myfines/d-dfdf/docs/external-reviews/report-20261020.md

# Tang Primer 20K 电子乐器 · 2026-10-20 实物测试报告

**一句话结论**：核心音频链路（合成、复音、音准比例、延迟、时钟）全部通过实测；发现一个影响作品听感的实质缺陷——**摇杆零位偏移导致整体音高偏 9 音分、所有音色被掺入约 20% 锯齿波**，建议固化前修复。

## 一、测试对象与环境

| 项 | 内容 |
|---|---|
| 板卡 | Tang Primer 20K（GW2A-18C-PBGA256）+ Dock，JTAG ID `0x0000081B` |
| 固件 | Flash 中八路光键版（`SAFE_STARTUP=1`、`ENABLE_OPTICAL=1`） |
| 外设 | PCM5102A、ADS1015 摇杆、四键 S0–S3、八路光键模块（I²C 0x12） |
| 主机 | Windows，串口 115200-8-N-1（COM5 → COM7，断电后重枚举） |
| 测量工具 | 自研 UART 遥测解码、FPGA 内部计时码流、手机录音频谱分析 |

## 二、方法：三条独立证据链

1. **遥测**：固件每 250 ms 输出一帧 `IO V E X YYY K S`，解码后得到 ADC 状态、按键、模式位；
2. **自测量码流**：为测延迟专门编译 `latency_selftime`，用 27 MHz 计数器测"引脚边沿 → 首样本"，经 UART 输出，不依赖示波器；
3. **录音频谱**：手机录制 → ffmpeg 转 WAV → FFT/Welch 分析音准、谐波、谱峰。

## 三、结果

### 3.1 启动与安全启动（通过）

| 事件 | 时刻 | 关键帧 |
|---|---|---|
| 上电出帧 | 0.11 s | `IO V0 E0 XFFF Y000 KF S11`（未解锁，PCM 高阻） |
| 解锁 | 25.59 s | `IO V1 E0 X34F Y001 K9`（ADC 有效、四键可演奏） |
| 光键上线 | 解锁后 20.0 s（`OPTICAL_BOOT_TICKS`/27 MHz） | `Y=800` |
| 光键拔线回退 | 1.2 s 内 | `X` 回到摇杆 ADC 值 |

帧周期实测 **250.0 ms，无丢帧**，即 27 MHz 时钟准确（若偏 0.5% 会显示 251.3 ms）。

### 3.2 输入通道（全部通过）

按键 `K` 值出现 `D/9/B/6/7/E`；摇杆 X 在 255–991 间连续变化；八路光键 `0x0FF↔0x0F7/0x0FB/0x0BF/…` 正常触发；断连后自动回退四键演奏。

### 3.3 演奏与参数控制（全部通过）

音色循环 `timbre 0→1→2→0`；音组 `page 0→1→2→0`；低八度 `oct` 翻转；短延迟 `echo` 翻转；ADSR 编辑 `edit` 进出（编辑时演奏静音）；32 声部 `test32` 翻转。

### 3.4 音准（通过：音程误差 ≤0.24 音分）

| 音 | 实测 | RTL 设计值 | 与 C5 的比值（实测 / 理想） | 误差 |
|---|---|---|---|---|
| C5 | 526.0 Hz | 523.17 | — | — |
| D5 | 590.4 Hz | 587.35 | 1.12243 / 1.12246 | **−0.05 音分** |
| E5 | 662.8 Hz | 659.20 | 1.26008 / 1.25992 | **+0.22 音分** |
| G5 | 788.0 Hz | 783.90 | 1.49810 / 1.49831 | **−0.24 音分** |

绝对频率整体偏高 0.53%（≈+9 音分），原因见第四节。

### 3.5 四复音（通过）

四键同时按住，频谱中同时存在 **4 个独立基频**，幅度差 3.2 dB 以内：

| 频率 | 音名 | 偏差 | 相对幅度 |
|---|---|---|---|
| 554.2 Hz | C#5 | +0.4 音分 | −2.7 dB |
| 622.2 Hz | D#5 | 0.0 音分 | −1.0 dB |
| 698.5 Hz | F5 | +0.1 音分 | −3.2 dB |
| 740.0 Hz | F#5 | 0.0 音分 | 0 dB |

四键和弦频谱

> 该次录音处于"音组 1"（C#5/D#5/F5/F#5），非默认音组 0。

### 3.6 32 声部（通过）

测试模式下 32 个振荡器（129 Hz 起、间隔 31 Hz 至 1090 Hz）逐一检出，各频点电平 −29…0 dB，间距精确 31 Hz：

32 声部频点

数字侧另经核算确认：单声部乘积 ≤±8.4M，32 路累加 ≤±268M，31 位累加器无溢出；输出幅度 ±8192（−12 dBFS）。

### 3.7 音色（功能通过，证据受污染）

三段录音的谐波含量依次递增（2 次谐波 −14.1 / −13.8 / −6.8 dB；3 次 −36.0 / −29.8 / −21.9 dB），确实存在三个不同音色，但基准波形已被摇杆 Y 偏移污染（见第四节），不能作为"纯三角/正弦/锯齿"的干净证据。

### 3.8 端到端延迟（通过，余量 10–30 倍）

37 次按键，测得"引脚边沿 → 首样本锁存"为 **1–571 周期（0.04–21.15 µs）**，平均 9.75 µs；直方图在一帧内近似均匀（每格 6.2 次期望 vs 实测 4–10 次）：

延迟分布

加 I²S 串行化 10.67 µs 后，**FPGA 数字端到端 10.7–31.8 µs（平均 20.4 µs）**；叠加 PCM5102A 滤波群延迟后仍 **< 1 ms**，相对赛题 10 ms 上限余量约 10–30 倍。

### 3.9 时钟（通过）

BCK 1.5 MHz、LRCK 46.875 kHz，比值 32:1；由遥测帧周期反证主时钟准确。

## 四、发现的问题（按严重度）

| # | 问题 | 证据 | 影响 |
|---|---|---|---|
| **1** | **摇杆零位偏移** | X 静止 ≈845（中心 825，偏 +20～+44）；Y 静止偏 ≈330 | 弯音死区仅 ±25 计数，超出后**音高整体偏 +9 音分**；Y 偏移使 `mix≈20%`，**所有预设都被掺入约 20% 锯齿波** |
| 2 | 测试模式低频噪声 | 40–200 Hz 宽带，峰值 60–68 Hz，比单音高 15 dB | 仅出现在 32 声部测试模式，正常演奏无；数字侧已排除，疑为模拟侧或录音链路 |
| 3 | 光键静止偶发多键同按 | 出现过 `0x03F`（6 路同按） | 疑为模块未按实际高度校准 |
| 4 | 音色间音高不一致 | 554.3 / 560.2 / 559.5 Hz | 同问题 1，按摇杆时位置微动所致 |

## 五、未测项与限制

- **模拟段延迟**：PCM5102A 滤波群延迟未实测（探头受地线耦合干扰，数据线空闲时仍有 ~680 mV 梳齿）；
- **温升与电流**：未测量（此前有"30 秒烫手"历史记录，原因未定论）；
- **绝对音准**：无标准参考源，现有设备无法标定；
- **冷启动重复性与长时间稳定性**：本次未做（计划中）；
- 所有音频结论基于**手机录音**，非线路输入测量。

## 六、结论与建议

**可以进入提交阶段的功能**：合成引擎、四复音、音阶音程、32 声部、参数控制、安全启动、延迟指标。

**固化前建议修复**（改动约 10 行）：上电时采集 X/Y 静止值作为零点，之后 `delta = x − zero`。可同时解决音高偏移与音色掺锯齿，且不影响摇杆正常使用。

**演示注意事项**：① 演示前确认摇杆居中（遥测 `X` 接近 `0x339`）；② 音色切换必须在不按 S 键时短点摇杆；③ 32 声部测试放在最后。

## 附：本次产物

| 类别 | 路径 |
|---|---|
| 原始遥测 | `logs/*.txt` |
| 录音与图 | `logs/audio/*.wav`、`logs/audio/chord4-spectrum.png`、`logs/audio/spectrum32.png`、`logs/latency-histogram.png` |
| 分析脚本 | `scripts/analyze-uart-log.py`、`scripts/analyze-audio.py`、`scripts/analyze-session.py`、`scripts/prepare-audio.ps1` |
| 延迟测量码流 | `latency/latency_selftime.v`（SHA256 `DA9BE9066343C27044F97FF885D213405E20A4E20E05C73E2B8AFED90AB1DFD3`，仅 SRAM） |
