myfines/d-dfdf/docs/k230-uart-sender-20261022.md

# K230 UART手势发送候选（2026-10-22）

状态：仅生成电脑端文件，未部署、未访问设备、未改FPGA、Android或Flash。Dock OTG保留供电，数据改用UART；不再要求FPGA USB host。

## 接口和接线

| 项目 | 候选约定 |
|---|---|
| 外设 | K230 UART1 |
| TX | EXPORT接口IO9，复用UART1_TXD/TX1 |
| RX | IO10不接、不配置其复用 |
| 串口 | 115200 baud，8数据位，无校验，1停止位 |
| 接线 | K230 IO9 → FPGA RX；K230 GND → FPGA GND |
| FPGA RX | 对方暂定PMOD1 M14，最终封装脚、连接器脚位及电气核对由FPGA侧完成 |
| 供电 | 继续Dock OTG → K230 Type-C；EXPORT 5V、3V3均不互连 |

亚博标准板YB-DKA02-V1.0说明书正面图片中，右侧EXPORT位于Type-C上方，该视角丝印从上到下为5V、GND、IO9、IO10。背面复用表为IO9 TX1、IO10 RX1。以实物丝印识别，不按线色或镜像后的插头序号接线。

**电平证据边界：**已核实TX映射，但目前找到的亚博UART PDF只泛指TTL可能为3.3V/5V；FPIOA PDF的“12：3.3v输出”描述电源脚，不能证明IO9高电平。尚无该板IO9电压实测或明确电源域原理图证据。接FPGA前确认IO9高电平符合FPGA输入电源域；不能把5V信号接入FPGA。电压不匹配需电平转换。供电能启动不代表信号电压已验证。

## 数据契约

复用docs/k230-gesture-protocol-v1.md的12字节包：A5 5A、版本01、递增回绕序号、valid、捏合BE16、纵向位置BE16、置信度、CRC16-CCITT-FALSE BE16。CRC覆盖2..9，初值FFFF、多项式1021。无换行、文本或额外握手。

原始检测置信度必须>=0.60；无手、多手、无效几何、HOLD和超过150ms的旧结果均发valid=0及零参数。沿用现有参数映射，捏合仍待标定。纵向位置取关键点5/17平均y，按640×480画面映射顶部0、底部1000。

发送线程目标50ms/包，不补发积压突发包。12字节在115200 8N1约占1.04ms。此前USB手势实测仅约7.49Hz；UART更换不能证明推理调度已达到20Hz。需板测实际间隔、CRC、序号及有效手势覆盖率。

底层API为machine.FPIOA().set_function(9, UART1_TXD, ie=0, oe=1, pu=1)及machine.UART(UART.UART1, baudrate=115200, bits=UART.EIGHTBITS, parity=UART.PARITY_NONE, stop=UART.STOPBITS_ONE)。使用UART.write(bytes)检查部分写入，失败停止发送并deinit，依赖FPGA既有250ms失联释放。没有应用层ACK。串口复位后序号从0开始，FPGA侧须确认失联后接受重新建立的序列。

IDE输出UART_GESTURE每秒摘要与原PINCH2记录；这些print走现有控制台，不写UART1。LCD、摄像头和模型流程保留。线程/API及错误清理行为尚未板测。

## 候选与主机验证

- 源码：k230/uart_gesture_sender.py。
- 构建：python scripts/build-k230-uart-sender.py。
- 单文件：build/k230/uart_gesture_sender_standalone.py，7743字节。
- SHA256：6c5a3ea5cddc2a4369124c142e6ad05f6848bc8f1aa132eb2097a569bd8272d7。
- 启动入口示例：k230/uart_gesture_launcher.example.py，未安装。
- python -m unittest discover -s k230 -p "test_*.py" -v：31项通过，覆盖协议、无效清零、原始置信度、过期、部分写入、仅配置TX以及独立构建不含USB发送API。
- py_compile通过。完整日志：logs/20261022-k230-uart/。

候选从既有USB发送器抽取已测试的状态和写入算法，不调用USB设备API。依赖SD现有/sdcard/pinch_preview_v2.py及其匹配SHA：ae9593ed7a9e610cd1f121d6f825f03e0797fed995b6e73bad259ab8f94371d2；不匹配拒绝运行。

## 后续部署与恢复步骤（本次未执行）

1. K230接电脑后先读取main.py、boot.py、V2及模型存在情况；把当前入口另存唯一时间戳备份，同时保留电脑副本和哈希。不要覆盖已有备份。
2. 上传独立候选到/sdcard/uart_gesture_sender_standalone.py，读回校验上述哈希；先在RAM启动测试，不先替换main.py。
3. 电平确认后，可用兼容电平USB-TTL接收器RX及GND采集IO9；接收器电源脚不接。按字节流检查CRC、连续序号、原始置信度>=60及手离开后无效清零；测量实际间隔和长时间稳定性。可同时用IDE查看LCD和控制台。
4. 运行验证通过后，才备份并替换main.py为示例入口；读回校验，重新上电检查自动启动。随后切回Dock供电并与FPGA UART RX验证。
5. 回滚时停止候选，将本轮备份main.py恢复并读回校验。候选文件可保留，不动boot、模型及原始电赛程序。

已知旧备份：/sdcard/main_electronic_contest_backup_20261020.py、main_before_pinch_v2_20261021.py、main_official_before_v2_20261021.py；以部署前实际读回为准。现有main入口仍运行pinch_preview_v2，不代表UART候选已开机运行。

## 来源

- 亚博本地标准板说明图片：E:/keil/小车源码/K230视觉模块/00.开发板资料/说明书/标准版/K230视觉模块-标准版_3.jpg。
- 本地UART例程：E:/keil/小车源码/K230视觉模块/程序源码/02.Basic/05.uart.py。
- 厂商YbUart实现：[固定提交源码](https://github.com/canmv-k230/ybsdcard/blob/f77bd8abab3309603a12c55ac970101e51579e65/ybUtils/YbUart.py)。其send/write不返回底层写入长度，因此候选直接使用machine.UART.write。
- [亚博MSPM0接线例程](https://www.yahboom.net/study/K230/15113/)：TXD(IO9)到A22、RXD(IO10)到A21，佐证映射，不能替代电压测量。
- [Kendryte UART注意事项](https://www.kendryte.com/k230_canmv/en/main/example/peripheral/uart.html)：按板卡原理图确认I/O电源域。

### 2026-10-22 实机兼容修正与安装
已备份并安装 SD 卡 main.py 入口。实际固件要求 UART1 的 RX 也配置 FPIOA，因此 IO10 配成输入并保持不接线；IO9 仍为唯一发送线。旧候选只配置 TX，在本固件会触发 RX not configured 错误。最终从已保存 main.py 运行，发送计数持续增长，摄像头正常，无异常退出；有效手势、冷启动及 FPGA 端接收尚未验收。原 main 备份为 `/sdcard/main_before_uart_E025_20261022_190536.py`。详细原始证据见 `logs/20261022-k230-uart-deploy/`。
