myfines/d-dfdf/logs/20261012-complete-review.md

# 完整功能版审查结论（2026-10-12）

功能与正确性：13组自动验证通过，覆盖模式淡出/路由、32声部帧预算与包络退出、按钮组合与长短按、延迟冲激与启动RAM屏蔽、三波形及谐波、四阶段ADSR、I2S真实串行解码、ADS地址/字节/失效/拉伸/恢复、音高/弯音/八度/中性回退、声部叠加/独立松键、十二半音及整机模式操作。32声部仿真8192样本FFT确认32个不同基频，最大FFT格点误差2.811Hz是分辨率结果，不是实测调音误差。

结构：ADC、面板控制、波形、每音符包络、四键引擎、32声部测试库、模式路由、延迟、I2S与UART分开。仅clk为时序时钟，frame_tick作使能。声部保持直接单键输入，避免之前掩码实现的实物异常。参数每音符锁存，编辑不改变正在释放的旧声部。

位宽与边界：摇杆上限1650时量化饱和，防止高端回绕；包络0..256，零时长钳位1；有符号波形/增益/总和显式扩展，四声部/32声部及效果按最坏情况限幅至约四分之一满幅。延迟RAM读出受filled屏蔽，不需假设未初始化RAM为0。指针/filled递增显式保留低位并验证回绕。UART打包12位，字段/分组/音色有独立解析自测。

性能：最终构建exit0，无WARN/ERROR；setup/hold违反端点0，27MHz约束下Fmax34.104MHz。32声部约97周期小于576周期帧预算。脚本仅对hash匹配的目标执行已识别JTAG操作；Flash使用GAO-Bridge37，非bulk erase/OTP。旧稳定bitstream单独保留。

硬件证据：用户冷启动基本演奏通过；JTAG只读UserCode7799、Status6020与目标一致。新音色/编辑/效果/32测试模式的实物逐项试听尚未独立确认，模拟频谱与端到端延迟未实测。不得将数字测试、时序通过或工具校验扩展为所有比赛指标达标。

已修复并保留证据：面板最高量化边界回绕；Gowin紧邻问号数字词法解析失败；模式/延迟指针位宽警告；一次声明先后顺序导致Icarus绑定失败；整机释放/尾音旧窗口不足；模式测试应查路由而非旧声部立即清零；新增分组后UART14位打包警告。全部最终测试和构建无相关错误。
