myfines/d-dfdf/logs/20261012-instrument-review.md

# instrument_io 代码审查

- 正确性：I²S输出在下降沿改变，左右声道每16个BCLK转换，MSB滞后一位，末位跨WS边界；从串行引脚独立解码的测试通过。ADS配置与转换读取由总线模型解码，主机ACK首字节、NACK末字节，开放漏极只驱动0/高阻。
- 错误恢复：SCL低超时、SDA低恢复、NACK和重新上线有测试。测试发现9时钟恢复计数器3位溢出问题，扩成4位后复测通过。控制值在一对样本完成后发布，交易失败清valid，声音采用中性控制。
- 可读性/结构：保留旧audio_keys独立不变，新增I2C交易、ADS管理、合成、I2S和顶层五个模块。没有操作硬件的自动脚本；仿真脚本与构建脚本分离。
- 电气：PMOD0信号约束为LVCMOS33/4mA，输入按键保持原电压；I2C双向引脚有内部弱上拉，实际外部上拉/上升时间待测。JTAG/MSPI/RECONFIG_N保留专用。板载耳放输出为0。模块3.3V供电仍必须按接线文档核对，逻辑代码不能验证供电。
- 性能：27MHz单时钟逻辑，无新PLL/内部派生时钟域。外部BCLK通过寄存器分频输出，ADC异步线使用两级同步。内部时序最终报告见checks.json；尚未对真实线缆/DAC/ADC做电气时序测量。
- 限制：首版单音；三角/锯齿混合没有抗混叠、自动轴校准或完整ADSR；46.875kHz非标准48kHz、PCM模块PLL锁定未测。四分之一数字幅度不构成耳机驱动能力。
- 验证范围：四组仿真通过，综合与布局布线成功，无最终构建警告；尚未下载/上电测试新模块，不把这些软件证据写成实物成功。
