myfines/d-dfdf/k230/README.md

# 捏合预览 V1

## 最新V2（2026-10-21）

一键启动现指向`pinch_preview_v2.py`，旧`pinch_preview.py`完整保留用于对照。V2采用新目标0.30/续跟0.18置信度滞回，去掉官方靠边宽度过滤，保留最小尺寸/边界检查；弱框只能在已有锁定位置附近参与续跟，不用于首次取得控制。两强目标仍无效。HOLD最多200ms，屏幕显示旧百分比且valid=0，超时清空；明显换位、多手、非法几何不沿用旧结果。

`PINCH2`日志前11个数据列与V1相同，末尾追加raw_boxes、box_reject、age_ms、raw_peak，帮助分清检测漏框、过滤与短暂旧值。HOLD不计入识别成功。当前12项离线测试通过；第一版低阈值实验板测产生4–6候选，已增加弱框筛选，但最终版因板上USB调试暂不响应尚未完成板测/精度对比，不能称已解决丢手。模型选择及赛题用途见`docs/k230-gesture-v2-models-20261021.md`。

以下保留V1说明，V2新阈值与HOLD以上述说明为准。

电脑已配置可双击 `open_pinch_ide.cmd` 启动（本机IDE路径E:/yolo/bin/canmvide.exe）。使用IDE官方启动参数 `-auto_connect -auto_run`；要让启动参数生效，须从IDE已退出状态启动。保持K230连接COM9。2026-10-21已备份并调整IDE配置：启用帧缓冲区、缩放，串行终端面板高度260。正常关闭后从命令行重启，确认窗口pinch_preview.py、进程有响应且COM9被占用；未使用computer-use抓图或点击，不据此声称已经目视验收实时画面。

CanMV IDE打开 `pinch_preview.py`，连接COM9后点击运行。所有自编代码在一个文件内，不必上传额外模块；依赖此前已在板上回读验证的 `/sdcard/k230_hand_keypoint_official.py` 及官方手检测/关键点模型。保留LCD及原有to_ide输出，不改main.py、UART或FPGA。

画面显示骨架、拇指尖至食指尖连线、OPEN百分比和进度条。只接受一只手，连续3帧有效后TRACK；没有手、多手、低置信度、几何异常立即无效，恢复后重新稳定。检测置信度门槛0.35，掌宽至少20像素。此模型没有逐关键点置信度；掌宽归一化只能减轻距离影响，手掌转侧、遮挡或误检仍会影响结果。

IDE下方串行终端约每200ms输出一行，例如：

```text
PINCH,64,TRACK,1,1,0.359,0.778,0.859,62,0,89
```

| 列 | 含义 |
|---|---|
| PINCH | 日志标记，尚不是发给FPGA的通信协议 |
| 64 | 帧序号，每帧递增，日志限速所以会跳号 |
| TRACK | 状态：TRACK / WARMUP / NO HAND / MULTI HAND / LOW CONF / BAD GEOMETRY |
| 1 | valid；0时百分比为--，不能当成0%或有效控制值 |
| 1 | 经过官方检测框过滤后的手数量 |
| 0.359 | 手检测置信度，不是关键点置信度 |
| 0.778 | 原始捏合比例：点4到8距离 / 点5到17掌宽 |
| 0.859 | 时间常数120ms的平滑比例 |
| 62 | OPEN百分比，临时将比例0.15～1.30映射为0～100并限幅 |
| 0 | 捏合闭合状态；平滑比例<0.23闭合、>0.33张开，中间保留状态 |
| 89 | 本帧获取/推理/绘图/显示耗时ms，不含随后GC，不是端到端延迟或完整FPS |

## 实物判断

1. 一只手正对镜头、张开和捏合各保持2秒：看raw/smooth与进度条是否跟随。
2. 姿态不变稍微前后移动：归一化比例应相对稳定，但不承诺完全不变。
3. 移走手：应NO HAND、valid=0、百分比--；重新放入先WARMUP再TRACK。
4. 放两只手：应MULTI HAND，无有效值。遮挡/转侧导致数值异常时先调整姿态，记录原始比例用于校准。

0.15/1.30只是初始范围，收集实际合拢/张开比例后修改PinchTracker.OPEN_MIN/MAX。百分比不是已校准音量，也不触发音符。不能靠此预览算完成第三表情维度；UART与FPGA映射均未实现。

## 验证

主机：`python -m unittest discover -s k230 -p test_pinch_preview.py`，覆盖归一化、滤波滞回、丢手重获、多手/低置信度/退化几何和位置突变。

2026-10-21：在实际K230短时运行成功，日志包含TRACK/WARMUP/NO HAND。日志证明接口兼容与检测状态输出，不替代用户观察实际手动作与画面对应性。首次停止旧程序发生IDE interrupt和soft reboot，等待其返回控制台后再试运行成功。未替换开机程序。原始日志见logs/20261021-k230-pinch/。

2026-10-21：V2已安装到实板 /sdcard/pinch_preview_v2.py，main.py入口已回读确认；旧入口备份 main_before_pinch_v2_20261021.py，原电赛备份保留。主机12项测试通过。最终入口能初始化摄像头并持续输出日志，实际单手效果及断电重启仍待用户验收。

USB只读探测及RAM临时发送测试见[当前固件USB接口契约](../docs/k230-usb-interface-contract-20261021.md)。已在IDE退出后的独占CDC会话收到真实12字节手势包；当前SD开机程序仍是上面的屏幕预览，没有持久启用二进制发送。USB host、最小类控制序列、Full-Speed及20Hz尚未验收，FPGA未改动。`usb_gesture_preview_probe.py`由主机探针组合加载，不是可直接替换main.py的文件。

## 手势传输协议仿真候选（2026-10-21）
新增[协议V1说明](../docs/k230-gesture-protocol-v1.md)、gesture_protocol.py与主机测试。该编码器和FPGA接收器仅离线验证，未接入pinch_preview_v2.py识别循环、未改实板UART或开机入口。现有屏幕预览不代表已向FPGA发送参数。
