myfines/d-dfdf/docs/optical-program-candidate.md

# 八光键候选程序（未部署）

2026-10-12，离线实现并验证。核心板快速发热原因仍未知，不访问板卡、不解除hardware-hold，不把仿真/编译通过当作热安全。

## 输入与演奏

- 独立I2C：SCL=T9、SDA=P9，保留ADS的T6/T7。模块地址0x12，状态寄存器0x30。
- 每次FPGA复位后等待20秒，再写0x30指针、STOP、直接读一字节；最后一个字节NACK。符合提供的MSPM0示例交互顺序，新增总线直接读分支不改变ADS带指针的重复START路径。
- 原始bit7为X1、bit0为X8，软件重排成内部bit0对应X1。每通道连续两个读样一致才改变状态，不因某一路抖动阻塞其他路。
- 读取NACK/超时立即把8键置为松开、失效后重试。声部正常释放，不强称无尾音。
- 8个光键控制最多4复音，已有按住的音符优先保留，空出的声部按输入序号分配；其他保持中的键等待空位，不突然抢占当前声部。
- 模块稳定在线后，板载S0–S3仅用于既有摇杆组合/包络编辑，不再直接演奏。模块等待/断连时自动回退原板载四键演奏。
- 使用原4个相位/ADSR声部，缓存光键频率、分配时重触发包络。复用原摇杆弯音、音色、低八度、延迟和32测试模式；编辑/测试模式释放光键分配。

## 音符分组

按住板载S0并短按摇杆切换分组。光键X1到X8：

| 分组 | X1–X8 |
|---|---|
| 0 默认 | C5 D5 E5 F5 G5 A5 B5 C6 |
| 1 | C5 C#5 D5 D#5 E5 F5 F#5 G5 |
| 2 | G5 G#5 A5 A#5 B5 C6 C#6 D6 |

低八度对整组生效。原板载回退模式的C/D/E/G等三组音符仍不变。

## 触发极性与校准

默认ACTIVE_LOW=1：厂家黑线0作为触发、白面1作为松开。若实际使用黑色静止背景、白色/手指反射作为触发，应在instrument_optical_top参数中选ACTIVE_LOW=0重新构建，两种极性都已数字测试；不能猜手遮住必为0。模块必须先在实际高度独立完成黑/白校准，通信ACK成功不代表校准成功。

## 构建与验证

运行 instrument_io/build_optical_candidate.tcl 生成单独项目：E:/gaoyun/projects/instrument_optical_candidate/instrument_optical_candidate。top为instrument_optical_top；默认build.tcl仍禁用新模块，防止误替换旧工程。

18组回归通过：新增分配器、传感器协议/极性、8音高/和弦、双I2C与PCM整机/断连/回退/恢复，及原14组低活动/波形/音符/模式/效果/ADSR/I2S/ADS测试。额外高有效极性与UART解码自测通过。首次整机编译有声明先后绑定失败，已修正并保存日志。

最终Gowin构建exit0、无WARN/ERROR，setup/hold违反端点0，Fmax33.020MHz满足27MHz内部约束，DSP约54%。SHA256 634F999761F85049B0EF3EEB473D53CB972A2B71EE08795B4DDD97C76B7FB234。所有这些均为离线证据，未验证实际模块电平、轮询时延或温升，未烧录。

## 串口变化

Y字段bit11为optical_online。在线时X字段改为8个过滤后光键松开位（bit0=X1，0=触发），不再是摇杆X ADC值；不在线时仍为ADC X。K仍报告板载4键。read-instrument-status.py解析为optical_online、optical_pressed_keys，同时保持原模式/音色字段。E/V仍是ADS状态，不把它们误称新模块错误码。

接线见wiring-all-current.md。供电/热安全条件未核实前只保留候选，不能直接用旧烧录脚本绕过热故障暂停。

## 2026-10-13 实机极性修正与手动启用

用户在旧低有效候选上确认能演奏、持续响、遮挡会改变声音且目前不烫；根据实际用途将instrument_optical_top的ACTIVE_LOW默认改为0（模块原始高电平触发），不改变通道次序或I2C协议。传感器原始高低由反射/背景/校准决定，不代表厂家黑白定义错误。

safe候选默认外设未启用：按住S1+S2，向下按压并松开摇杆，最后松开两键，切换启用状态；重复相同动作会关闭。启用后等待20秒再开始八路轮询。关闭时I2S输出高阻、两个I2C控制器复位释放总线，取消内部I2C上拉；这些措施不替代硬件电源隔离，不证明未供电器件不会被反向供电。

软件采用原四声部低活动改进，Flash保持7799。本次3.3V供电为用户选择，厂家只明确5V供电，不能以一次通信/演奏成功证明长期供电或热安全。若没有遮挡仍发声，必须进一步核对背景、探头高度与校准，不应继续猜极性。
