myfines/d-dfdf/docs/competition-closeout-20261022.md

# 赛题收尾与交互改进（2026-10-22）

以官方选题二和用户提供FAQ为依据。当前用户确认E026手势及新版协议APK联动成功，短时硬件运行正常。历史温升事件根因仍无测量结论，但本轮不再把采购或换板当作软件推进的前置条件。

## 当前已实现

- HDL逐样本合成、I2S DAC、四声部、实时变调、ADSR、混音、硬件短延时。
- 光键、摇杆、K230串口手势；E026使用原tracker有效性和单帧同步发送，去除附加60%过滤及后台重放。
- FPGA OLED波形，Wi-Fi与Android实际联动，触屏键位重排和CSV事件导出。
- 32独立振荡器测试库与历史频谱证据；其固定频率/AR性质不能描述为32路完整可调演奏引擎。

## 剩余工作与验收门槛

| 顺序 | 工作 | 完成判据 |
|---|---|---|
| 1 | 输入延迟预算与测量 | 独立记录本地光键、摇杆与视觉路径；以输入电信号和DAC输出同步采集验证10ms/5ms，不能用主机串口时间替代。视觉路径单独标注，不承诺模型帧率可满足5ms。 |
| 2 | 32规模合成完善 | 独立phase/FCW/ADSR状态，参数写入与帧边界快照，状态不串扰，32活跃输出可复现；保留测试模式与RTL/资源/时序证据。 |
| 3 | 乐器音色与表现 | 至少两种可辨识乐器音色，不能仅把三种基础波形改名为乐器；分别验证弯音、明亮度、捏合音量等独立控制及延时效果。 |
| 4 | 曲目指引 | FPGA节拍/曲目事件时序，OLED显示目标键和进度，LED给出节拍；断网可运行。心跳不能当曲目引导。 |
| 5 | 手机扩展 | 在线曲谱下载及格式校验、传输、脱机存储策略；真实录音回传需要音频采集链路，不把CSV或32点波形冒充录音。Wi-Fi不冒称蓝牙。 |
| 6 | 最终封版 | 定量包络/释放、持续运行、SRAM验收后Flash校验与冷启动，报告匿名性、演示脚本、版本与原始证据对应。 |

不能保证所有扩展满分，评分由赛事决定；上表尚未完成的项目不能提前勾选。

## 本轮可用的交互改进

Android0.4直接打开Wi-Fi演奏台；连接/取消/断开动作有独立文案；音色使用具体名称；内置启用、光键、摇杆、手势的操作指南；手机本地音频预览移至辅助入口。旧0.3保留，协议仍兼容S/G两种状态帧。未修改已实测的E026硬件配置。构建与Java测试通过，手机界面实际验收待做。

后续交互：演奏页仅保留必要控制，参数编辑/测试/曲目各有明确模式及退出；先明确协议与状态反馈再减少组合键，避免移除组合键却无可用入口。

## 开源参考与采用边界

- 官方要求：https://www.gowinsemi.com.cn/university/match2026
- FPGA Music：https://github.com/cyb0124/FPGA-Music （参考多音轨时序与合成分层）
- tiny-synth：https://github.com/gundy/tiny-synth （参考声部、振荡与包络的模块边界）
- FAQ记录：docs/competition-audit-20261018.md，明确TDM共享运算不妨碍独立声部计数。

本轮阅读项目说明，未复制外部源代码；后续如复用须先核对许可证、器件成本、数值位宽与时序，不承诺开源项目可直接在本板运行。
