myfines/d-dfdf/docs/fpga-review-brief-20261020.md

# FPGA电子乐器工程简介／技术审阅交接

日期：2026-10-20。仓库：https://github.com/myfines/d-dfdf
赛题：2026高云赛题二《基于FPGA的实时多音色合成电子乐器引擎》。要求来源：https://www.gowinsemi.com.cn/university/match2026

## 当前系统
Tang Primer20K＋Dock（GW2A-18C），八路光电巡线模块作为光键、PS2双轴摇杆经ADS1015采集；FPGA HDL完成振荡器、包络、混音和短延迟，通过16bit I2S送PCM5102A，再接有源音箱。输出采样率46.875kHz。音频不是播放整段录音，不通过MCU/CPU软件合成。

当前已验证Flash为CF73光键安全启用版，码流SHA256：B6A4D22C1EEB8343C0C97870C45059BAA3F1198F758271A82BFA0C09FA07E547。更改后须核对版本，不将工作目录内任意最新.fs认作板上现有版本。部分根README和instrument_io/README保留早期快照；当前进展以docs/operations.md、competition-audit-20261018.md及对应原始日志为准。

## 严格按赛题对照
| 赛题条目 | 当前实现与证据 | 未完成／不能宣称的内容 |
|---|---|---|
| 基础：至少2个独立演奏维度 | 八光键选音/触发，摇杆X连续弯音、Y调适用预设波形亮度；已有逐键、摇杆实录 | 量程/中心校准与逐轴解耦未定量验收 |
| 基础：FPGA HDL逐样本实时合成、I2S DAC | 独立相位振荡器、实时包络/混音；I2S和实际DAC发声通过 | 最终版本资源/时序、数据流和可复现构建证据需整理成正式材料 |
| 基础：至少4独立同时声部 | 八输入分配到4演奏声部；实际DAC录音同时检出X1–X4对应四基频，逐键音高及全释放静音已验证 | 八光键不等于8复音；持续音下单独释放一声部且其他继续响的完整音频验收尚缺 |
| 基础：实时变调、ADSR、混音 | HDL完整四阶段ADSR，组合键现场编辑A/D/S/R；弯音、编辑流程及仿真通过 | A/D/S/R参数各自响应时间和电平未逐项量化 |
| 基础：控制到输出总延迟≤10ms | 尚无合格同步测量 | 不能以“听起来即时”或UART主机时间证明达标。需动作/传感器输出、接口、HDL、DAC分段及总延迟；FAQ73引用的技术103正文尚未取得 |
| 拓展：≥32复音或≥32单音加法分量等 | 独立32相位/包络状态的TDM测试库，共享算术；129+31*n Hz，n=0..31；实际录音32目标峰均满足既定检测阈值 | 当前固定频率、简化AR包络，非32路自由演奏或完整可调ADSR。FAQ77认可独立phase/FCW/ADSR的TDM声部统计，共享算术本身不构成问题 |
| 拓展：≥3维表情、≥2乐器音色、硬件效果 | 三角/正弦/锯齿拨弦三合成预设，硬件2048帧短延迟，约43.69ms；音色切换已实测 | 两种可辨识“乐器音色”尚不足；第三独立表情维度未完成；延迟分量未独立量测，不能称效果器已全验收 |
| 拓展：≤5ms确定性与视听反馈 | 心跳/状态LED已有 | ≤5ms和确定性未实测；心跳不等于演奏指引、频谱或曲目引导 |
| 拓展：脱机LED曲目指引／App联动 | 脱机Flash启动已验证；另有Android预览原型 | 脱机启动不等于曲目指引；手机只有本地合成预览/命令记录桥，无真实FPGA接收端，不计核心成果或已完成联动 |
| 现场：多频谱峰与RTL佐证 | 4声部和32测试频谱原始录音、UART、分析JSON已入库 | 需绑定最终源码/码流/资源时序，准备现场复现与讲解 |

## 请优先帮忙审阅
1. 光键读取/I2C轮询、消抖、声部分配、包络、I2S的总延迟预算，确定≤10ms可达性和测量方案。
2. 四声部释放/重触发及TDM状态隔离；32库如何完善为可独立调频和包络的合规合成能力。
3. 两种乐器音色的合成方案、第三表情维度、包络/混音定点位宽和削波风险。
4. 曾发生GW2A大芯片30秒内烫手并失声，断电后恢复，后续短时演奏正常；根因未明。检查约束、I/O电平/争用、供电与外设反灌、活动率；无实测温度电流，不预设为单纯散热问题。

八路模块标5V脚目前按用户选择接Dock3V3，厂商额定兼容未确认。PCM独立USB供电，排针+3.3V不接，信号共地。不要未经电气核对直接改接5V逻辑。

## 文件入口与协作边界
- instrument_io/：HDL及testbench；instrument_optical_top.v为光键顶层入口，voice_engine.v、adsr_runtime.v、spectrum_bank.v、optical_key_allocator.v、short_delay.v为重点。
- docs/operations.md、docs/competition-audit-20261018.md：进度与验收口径。
- logs/20261015-*：八键、四音和弦、摇杆、音色、32谱峰和未完成测试的原始证据。
- docs/optical-key-uart-handoff-2026-10-17.md：另一轮交接摘要，原始文件尚待补齐，不当作本轮重新执行的测试。
- instrument_io/run_tests.ps1：离线仿真入口；迁移机器需调整工具路径。光键在线时S0–S3是功能键，非同时演奏键。

用户已授权Shengzj2026修改仓库。建议修改走分支/PR，说明仿真与时序结果；先SRAM验证，保留已验证Flash，勿擅自执行Flash/OTP/下载器固件操作。现场限时测评据FAQ不得用AI，参赛者需独立掌握状态机、仿真和实现原理。

板卡口径：用户提供FAQ A1/66明确推荐清单外的高云FPGA板卡也可使用，不因Primer20K未在推荐名单而要求换板。最终交付报告/视频需按FAQ检查学校信息匿名性。
