myfines/d-dfdf/docs/competition-audit-20261018.md

# 赛题对照复核（2026-10-18）

官方原文：https://www.gowinsemi.com.cn/university/match2026 （本日重新读取选题二、评分标准、适配板卡与提交日期）。GitHub复核基线 a74517a；本轮无RTL、Flash或硬件操作。

结论：现有光键＋摇杆→FPGA HDL合成→I2S→PCM5102A符合主线；手机本地软件合成不能充当比赛核心成果。手机功能暂降为附加项目，优先补基础指标。

| 项目 | 当前证据 | 剩余工作 |
|---|---|---|
| 至少2独立演奏维度 | 八光键选音、摇杆弯音/波形，10月15日实际音频记录 | 校准、轴解耦与稳定性说明 |
| HDL逐样本生成、I2S DAC | voice_engine/wave_source/adsr_runtime/short_delay，已有实际DAC录音 | 固定最终RTL/码流版本，资源/时序及数据流佐证 |
| 至少4独立并发声部 | X1–X4四基频同现、释放后底噪记录 | 持续音预设下单独释放与重触发，声部不互相截断 |
| ADSR、实时变调、混音 | HDL与仿真、编辑流程、弯音实录 | 独立A/D/S/R参数响应定量测量；流程通过不等于参数全验收 |
| 基础总延迟≤10ms | 尚无合格实测 | 从实际演奏输入到DAC输出同步测量，含传感器内部响应/I2C轮询；电脑UART到达时间不可充当输入时间基准 |
| 32规模拓展与现场测试 | spectrum_bank有32独立phase/level状态，实际32目标频点均检出 | 当前频率硬编码、AR包络、共享运算的测试库，不是32路自由演奏；需完成可控频率/包络与现场可解释证据，不只靠谱峰宣称全部拓展通过 |
| ≥3维表情、≥2乐器音色、硬件效果 | 有三预设、X/Y、短延迟 | 第三独立表情维度、两种乐器音色辨识度、延迟分量实测；菜单/参数切换不能直接等同独立表情维度 |
| ≤5ms确定性、视听反馈、脱机曲目指引 | 未完成充分证据；心跳不是曲目指引 | 基础通过后再做LED节奏/曲目指引及低延迟优化 |
| App联动 | 手机预览与命令记录原型 | 无真实FPGA接收端，不算已完成联动；无需为此改变核心合成通路 |

## 必须先处理的风险与口径
- 官网选题二适配列 Nano20K / Primer25K / Mega60K / Mega138K，未列现有Primer20K。通用板卡目录收录Primer20K不等于本题批准；请向官方指导群确认现有板卡是否允许，不能自行认定违规，也不立即要求购板。
- 曾有FPGA大芯片30秒内烫手并失声，根因仍未查明。短时正常不等于热稳定验收。需供电、温升、外设电平/反灌、约束/驱动冲突检查。
- 八路模块使用Dock3V3是现有接线选择，尚未确认厂商额定兼容，需单独验证。
- 新增57d8ba3交接文档明确原始联调文件未提供；其中其他机器路径和COM号不能覆盖本机已验证环境。没有原始证据的交接结论不升级为验收通过。
- 官方截止2026-11-04 18:00，最终报名系统的材料格式/模板仍需核实；准备报告、原理图/接线、RTL、仿真、资源/时序、实测原始数据、演示视频及复现步骤。

优先顺序：板卡资格确认与电气/温升风险→≤10ms同步测量及四声部/包络验收→两音色/第三维/效果器→32规模能力完善→LED脱机指引→手机附加功能。现阶段不因本次复核立即采购。

## 用户提供FAQ后的修正（2026-10-18）
来源：用户粘贴的《2026年高云杯竞赛常见问题汇总》，链接 https://docs.qq.com/sheet/DUXVvYWhsUmRhaVFI?rtkey=&tab=BB08J2 。正文含往届搬运、整理者解答及未答项目，不把所有条目均标为组委会正式公告。

- A1、66、83明确允许推荐清单以外、以高云FPGA为主芯片的板卡，推荐仅为技术推荐。因此Primer20K不在题目列表不再列作当前资格阻碍，不需要为此换板；如后续正式通知冲突再核对。
- 77明确：TDM共享算术、各voice独立phase/FCW/ADSR状态的32voice按32计。此前对共享运算可能影响数量统计的疑虑应消除；当前spectrum_bank独立phase/level，但频率硬编码、包络AR，仍不能直接声称已实现该示例的32路完整可控声部。4复音×8独立加法分量等路线也可参考75，须有真实独立状态和活跃输出证据，不计普通波形谐波。
- A2区分通用CPU软核与专用状态机/串行加速器。现有HDL TDM合成不因共享运算而成为CPU软核；核心音频和用于赛题加分的实时视觉仍保留纯HDL。
- 68允许串口屏配置模式、参数；手机作为控制面可以是合理附加功能，但本地软件发声不充当FPGA合成成果，现原型尚未接入真实FPGA控制。
- 73引用技术问题103，74未答；本次粘贴内容未包含103，不能据此定论≤10ms起算点。继续记录完整链路并保留传感器/I2C/FPGA/DAC分段测量，待103正文补充口径。
- 15要求作品报告、视频、演示、队名不出现学校信息；最终交付前检查匿名性。46称现场限时任务不得使用AI，须团队自行掌握状态机、仿真和代码解释；不能把日常AI辅助开发直接推断为现场可用。

更新后的主优先级：基础延迟及包络/独立释放实测、供电温升根因、两种可辨识音色与第三表情维度、32规模可控能力与现场证据、LED脱机指引和交付材料。板卡推荐名单和TDM共享算术不应继续拖慢开发。
