myfines/d-dfdf/docs/competition-gap-20261012.md

# 电子乐器赛题差距清单（2026-10-12）

依据：https://www.gowinsemi.com.cn/university/match2026 ，选题二基础、拓展、现场验证要求。状态基于当前9DA141...E561复音码流及用户冷启动反馈。

| 项目 | 当前状态 | 缺口 |
|---|---|---|
| HDL逐样本实时合成，不播放录音 | 已实现四相位振荡器与实时波形混音 | 准备RTL演示证据 |
| 至少两维交互 | 摇杆X弯音/Y波形，四键选音 | 中心/量程校准、稳定性与交互设计说明 |
| 至少4独立声部 | 已实现四声部，混音试听及冷启动通过 | 四键同时活跃的独立谱峰测量 |
| 单音变调 | 连续弯音、低八度 | 调音/音高准确度实测 |
| ADSR包络调控 | 只有固定起音/保持/松键延时/衰减 | 缺独立Decay阶段和可调Sustain、完整A/D/S/R参数与验证 |
| I2S输出DAC | PCM5102A已发声 | 当前46.875kHz不是标准48kHz；标准采样时钟是改进项，官网该题并未硬性指定48kHz |
| 控制到音频延迟<=10ms | 未实测 | 用示波器同时观察动作信号和DAC模拟输出，测量按键及摇杆路径 |
| 现场多频测试模式及频谱佐证 | 无专门测试模式/实测谱图 | 独立不同频率声部、谱峰、实际采样率和资源/时序说明；勿将波形谐波数当复音数 |
| >=32复音或32加法分量或并行物理模型 | 未实现 | 拓展加分，不是基础4复音门槛 |
| >=3维表情、>=2乐器音色、硬件效果器 | 有弯音/波形和低八度，但无成熟预设或力度控制 | 音色预设、可调包络、第三独立连续表现维度、延迟/合唱等 |
| <=5ms确定性延迟与实时视听反馈 | 未实测，只有心跳/ADC状态灯 | 测量及演奏指引/波形显示等拓展 |
| 脱机LED曲目指引、蓝牙/App | 未实现 | 拓展可选，不要为了数量挤占基础完善时间 |

建议顺序：完整可调ADSR；测试模式及四复音频谱；延迟测量和交互校准；两种可区分的音色；资源评估后做32声部与一种效果器。48kHz改进与抗混叠属于工程质量，勿虚构成官方硬性指标。当前音质受音箱限制尚未量化验收。现有硬件可继续完成多数基础开发，不需因这份清单立即采购。

后续更新：完整四阶段ADSR已实现并仿真通过、载入SRAM；当前仅HDL参数配置，现场实时参数控制及实物包络/端到端延迟测量仍待完成。

2026-10-12最新：现有硬件版已加入实时ADSR编辑、三预设、12音分组、硬件短延迟、32独立状态测试库、多频测试入口与数字频谱证据。最终7799已Flash校验和基本冷启动通过。真实<=10ms延迟、DAC模拟谱峰/音质、新模式逐项实物验收及第三连续表情维度仍待完成，见instrument-user-guide.md。

2026-10-12热故障：现发布7799已报告GW2A在30秒以内烫手并间歇失声，暂停继续上电。空闲活动修正仅离线测试和编译，尚未证明热根因或热安全，不能将之前Flash/冷启动通过当作可继续运行的依据。

## 2026-10-13 八光键Flash版后的差距复核

重新核对高云官方选题二：https://www.gowinsemi.com.cn/university/match2026 。当前Flash为CF73高有效八光键版，GAO37写入校验通过；新版全断电冷启动的八路验收尚未获得明确结果（用户随后询问启用方法）。

已实现：HDL实时合成、I2S DAC、8光键分配到4演奏声部、摇杆X/Y、实时四阶段ADSR编辑、三合成预设、短延迟效果、独立状态32多频测试库。8输入不等于8复音；32库目前是测试模式而非32路自由演奏。

优先缺口：
1. 供电/温升实测与旧快速发热根因；八路3.3V电源额定兼容未确认。
2. 完整冷启动与八路逐通道、四音和弦、释放/重触发验收及安装校准。
3. 官方基础<=10ms端到端实测；巡线模块内部检测/I2C响应也必须计入，不能只量FPGA管线。
4. DAC模拟多频谱峰、音高、包络与采样率测量和RTL/时序资源证据。
5. 拓展：32路测试进一步完善可控频率/包络与实测证据；至少第三独立表情维度，乐器感更强的>=2音色；<=5ms确定性与演奏可视化、脱机指引尚缺。蓝牙/App属于可选拓展。
6. 供电与机械连接整理，完整报告、演示视频、复现说明及最终验收表。

官方适配列表当前有Nano20K、Primer25K、Mega60K/138K，未列用户Primer20K；应通过参赛官方确认该已报名题目允许现有板卡，不自行认定违规或要求立即换板。

建议下一步先完成电气稳定性与基础指标验收，再完善32分量及第三表情维度，不先堆蓝牙/App。官方当前作品提交时间2026-11-04 18:00（北京时间）。
