myfines/d-dfdf/docs/reference-review-2026.md

# 用户资料核对记录

日期：2026-09-26。目录名称不能作为文件年份和板卡适用性的依据。本轮完成目录清点、ZIP 内容清单检查、三份关键 PDF 的文字提取与相关内容审阅；2026 指南关键页已用 Poppler 渲染并目视核对。没有声称已精读所有旧板卡手册，没有运行压缩包工程。

## 2026 指南：修正平台资格结论

文件：`全国大学生嵌入式芯片与系统设计竞赛'2026FPGA赛道选题指南-高云半导体.pdf`。

本地来源：`C:/Users/zrk/Downloads/2019-2021往年板卡资料/`，22 页。

SHA256：`92c74c7c6216f7d67d442339ae10d5e5c4141d6ddce4d2508e36a65d7645328d`。

- PDF 第 13 页 / 印刷页码 11，“自备开发板”：明确允许第三方以高云 FPGA 芯片为核心的开发板参赛。
- Primer 20K 的 GW2A 是高云 FPGA，因此符合此项平台条件。此前仅凭官网推荐列表留下的“资格待确认”已解除；无需因为型号没列在推荐清单里而换板。
- PDF 第 15–16 页 / 印刷页码 13–14：电子乐器的交互维度、纯 HDL、复音、ADSR、I²S、延迟和现场频谱验证，与此前官网调研一致；原设计方向继续适用。
- 第 18 页的 40%/25%/20%/10%/5% 权重属于机器人题，不能套到电子乐器。电子乐器按自己章节的振荡器统计和吞吐量规则准备证据。
- “允许自备板”只解决平台适用性，不证明 32 声部、延迟、音质等工程目标已经达到。

## 学习资料索引

文件：`高云FPGA学习资料整理（更正链接）.pdf`，10 页。

来源目录：`C:/Users/zrk/Downloads/高云板卡（部分）资料及开源项目资料（部分资料需科学上网）/`。

SHA256：`b280835d753bfdda509276de1f42e2ae8a1a9107429f8e9c7bd4b8578c6fe93e`。

与当前任务关联最高的资源：

| 资源 | 当前用途 | 使用边界 |
|---|---|---|
| [Sipeed Primer 20K 官方例程](https://github.com/sipeed/TangPrimer-20K-example) | 对应板卡接口、按键及 PT8211 音频参考 | 当前本机已有 PT8211 代码；仍须核对协议和引脚 |
| [双通道 DDS](https://gitee.com/xiaowuzxc/gowin_dds) | 相位累加与频率控制的候选参考 | 本轮只从资料提取链接，未验证当前仓库内容或许可证 |
| [FIR 示例](https://github.com/huangjintaoa/Gowin_FPGA_IP_FIR_filter_design) | 后续音色处理候选参考 | 未评估资源、延迟和可复用许可 |
| [SSD1306 OLED 示例](https://github.com/lupyuen/fpga_oled_ssd1306) | 后期可视化候选参考 | 非首版必需，不据此现在购买屏幕 |

摄像头、视频、PCIe、软核 CPU 等资料暂不进入电子乐器核心路线。外部项目采用前须审查接口、器件、许可和正确性，不能直接烧录现成码流。

## 2025 宣讲：经验材料，非今年评分表

文件：`高云杯2025开题宣讲PPT-黄一川.pdf`，25 页；两个目录内的同名文件内容相同。

SHA256：`77e7232f817ff1a080fd3382af5ce915e35c10bd8019f2ebe46bd2e14c968119`。

- 第 15 页：先完成基础，扩展围绕作品用途，避免无关功能堆叠。支持当前先 4 复音、再 32 声部及演奏表现的顺序。
- 第 16–20 页：报告和演示需要直观证明功能，尽量让操作、作品和输出在同一演示流程内。建议设计统一的演奏/测试模式，用同一码流演示交互、复音和测量。
- 页数、获奖概率、视频重要性等表述中含个人经验，不能当作 2026 强制规则或获奖承诺。
- 软件版本、等待布局布线等建议有其历史上下文；不因此改动本机刚验证成功的下载环境，也不能用“等待即可”解释 USB 通信错误。

## 旧板卡手册与 ZIP

Combat、Runber、Ministar、DDR 和摄像头工程可作 HDL/接口学习材料；它们不是 Primer 20K Dock 的引脚依据。压缩包包含历史生成文件及码流，未执行、未烧录。2023 晋级名单与本次技术设计无直接关系。

原始资料保留在用户 Downloads；提取文本与关键页预览保存在 `E:/gaoyun/docs/reference-extracts/`。仓库仅提交这份核对结论及文件清单/哈希，不复制整套原始资料或厂商工程。文件清单见 `logs/20260926-reference-inventory.json`。

## 对方案的实际影响

1. 保留 Primer 20K，不新增主控板采购。
2. 继续 4 复音达标、32 声部扩展、双轴表情和标准 I²S 的设计。
3. 优先研究对应板卡官方音频接口及 DDS；OLED、DDR3、复杂效果器后置。
4. 从一开始保存延迟、采样率、多谱峰和 RTL 对照证据；2025 展示经验可辅助组织材料。
