myfines/d-dfdf/docs/k230-bringup-20261020.md

# K230独立启动与手势输入记录

2026-10-20；当前仅完成主机资料检查，未连接板卡、未写卡、未运行模型。

## 已核验资料

来源：`E:/keil/小车源码/K230视觉模块/程序源码/08.Body/06.hand_keypoint_detection.py`。

- 手检测 `/sdcard/kmodel/hand_det.kmodel`，输入512×512，标签 `hand`，阈值0.2，NMS 0.5；固定anchors需与配套模型保持一致。
- 关键点 `/sdcard/kmodel/handkp_det.kmodel`，输入256×256。检测采用NCHW uint8、114填充与缩放；关键点采用检测框裁剪与双线性缩放。不能直接替换成任意YOLO模型。
- 默认LCD、图像及显示均640×480；`run()`返回检测框列表和对应关键点数组。关键点结果已变换为显示坐标，后续计算须保持同一坐标系，避免非等比显示扭曲距离。
- 在资料目录按文件扩展名搜索未找到上述两个独立模型；不代表镜像内不存在。已找到固件压缩包 `CanMV_K230_YAHBOOM_micropython_V1.4.3-3.img.gz`（263549449字节）。尚未检查镜像内部或验证模型/运行时匹配。
- `nncase_runtime`导入不等于版本兼容。必须回收实际固件信息、模型来源/哈希及加载推理结果；未暴露版本时不猜测版本号。

## 下一步实测

1. 用户说明是否已写卡、能否启动/看到摄像头、具体例程和完整报错。
2. 已能进入CanMV时手动运行 `k230/preflight.py`，回收完整输出；该脚本只读文件元信息和导入库，不自动加载模型或初始化摄像头/串口。可能导入库自身有初始化行为，须在独立K230上运行。
3. 按亚博配套固件与模型原样运行05手检测、06关键点，记录完整异常、FPS、显示方向与关键点索引。无逐点置信度输出时不能虚构关键点置信度。
4. 验证后再实现拇指尖/食指尖距离除以掌宽（候选索引4、8及5、17，先观察确认）；加入检测置信度、稳定帧/滞回、平滑、丢手恢复。默认不触发音符，多手选择与换手恢复须明确。
5. 之后定义版本化串口协议、序号、有效标志、参数、校验和超时；先做电脑离线与串口验证，再讨论FPGA接收端。当前尚无已实现协议或手势固件。

## 约束与未完成项

K230独立5V USB供电，不接FPGA3V3。保持FPGA Flash和RTL不变。64GB卡兼容性未知；任何覆盖前先只读识别物理磁盘、备份并取得明确目标覆盖授权。没有执行格式化或烧录。FPS与端到端响应需单独测量，不能声称手势路径≤10ms。官方例程及模型贡献如实归属，不上传授权不明的大模型。第三演奏维度仅在完整硬件联调验收后计入。
