myfines/d-dfdf/logs/20261023-工作日志.md

# 2026-10-23 · FPGA乐器 Android 控制端工作日志

- 项目：`myfines/d-dfdf` / Tang Primer 20K 电子乐器
- 范围：Android 控制端 APK（`com.fpga.instrument`）与可选的 E027 8 键固件构建
- 本日最终 APK：`mobile-companion-fpga-instrument/apk/FPGA乐器.apk`，v1.3.1-song
- 说明：本文是工作日志，不是实物验收报告；本日没有烧录、没有写 Flash、没有下载 SRAM，也没有完成真实手机/整机联调。

## 1. 本日结论

1. APK 从“方形八键”改为**单排钢琴键**，保持深色霓虹风格；8 个白键可演奏，黑键为造型。
2. 新增**键位设置**：八个位置可自定义音高顺序，自动交换重复项并持久化；4 键兼容模式按低音区/高音区分组编辑。
3. 新增**APK 侧脱机演奏**：不修改 FPGA RTL，由 APK 按节拍发送 `P/K` 命令自动演奏《小星星》；最终版为完整三段 42 个音，约 25 秒。
4. 保留卓易通/鸿蒙兼容处理：targetSdk 32、旧版全屏 API、Wi-Fi/Network 兜底、崩溃日志。
5. E027 8 键增强码流完成离线构建与仿真；未上板、未烧录。

## 2. Android 版本迭代

| 版本 | versionCode | 主要变化 |
|---|---:|---|
| 1.2-piano | 3 | 单排钢琴键；黑键造型；targetSdk 32；移除 WindowInsetsController/cutout 调用；崩溃日志 |
| 1.3-song | 4 | 键位设置；脱机演奏《小星星》14 音；APK 侧 P/K 音序器 |
| 1.3.1-song | 5 | 删除设置页说明文字；《小星星》扩展为完整 42 音（约 25 秒） |

### 2.1 钢琴键

- 8 个白键 C5–C6，支持多点触控；
- 5 个黑键按 C 大调位置绘制，不单独发声；
- 按到黑键或键缝时映射到最近白键，避免死区；
- 保留原界面的深色背景、青/紫霓虹、右侧音量/音色/K230/波形布局。

### 2.2 键位设置

- 设置 →“键位设置”：8 个位置分别选择音高；
- 选择已占用音时自动交换两个位置，避免用户反复试错；
- “恢复默认”恢复 0..7 顺序；
- 4 键兼容模式：低音区/高音区各 4 个位置，组内不能重复；
- 使用 `SharedPreferences` 保存 `eight_order` / `low_order` / `high_order`；
- `InstrumentController.sendMask` 与 `InstrumentView.noteName` 使用同一排列。

### 2.3 脱机演奏

- 设置 →“脱机演奏《小星星》”，APK 内部按节拍发送 `P/K`；
- E027 8 键模式：`P00` + 8 位 `K`；
- E026/E023 4 键兼容：同一音通过 `P00/P01/P02` + 4 位 `K` 发出，适合单音旋律；
- 播放时点任意琴键停止；切后台、断线、离开设置也会停止；
- 只改 APK，不修改 FPGA 程序；
- 这是“无人按键自动发送命令”，手机仍需连接 FPGA；不是把曲谱写入 FPGA 后脱离手机播放。

## 3. 构建与测试

### 3.1 Android

构建入口：`mobile-companion-fpga-instrument/build.ps1`

最终结果：

```text
ProtocolTest: 42 checks passed
WifiClientTest: 14 checks passed
SongTest: 218 checks passed
```

APK：

```text
package: com.fpga.instrument
versionCode: 5
versionName: 1.3.1-song
minSdk: 26
targetSdk: 32
APK size: 95,017 bytes
SHA256: DFB82342C5FE233FF2BCD0383A078B0F657B6990DBC18964946906A9E19DADF6
```

签名：

```text
v1: false
v2: true
v3: true
```

`aapt dump badging`：`application-label: FPGA乐器`，`screenOrientation=landscape`。

### 3.2 E027 固件（离线）

- 基于 E026 的 `instrument_io`，仅改 K/8 键路径：
  - `esp_volume_parser`：K 接受 `00..FF`；
  - `esp_at_control`：`remote_keys` 4 位 → 8 位；
  - `instrument_io`：新增 `remote_allocator`，8 键分配到 4 声部；
  - 旧 4 位 K 命令保持兼容。
- Gowin V1.9.11.03 Education，GW2A-LV18PG256C8/I7，UserCode `0xE027`；
- 结果：Fmax **27.947 MHz**（约束 27 MHz），setup/hold 违例 **0/0**；
- 资源：Logic 54%，CLS 68%，DSP 63%，BSRAM 9%；
- 仿真通过：`tb_remote_allocator`、`tb_esp_kff`、`tb_wifi_commands`、`tb_esp_at`。

产物（目标仓库路径）：

```text
firmware/e027/instrument_e027.fs
  SHA256 BCA1A95F00E802A357BEE5AA9691C68D2D17B7AB4B5A55EDAFA13443C1C2890C
firmware/e027/instrument_e027.bin
  SHA256 5C554021FD37CAA2C0DC3C83109F2DFE834D67194C0C18873606A3B6A890E691
```

**E027 未上板、未烧录、未冷启动、未做音频/温升/长期运行验收。**

## 4. 现场观察与已知限制

以下是用户反馈的现场现象，不等于已完成硬件验收：

- 手机上 APK 当前显示 **S 帧**，说明板上运行的是旧 **E023**，没有 K230 手势接收；
- K230 手势从 E025 起才进入 `G` 帧；要让 K230 工作，板上需运行 E025/E026/E027 的 G 帧码流；
- E026 之前可能下载在 SRAM，断电/复位后会回到 Flash 的 E023；本次没有重新下载或烧录；
- T9 同时是 Dock 板载 **WS2812 RGB LED 数据脚** 和工程的 `OPTICAL_SCL`：
  - SCL 接着时 LED 会被 I2C 波形误读而变色；
  - 拔掉 SCL 后 LED 停止变色但保持最后颜色；
  - 这是引脚复用冲突，不是 APK 点亮，也不表示 K230 状态；
- K230 不响应还需检查：K230 是否运行 `uart_gesture_sender.py`（不是屏幕预览）、`IO9/TX1 → M14`、GND 共地、板子 armed。

## 5. 未完成 / 下一步

1. 在真实 Android 手机上安装 v1.3.1-song，验证钢琴键、键位设置、脱机演奏、卓易通启动；
2. 需要 K230 时：核对 E025/E026 的 G 帧码流，先下 SRAM，不写 Flash；再运行 K230 UART 发送程序；
3. 若要求 T9 的 RGB 灯不影响光键：把 `OPTICAL_SCL` 从 T9 改到空闲 PMOD 脚并重新接线，或不用光键时关闭 `ENABLE_OPTICAL`；
4. E027 若要持久化，另行按仓库流程核对设备/哈希/地址后写 Flash；本日志不构成烧录授权。

## 6. 安全边界

- 本日没有执行 Gowin Programmer、openFPGALoader、JTAG 下载、Flash 擦写或 SRAM 下载；
- 历史核心板异常发热根因未测清；出现异常发热立即断开全部电源；
- PCM5102A 使用 USB 独立供电，PCM 的 3.3V 排针保持悬空；
- 不把 Wi-Fi 远控暴露到公网。
