myfines/d-dfdf/logs/20261022-k230-debug-timing.html

# Timing Messages

Report Title | Timing Analysis Report
Design File | E:\gaoyun\projects\k230_usb_host_probe\k230_usb_host_probe\impl\gwsynthesis\k230_usb_host_probe.vg
Physical Constraints File | E:\gaoyun\d-dfdf\usb_host\host_probe.cst
Timing Constraint File | E:\gaoyun\d-dfdf\usb_host\host_probe.sdc
Tool Version | V1.9.11.03 Education
Part Number | GW2A-LV18PG256C8/I7
Device | GW2A-18
Device Version | C
Created Time | Thu Oct 22 00:22:57 2026
Legal Announcement | Copyright (C)2014-2025 Gowin Semiconductor Corporation. All rights reserved.

# Timing Summaries

## STA Tool Run Summary:

Setup Delay Model | Slow 0.95V 85C C8/I7
Hold Delay Model | Fast 1.05V 0C C8/I7
Numbers of Paths Analyzed | 5114
Numbers of Endpoints Analyzed | 2547
Numbers of Falling Endpoints | 0
Numbers of Setup Violated Endpoints | 0
Numbers of Hold Violated Endpoints | 0

## Clock Summary:

NO. | Clock Name | Type | Period | Frequency(MHz) | Rise | Fall | Source | Master | Objects
1 | ulpi_clk | Base | 16.667 | 59.999 | 0.000 | 8.333 | | | ulpi_clk
2 | clk | Base | 37.037 | 27.000 | 0.000 | 18.518 | | | clk
3 | usb_core_phase | Generated | 16.667 | 59.999 | 14.584 | 6.250 | ulpi_clk | ulpi_clk | usb_pll/CLKOUTP
4 | usb_pll/CLKOUT.default_gen_clk | Generated | 16.667 | 59.999 | 0.000 | 8.333 | ulpi_clk_ibuf/I | ulpi_clk | usb_pll/CLKOUT
5 | usb_pll/CLKOUTD.default_gen_clk | Generated | 33.334 | 29.999 | 0.000 | 16.667 | ulpi_clk_ibuf/I | ulpi_clk | usb_pll/CLKOUTD
6 | usb_pll/CLKOUTD3.default_gen_clk | Generated | 50.001 | 20.000 | 0.000 | 25.000 | ulpi_clk_ibuf/I | ulpi_clk | usb_pll/CLKOUTD3

## Max Frequency Summary:

NO. | Clock Name | Constraint | Actual Fmax | Logic Level | Entity
1 | ulpi_clk | 59.999(MHz) | 60.007(MHz) | 4 | TOP
2 | clk | 27.000(MHz) | 361.665(MHz) | 2 | TOP
3 | usb_core_phase | 59.999(MHz) | 80.112(MHz) | 9 | TOP

#### No timing paths to get frequency of usb_pll/CLKOUT.default_gen_clk!

#### No timing paths to get frequency of usb_pll/CLKOUTD.default_gen_clk!

#### No timing paths to get frequency of usb_pll/CLKOUTD3.default_gen_clk!

## Total Negative Slack Summary:

Clock Name | Analysis Type | Endpoints TNS | Number of Endpoints
ulpi_clk | Setup | 0.000 | 0
ulpi_clk | Hold | 0.000 | 0
clk | Setup | 0.000 | 0
clk | Hold | 0.000 | 0
usb_core_phase | Setup | 0.000 | 0
usb_core_phase | Hold | 0.000 | 0
usb_pll/CLKOUT.default_gen_clk | Setup | 0.000 | 0
usb_pll/CLKOUT.default_gen_clk | Hold | 0.000 | 0
usb_pll/CLKOUTD.default_gen_clk | Setup | 0.000 | 0
usb_pll/CLKOUTD.default_gen_clk | Hold | 0.000 | 0
usb_pll/CLKOUTD3.default_gen_clk | Setup | 0.000 | 0
usb_pll/CLKOUTD3.default_gen_clk | Hold | 0.000 | 0

# Timing Details

## Path Slacks Table:

### Setup Paths Table

#### Report Command:report_timing -setup -max_paths 25 -max_common_paths 1

Path Number | Path Slack | From Node | To Node | From Clock | To Clock | Relation | Clock Skew | Data Delay
1 | 0.003 | ulpi_dir_ibuf/I | ulpi_data_6_iobuf/IO | ulpi_clk:[R] | ulpi_clk:[R] | 16.667 | 0.000 | 11.164
2 | 0.145 | ulpi_dir_ibuf/I | ulpi_data_7_iobuf/IO | ulpi_clk:[R] | ulpi_clk:[R] | 16.667 | 0.000 | 11.022
3 | 0.406 | ulpi_dir_ibuf/I | ulpi_data_4_iobuf/IO | ulpi_clk:[R] | ulpi_clk:[R] | 16.667 | 0.000 | 10.761
4 | 0.548 | ulpi_dir_ibuf/I | ulpi_data_5_iobuf/IO | ulpi_clk:[R] | ulpi_clk:[R] | 16.667 | 0.000 | 10.619
5 | 0.708 | ulpi_dir_ibuf/I | ulpi_data_1_iobuf/IO | ulpi_clk:[R] | ulpi_clk:[R] | 16.667 | 0.000 | 10.459
6 | 0.851 | ulpi_dir_ibuf/I | ulpi_data_0_iobuf/IO | ulpi_clk:[R] | ulpi_clk:[R] | 16.667 | 0.000 | 10.316
7 | 1.222 | ulpi_dir_ibuf/I | ulpi_data_3_iobuf/IO | ulpi_clk:[R] | ulpi_clk:[R] | 16.667 | 0.000 | 9.945
8 | 1.222 | ulpi_dir_ibuf/I | ulpi_data_2_iobuf/IO | ulpi_clk:[R] | ulpi_clk:[R] | 16.667 | 0.000 | 9.945
9 | 2.829 | host/host_0/enum/sie/translator/queue/r_rdy_s1/Q | ulpi_stp_obuf/O | usb_core_phase:[R] | ulpi_clk:[R] | 18.750 | 2.271 | 8.115
10 | 4.185 | host/host_0/packet_packet_0_0_s/DO[2] | parser/pinch_0_s1/CE | usb_core_phase:[R] | usb_core_phase:[R] | 16.667 | 0.000 | 12.447
11 | 4.185 | host/host_0/packet_packet_0_0_s/DO[2] | parser/pinch_8_s1/CE | usb_core_phase:[R] | usb_core_phase:[R] | 16.667 | 0.000 | 12.447
12 | 4.185 | host/host_0/packet_packet_0_0_s/DO[2] | parser/pinch_9_s1/CE | usb_core_phase:[R] | usb_core_phase:[R] | 16.667 | 0.000 | 12.447
13 | 4.185 | host/host_0/packet_packet_0_0_s/DO[2] | parser/have_seq_s1/CE | usb_core_phase:[R] | usb_core_phase:[R] | 16.667 | 0.000 | 12.447
14 | 4.338 | host/host_0/packet_packet_0_0_s/DO[2] | parser/lease_24_s1/CE | usb_core_phase:[R] | usb_core_phase:[R] | 16.667 | 0.000 | 12.294
15 | 4.338 | host/host_0/packet_packet_0_0_s/DO[2] | parser/lease_25_s1/CE | usb_core_phase:[R] | usb_core_phase:[R] | 16.667 | 0.000 | 12.294
16 | 4.338 | host/host_0/packet_packet_0_0_s/DO[2] | parser/lease_28_s1/CE | usb_core_phase:[R] | usb_core_phase:[R] | 16.667 | 0.000 | 12.294
17 | 4.345 | host/host_0/packet_packet_0_0_s/DO[2] | parser/lease_10_s1/CE | usb_core_phase:[R] | usb_core_phase:[R] | 16.667 | 0.000 | 12.287
18 | 4.345 | host/host_0/packet_packet_0_0_s/DO[2] | parser/lease_11_s1/CE | usb_core_phase:[R] | usb_core_phase:[R] | 16.667 | 0.000 | 12.287
19 | 4.345 | host/host_0/packet_packet_0_0_s/DO[2] | parser/lease_12_s1/CE | usb_core_phase:[R] | usb_core_phase:[R] | 16.667 | 0.000 | 12.287
20 | 4.362 | host/host_0/packet_packet_0_0_s/DO[2] | parser/pinch_3_s1/CE | usb_core_phase:[R] | usb_core_phase:[R] | 16.667 | 0.000 | 12.270
21 | 4.362 | host/host_0/packet_packet_0_0_s/DO[2] | parser/pinch_4_s1/CE | usb_core_phase:[R] | usb_core_phase:[R] | 16.667 | 0.000 | 12.270
22 | 4.362 | host/host_0/packet_packet_0_0_s/DO[2] | parser/pinch_5_s1/CE | usb_core_phase:[R] | usb_core_phase:[R] | 16.667 | 0.000 | 12.270
23 | 4.368 | host/host_0/packet_packet_0_0_s/DO[2] | parser/pinch_6_s1/CE | usb_core_phase:[R] | usb_core_phase:[R] | 16.667 | 0.000 | 12.264
24 | 4.506 | host/host_0/packet_packet_0_0_s/DO[2] | parser/lease_2_s1/D | usb_core_phase:[R] | usb_core_phase:[R] | 16.667 | 0.000 | 12.126
25 | 4.515 | host/host_0/packet_packet_0_0_s/DO[2] | parser/lease_15_s1/D | usb_core_phase:[R] | usb_core_phase:[R] | 16.667 | 0.000 | 12.117

### Hold Paths Table

#### Report Command:report_timing -hold -max_paths 25 -max_common_paths 1

Path Number | Path Slack | From Node | To Node | From Clock | To Clock | Relation | Clock Skew | Data Delay
1 | 0.319 | host/host_0/enum/sie/translator/queue/w_port__addr_1_s5/Q | host/host_0/enum/sie/translator/queue/storage_storage_0_1_s/WAD[1] | usb_core_phase:[R] | usb_core_phase:[R] | 0.000 | 0.000 | 0.329
2 | 0.319 | host/host_0/enum/sie/translator/queue/w_port__addr_0_s4/Q | host/host_0/enum/sie/translator/queue/storage_storage_0_2_s/WAD[0] | usb_core_phase:[R] | usb_core_phase:[R] | 0.000 | 0.000 | 0.329
3 | 0.328 | host/host_0/enum/sie/translator/queue/w_port__addr_1_s5/Q | host/host_0/enum/sie/translator/queue/storage_storage_0_2_s/WAD[1] | usb_core_phase:[R] | usb_core_phase:[R] | 0.000 | 0.000 | 0.338
4 | 0.424 | power_count_2_s0/Q | power_count_2_s0/D | clk:[R] | clk:[R] | 0.000 | 0.000 | 0.435
5 | 0.424 | power_count_6_s0/Q | power_count_6_s0/D | clk:[R] | clk:[R] | 0.000 | 0.000 | 0.435
6 | 0.424 | power_count_8_s0/Q | power_count_8_s0/D | clk:[R] | clk:[R] | 0.000 | 0.000 | 0.435
7 | 0.424 | power_count_12_s0/Q | power_count_12_s0/D | clk:[R] | clk:[R] | 0.000 | 0.000 | 0.435
8 | 0.424 | power_count_14_s0/Q | power_count_14_s0/D | clk:[R] | clk:[R] | 0.000 | 0.000 | 0.435
9 | 0.424 | power_count_18_s0/Q | power_count_18_s0/D | clk:[R] | clk:[R] | 0.000 | 0.000 | 0.435
10 | 0.424 | heartbeat_24_s0/Q | heartbeat_24_s0/D | usb_core_phase:[R] | usb_core_phase:[R] | 0.000 | 0.000 | 0.435
11 | 0.425 | power_count_0_s2/Q | power_count_0_s2/D | clk:[R] | clk:[R] | 0.000 | 0.000 | 0.436
12 | 0.425 | diagnostic/tx_count_0_s3/Q | diagnostic/tx_count_0_s3/D | usb_core_phase:[R] | usb_core_phase:[R] | 0.000 | 0.000 | 0.436
13 | 0.425 | diagnostic/tx_left_0_s2/Q | diagnostic/tx_left_0_s2/D | usb_core_phase:[R] | usb_core_phase:[R] | 0.000 | 0.000 | 0.436
14 | 0.425 | diagnostic/tx_count_3_s1/Q | diagnostic/tx_count_3_s1/D | usb_core_phase:[R] | usb_core_phase:[R] | 0.000 | 0.000 | 0.436
15 | 0.425 | diagnostic/tx_count_7_s1/Q | diagnostic/tx_count_7_s1/D | usb_core_phase:[R] | usb_core_phase:[R] | 0.000 | 0.000 | 0.436
16 | 0.425 | diagnostic/tx_count_9_s1/Q | diagnostic/tx_count_9_s1/D | usb_core_phase:[R] | usb_core_phase:[R] | 0.000 | 0.000 | 0.436
17 | 0.425 | diagnostic/tx_count_11_s1/Q | diagnostic/tx_count_11_s1/D | usb_core_phase:[R] | usb_core_phase:[R] | 0.000 | 0.000 | 0.436
18 | 0.425 | diagnostic/tx_count_14_s1/Q | diagnostic/tx_count_14_s1/D | usb_core_phase:[R] | usb_core_phase:[R] | 0.000 | 0.000 | 0.436
19 | 0.425 | diagnostic/tx_left_2_s1/Q | diagnostic/tx_left_2_s1/D | usb_core_phase:[R] | usb_core_phase:[R] | 0.000 | 0.000 | 0.436
20 | 0.425 | diagnostic/tx_left_3_s1/Q | diagnostic/tx_left_3_s1/D | usb_core_phase:[R] | usb_core_phase:[R] | 0.000 | 0.000 | 0.436
21 | 0.425 | parser/lease_31_s6/Q | parser/lease_31_s6/D | usb_core_phase:[R] | usb_core_phase:[R] | 0.000 | 0.000 | 0.436
22 | 0.425 | parser/gap_0_s1/Q | parser/gap_0_s1/D | usb_core_phase:[R] | usb_core_phase:[R] | 0.000 | 0.000 | 0.436
23 | 0.425 | parser/lease_0_s1/Q | parser/lease_0_s1/D | usb_core_phase:[R] | usb_core_phase:[R] | 0.000 | 0.000 | 0.436
24 | 0.425 | parser/lease_7_s1/Q | parser/lease_7_s1/D | usb_core_phase:[R] | usb_core_phase:[R] | 0.000 | 0.000 | 0.436
25 | 0.425 | parser/lease_9_s1/Q | parser/lease_9_s1/D | usb_core_phase:[R] | usb_core_phase:[R] | 0.000 | 0.000 | 0.436

### Recovery Paths Table

#### Report Command:report_timing -recovery -max_paths 25 -max_common_paths 1

#### Nothing to report!

### Removal Paths Table

#### Report Command:report_timing -removal -max_paths 25 -max_common_paths 1

#### Nothing to report!

## Minimum Pulse Width Table:

Number | Slack | Actual Width | Required Width | Type | Clock | Objects

#### Report Command:report_min_pulse_width -nworst 10 -detail

1 | 6.570 | 7.570 | 1.000 | Low Pulse Width | usb_core_phase | usb_reset_0_s0
2 | 6.570 | 7.570 | 1.000 | Low Pulse Width | usb_core_phase | heartbeat_24_s0
3 | 6.570 | 7.570 | 1.000 | Low Pulse Width | usb_core_phase | heartbeat_20_s0
4 | 6.570 | 7.570 | 1.000 | Low Pulse Width | usb_core_phase | heartbeat_18_s0
5 | 6.570 | 7.570 | 1.000 | Low Pulse Width | usb_core_phase | heartbeat_17_s0
6 | 6.570 | 7.570 | 1.000 | Low Pulse Width | usb_core_phase | check_2_s0
7 | 6.570 | 7.570 | 1.000 | Low Pulse Width | usb_core_phase | host/host_0/watchdog_26_s0
8 | 6.570 | 7.570 | 1.000 | Low Pulse Width | usb_core_phase | host/host_0/enum/parser/desc_type_4_s1
9 | 6.570 | 7.570 | 1.000 | Low Pulse Width | usb_core_phase | host/host_0/enum/sie/sof_controller/microframe_number_2_s1
10 | 6.570 | 7.570 | 1.000 | Low Pulse Width | usb_core_phase | host/host_0/enum/sie/sof_controller/sof_timer_15_s0

## Timing Report By Analysis Type:

### Setup Analysis Report

#### Report Command:report_timing -setup -max_paths 25 -max_common_paths 1

### Path1

Path Summary:

Slack | 0.003
Data Arrival Time | 11.164
Data Required Time | 11.167
From | ulpi_dir_ibuf
To | ulpi_data_6_iobuf
Launch Clk | ulpi_clk:[R]
Latch Clk | ulpi_clk:[R]

Data Arrival Path:

AT | DELAY | TYPE | RF | FANOUT | LOC | NODE
0.000 | 0.000 | | | | | active clock edge time
0.000 | 0.000 | | | | | ulpi_clk
4.000 | 4.000 | tIn | RF | 1 | IOT36[B] | ulpi_dir_ibuf/I
6.314 | 2.314 | tINS | FF | 22 | IOT36[B] | ulpi_dir_ibuf/O
8.162 | 1.848 | tNET | FF | 1 | R16C17[3][A] | ulpi_data_0_s3/I1
8.624 | 0.462 | tINS | FR | 8 | R16C17[3][A] | ulpi_data_0_s3/F
10.626 | 2.002 | tNET | RR | 1 | IOR11[B] | ulpi_data_6_iobuf/OEN
11.164 | 0.539 | tINS | RR | 1 | IOR11[B] | ulpi_data_6_iobuf/IO

Data Required Path:

AT | DELAY | TYPE | RF | FANOUT | LOC | NODE
16.667 | 16.667 | | | | | active clock edge time
16.667 | 0.000 | | | | | ulpi_clk
11.167 | -5.500 | tOut | | | IOR11[B] | ulpi_data_6_iobuf

Path Statistics:

Clock Skew | 0.000
Setup Relationship | 16.667
Logic Level | 4
Arrival Clock Path Delay | cell: 0.000, 0.000%; route: 0.000, 0.000%
Arrival Data Path Delay | cell: 3.315, 29.688%; route: 3.850, 34.484%; tC2Q: 4.000, 35.828%
Required Clock Path Delay | cell: 0.000, 0.000%; route: 0.000, 0.000%

### Path2

Path Summary:

Slack | 0.145
Data Arrival Time | 11.022
Data Required Time | 11.167
From | ulpi_dir_ibuf
To | ulpi_data_7_iobuf
Launch Clk | ulpi_clk:[R]
Latch Clk | ulpi_clk:[R]

Data Arrival Path:

AT | DELAY | TYPE | RF | FANOUT | LOC | NODE
0.000 | 0.000 | | | | | active clock edge time
0.000 | 0.000 | | | | | ulpi_clk
4.000 | 4.000 | tIn | RF | 1 | IOT36[B] | ulpi_dir_ibuf/I
6.314 | 2.314 | tINS | FF | 22 | IOT36[B] | ulpi_dir_ibuf/O
8.162 | 1.848 | tNET | FF | 1 | R16C17[3][A] | ulpi_data_0_s3/I1
8.624 | 0.462 | tINS | FR | 8 | R16C17[3][A] | ulpi_data_0_s3/F
10.483 | 1.859 | tNET | RR | 1 | IOR11[A] | ulpi_data_7_iobuf/OEN
11.022 | 0.539 | tINS | RR | 1 | IOR11[A] | ulpi_data_7_iobuf/IO

Data Required Path:

AT | DELAY | TYPE | RF | FANOUT | LOC | NODE
16.667 | 16.667 | | | | | active clock edge time
16.667 | 0.000 | | | | | ulpi_clk
11.167 | -5.500 | tOut | | | IOR11[A] | ulpi_data_7_iobuf

Path Statistics:

Clock Skew | 0.000
Setup Relationship | 16.667
Logic Level | 4
Arrival Clock Path Delay | cell: 0.000, 0.000%; route: 0.000, 0.000%
Arrival Data Path Delay | cell: 3.315, 30.073%; route: 3.707, 33.635%; tC2Q: 4.000, 36.292%
Required Clock Path Delay | cell: 0.000, 0.000%; route: 0.000, 0.000%

### Path3

Path Summary:

Slack | 0.406
Data Arrival Time | 10.761
Data Required Time | 11.167
From | ulpi_dir_ibuf
To | ulpi_data_4_iobuf
Launch Clk | ulpi_clk:[R]
Latch Clk | ulpi_clk:[R]

Data Arrival Path:

AT | DELAY | TYPE | RF | FANOUT | LOC | NODE
0.000 | 0.000 | | | | | active clock edge time
0.000 | 0.000 | | | | | ulpi_clk
4.000 | 4.000 | tIn | RF | 1 | IOT36[B] | ulpi_dir_ibuf/I
6.314 | 2.314 | tINS | FF | 22 | IOT36[B] | ulpi_dir_ibuf/O
8.162 | 1.848 | tNET | FF | 1 | R16C17[3][A] | ulpi_data_0_s3/I1
8.624 | 0.462 | tINS | FR | 8 | R16C17[3][A] | ulpi_data_0_s3/F
10.223 | 1.599 | tNET | RR | 1 | IOR20[B] | ulpi_data_4_iobuf/OEN
10.761 | 0.539 | tINS | RR | 1 | IOR20[B] | ulpi_data_4_iobuf/IO

Data Required Path:

AT | DELAY | TYPE | RF | FANOUT | LOC | NODE
16.667 | 16.667 | | | | | active clock edge time
16.667 | 0.000 | | | | | ulpi_clk
11.167 | -5.500 | tOut | | | IOR20[B] | ulpi_data_4_iobuf

Path Statistics:

Clock Skew | 0.000
Setup Relationship | 16.667
Logic Level | 4
Arrival Clock Path Delay | cell: 0.000, 0.000%; route: 0.000, 0.000%
Arrival Data Path Delay | cell: 3.315, 30.800%; route: 3.447, 32.030%; tC2Q: 4.000, 37.170%
Required Clock Path Delay | cell: 0.000, 0.000%; route: 0.000, 0.000%

### Path4

Path Summary:

Slack | 0.548
Data Arrival Time | 10.619
Data Required Time | 11.167
From | ulpi_dir_ibuf
To | ulpi_data_5_iobuf
Launch Clk | ulpi_clk:[R]
Latch Clk | ulpi_clk:[R]

Data Arrival Path:

AT | DELAY | TYPE | RF | FANOUT | LOC | NODE
0.000 | 0.000 | | | | | active clock edge time
0.000 | 0.000 | | | | | ulpi_clk
4.000 | 4.000 | tIn | RF | 1 | IOT36[B] | ulpi_dir_ibuf/I
6.314 | 2.314 | tINS | FF | 22 | IOT36[B] | ulpi_dir_ibuf/O
8.162 | 1.848 | tNET | FF | 1 | R16C17[3][A] | ulpi_data_0_s3/I1
8.624 | 0.462 | tINS | FR | 8 | R16C17[3][A] | ulpi_data_0_s3/F
10.080 | 1.456 | tNET | RR | 1 | IOR20[A] | ulpi_data_5_iobuf/OEN
10.619 | 0.539 | tINS | RR | 1 | IOR20[A] | ulpi_data_5_iobuf/IO

Data Required Path:

AT | DELAY | TYPE | RF | FANOUT | LOC | NODE
16.667 | 16.667 | | | | | active clock edge time
16.667 | 0.000 | | | | | ulpi_clk
11.167 | -5.500 | tOut | | | IOR20[A] | ulpi_data_5_iobuf

Path Statistics:

Clock Skew | 0.000
Setup Relationship | 16.667
Logic Level | 4
Arrival Clock Path Delay | cell: 0.000, 0.000%; route: 0.000, 0.000%
Arrival Data Path Delay | cell: 3.315, 31.214%; route: 3.304, 31.116%; tC2Q: 4.000, 37.670%
Required Clock Path Delay | cell: 0.000, 0.000%; route: 0.000, 0.000%

### Path5

Path Summary:

Slack | 0.708
Data Arrival Time | 10.459
Data Required Time | 11.167
From | ulpi_dir_ibuf
To | ulpi_data_1_iobuf
Launch Clk | ulpi_clk:[R]
Latch Clk | ulpi_clk:[R]

Data Arrival Path:

AT | DELAY | TYPE | RF | FANOUT | LOC | NODE
0.000 | 0.000 | | | | | active clock edge time
0.000 | 0.000 | | | | | ulpi_clk
4.000 | 4.000 | tIn | RF | 1 | IOT36[B] | ulpi_dir_ibuf/I
6.314 | 2.314 | tINS | FF | 22 | IOT36[B] | ulpi_dir_ibuf/O
8.162 | 1.848 | tNET | FF | 1 | R16C17[3][A] | ulpi_data_0_s3/I1
8.624 | 0.462 | tINS | FR | 8 | R16C17[3][A] | ulpi_data_0_s3/F
9.921 | 1.297 | tNET | RR | 1 | IOT14[B] | ulpi_data_1_iobuf/OEN
10.459 | 0.539 | tINS | RR | 1 | IOT14[B] | ulpi_data_1_iobuf/IO

Data Required Path:

AT | DELAY | TYPE | RF | FANOUT | LOC | NODE
16.667 | 16.667 | | | | | active clock edge time
16.667 | 0.000 | | | | | ulpi_clk
11.167 | -5.500 | tOut | | | IOT14[B] | ulpi_data_1_iobuf

Path Statistics:

Clock Skew | 0.000
Setup Relationship | 16.667
Logic Level | 4
Arrival Clock Path Delay | cell: 0.000, 0.000%; route: 0.000, 0.000%
Arrival Data Path Delay | cell: 3.315, 31.690%; route: 3.145, 30.067%; tC2Q: 4.000, 38.244%
Required Clock Path Delay | cell: 0.000, 0.000%; route: 0.000, 0.000%

### Path6

Path Summary:

Slack | 0.851
Data Arrival Time | 10.316
Data Required Time | 11.167
From | ulpi_dir_ibuf
To | ulpi_data_0_iobuf
Launch Clk | ulpi_clk:[R]
Latch Clk | ulpi_clk:[R]

Data Arrival Path:

AT | DELAY | TYPE | RF | FANOUT | LOC | NODE
0.000 | 0.000 | | | | | active clock edge time
0.000 | 0.000 | | | | | ulpi_clk
4.000 | 4.000 | tIn | RF | 1 | IOT36[B] | ulpi_dir_ibuf/I
6.314 | 2.314 | tINS | FF | 22 | IOT36[B] | ulpi_dir_ibuf/O
8.162 | 1.848 | tNET | FF | 1 | R16C17[3][A] | ulpi_data_0_s3/I1
8.624 | 0.462 | tINS | FR | 8 | R16C17[3][A] | ulpi_data_0_s3/F
9.778 | 1.154 | tNET | RR | 1 | IOT14[A] | ulpi_data_0_iobuf/OEN
10.316 | 0.539 | tINS | RR | 1 | IOT14[A] | ulpi_data_0_iobuf/IO

Data Required Path:

AT | DELAY | TYPE | RF | FANOUT | LOC | NODE
16.667 | 16.667 | | | | | active clock edge time
16.667 | 0.000 | | | | | ulpi_clk
11.167 | -5.500 | tOut | | | IOT14[A] | ulpi_data_0_iobuf

Path Statistics:

Clock Skew | 0.000
Setup Relationship | 16.667
Logic Level | 4
Arrival Clock Path Delay | cell: 0.000, 0.000%; route: 0.000, 0.000%
Arrival Data Path Delay | cell: 3.315, 32.129%; route: 3.002, 29.098%; tC2Q: 4.000, 38.773%
Required Clock Path Delay | cell: 0.000, 0.000%; route: 0.000, 0.000%

### Path7

Path Summary:

Slack | 1.222
Data Arrival Time | 9.945
Data Required Time | 11.167
From | ulpi_dir_ibuf
To | ulpi_data_3_iobuf
Launch Clk | ulpi_clk:[R]
Latch Clk | ulpi_clk:[R]

Data Arrival Path:

AT | DELAY | TYPE | RF | FANOUT | LOC | NODE
0.000 | 0.000 | | | | | active clock edge time
0.000 | 0.000 | | | | | ulpi_clk
4.000 | 4.000 | tIn | RF | 1 | IOT36[B] | ulpi_dir_ibuf/I
6.314 | 2.314 | tINS | FF | 22 | IOT36[B] | ulpi_dir_ibuf/O
8.162 | 1.848 | tNET | FF | 1 | R16C17[3][A] | ulpi_data_0_s3/I1
8.624 | 0.462 | tINS | FR | 8 | R16C17[3][A] | ulpi_data_0_s3/F
9.407 | 0.783 | tNET | RR | 1 | IOT18[A] | ulpi_data_3_iobuf/OEN
9.945 | 0.539 | tINS | RR | 1 | IOT18[A] | ulpi_data_3_iobuf/IO

Data Required Path:

AT | DELAY | TYPE | RF | FANOUT | LOC | NODE
16.667 | 16.667 | | | | | active clock edge time
16.667 | 0.000 | | | | | ulpi_clk
11.167 | -5.500 | tOut | | | IOT18[A] | ulpi_data_3_iobuf

Path Statistics:

Clock Skew | 0.000
Setup Relationship | 16.667
Logic Level | 4
Arrival Clock Path Delay | cell: 0.000, 0.000%; route: 0.000, 0.000%
Arrival Data Path Delay | cell: 3.315, 33.327%; route: 2.631, 26.453%; tC2Q: 4.000, 40.220%
Required Clock Path Delay | cell: 0.000, 0.000%; route: 0.000, 0.000%

### Path8

Path Summary:

Slack | 1.222
Data Arrival Time | 9.945
Data Required Time | 11.167
From | ulpi_dir_ibuf
To | ulpi_data_2_iobuf
Launch Clk | ulpi_clk:[R]
Latch Clk | ulpi_clk:[R]

Data Arrival Path:

AT | DELAY | TYPE | RF | FANOUT | LOC | NODE
0.000 | 0.000 | | | | | active clock edge time
0.000 | 0.000 | | | | | ulpi_clk
4.000 | 4.000 | tIn | RF | 1 | IOT36[B] | ulpi_dir_ibuf/I
6.314 | 2.314 | tINS | FF | 22 | IOT36[B] | ulpi_dir_ibuf/O
8.162 | 1.848 | tNET | FF | 1 | R16C17[3][A] | ulpi_data_0_s3/I1
8.624 | 0.462 | tINS | FR | 8 | R16C17[3][A] | ulpi_data_0_s3/F
9.407 | 0.783 | tNET | RR | 1 | IOT18[B] | ulpi_data_2_iobuf/OEN
9.945 | 0.539 | tINS | RR | 1 | IOT18[B] | ulpi_data_2_iobuf/IO

Data Required Path:

AT | DELAY | TYPE | RF | FANOUT | LOC | NODE
16.667 | 16.667 | | | | | active clock edge time
16.667 | 0.000 | | | | | ulpi_clk
11.167 | -5.500 | tOut | | | IOT18[B] | ulpi_data_2_iobuf

Path Statistics:

Clock Skew | 0.000
Setup Relationship | 16.667
Logic Level | 4
Arrival Clock Path Delay | cell: 0.000, 0.000%; route: 0.000, 0.000%
Arrival Data Path Delay | cell: 3.315, 33.327%; route: 2.631, 26.453%; tC2Q: 4.000, 40.220%
Required Clock Path Delay | cell: 0.000, 0.000%; route: 0.000, 0.000%

### Path9

Path Summary:

Slack | 2.829
Data Arrival Time | 24.970
Data Required Time | 27.799
From | host/host_0/enum/sie/translator/queue/r_rdy_s1
To | ulpi_stp_obuf
Launch Clk | usb_core_phase:[R]
Latch Clk | ulpi_clk:[R]

Data Arrival Path:

AT | DELAY | TYPE | RF | FANOUT | LOC | NODE
14.584 | 14.584 | | | | | active clock edge time
14.584 | 0.000 | | | | | usb_core_phase
14.584 | 0.000 | tCL | RR | 886 | PLL_R[0] | usb_pll/CLKOUTP
16.855 | 2.271 | tNET | RR | 1 | R33C23[0][A] | host/host_0/enum/sie/translator/queue/r_rdy_s1/CLK
17.087 | 0.232 | tC2Q | RF | 6 | R33C23[0][A] | host/host_0/enum/sie/translator/queue/r_rdy_s1/Q
17.753 | 0.666 | tNET | FF | 1 | R32C20[2][B] | host/host_0/enum/sie/translator/phy/ulpi_stp_d_s0/I0
18.308 | 0.555 | tINS | FF | 6 | R32C20[2][B] | host/host_0/enum/sie/translator/phy/ulpi_stp_d_s0/F
18.730 | 0.422 | tNET | FF | 1 | R30C20[3][A] | host/host_0/enum/sie/translator/phy/ulpi_stp_d_s/I0
19.247 | 0.517 | tINS | FF | 1 | R30C20[3][A] | host/host_0/enum/sie/translator/phy/ulpi_stp_d_s/F
21.286 | 2.038 | tNET | FF | 1 | IOT38[A] | ulpi_stp_obuf/I
24.970 | 3.684 | tINS | FF | 1 | IOT38[A] | ulpi_stp_obuf/O

Data Required Path:

AT | DELAY | TYPE | RF | FANOUT | LOC | NODE
33.334 | 33.334 | | | | | active clock edge time
33.334 | 0.000 | | | | | ulpi_clk
33.299 | -0.035 | tUnc | | | | ulpi_stp_obuf
27.799 | -5.500 | tOut | | | IOT38[A] | ulpi_stp_obuf

Path Statistics:

Clock Skew | -2.271
Setup Relationship | 18.750
Logic Level | 4
Arrival Clock Path Delay | cell: 0.000, 0.000%; route: 2.271, 100.000%
Arrival Data Path Delay | cell: 4.756, 58.610%; route: 3.127, 38.531%; tC2Q: 0.232, 2.859%
Required Clock Path Delay | cell: 0.000, 0.000%; route: 0.000, 0.000%

### Path10

Path Summary:

Slack | 4.185
Data Arrival Time | 29.302
Data Required Time | 33.487
From | host/host_0/packet_packet_0_0_s
To | parser/pinch_0_s1
Launch Clk | usb_core_phase:[R]
Latch Clk | usb_core_phase:[R]

Data Arrival Path:

AT | DELAY | TYPE | RF | FANOUT | LOC | NODE
14.584 | 14.584 | | | | | active clock edge time
14.584 | 0.000 | | | | | usb_core_phase
14.584 | 0.000 | tCL | RR | 886 | PLL_R[0] | usb_pll/CLKOUTP
16.855 | 2.271 | tNET | RR | 8 | BSRAM_R28[8] | host/host_0/packet_packet_0_0_s/CLKB
19.115 | 2.260 | tC2Q | RF | 13 | BSRAM_R28[8] | host/host_0/packet_packet_0_0_s/DO[2]
21.305 | 2.190 | tNET | FF | 2 | R34C35[1][B] | parser/n487_s0/I0
21.854 | 0.549 | tINS | FR | 1 | R34C35[1][B] | parser/n487_s0/COUT
21.854 | 0.000 | tNET | RR | 2 | R34C35[2][A] | parser/n488_s0/CIN
21.889 | 0.035 | tINS | RF | 1 | R34C35[2][A] | parser/n488_s0/COUT
21.889 | 0.000 | tNET | FF | 2 | R34C35[2][B] | parser/n489_s0/CIN
21.924 | 0.035 | tINS | FF | 1 | R34C35[2][B] | parser/n489_s0/COUT
21.924 | 0.000 | tNET | FF | 2 | R34C36[0][A] | parser/n490_s0/CIN
21.959 | 0.035 | tINS | FF | 1 | R34C36[0][A] | parser/n490_s0/COUT
21.959 | 0.000 | tNET | FF | 2 | R34C36[0][B] | parser/n491_s0/CIN
21.994 | 0.035 | tINS | FF | 1 | R34C36[0][B] | parser/n491_s0/COUT
21.994 | 0.000 | tNET | FF | 2 | R34C36[1][A] | parser/n492_s0/CIN
22.030 | 0.035 | tINS | FF | 1 | R34C36[1][A] | parser/n492_s0/COUT
22.030 | 0.000 | tNET | FF | 2 | R34C36[1][B] | parser/n493_s0/CIN
22.065 | 0.035 | tINS | FF | 1 | R34C36[1][B] | parser/n493_s0/COUT
22.065 | 0.000 | tNET | FF | 2 | R34C36[2][A] | parser/n494_s0/CIN
22.100 | 0.035 | tINS | FF | 1 | R34C36[2][A] | parser/n494_s0/COUT
22.100 | 0.000 | tNET | FF | 2 | R34C36[2][B] | parser/n495_s0/CIN
22.135 | 0.035 | tINS | FF | 1 | R34C36[2][B] | parser/n495_s0/COUT
22.135 | 0.000 | tNET | FF | 2 | R34C37[0][A] | parser/n496_s0/CIN
22.170 | 0.035 | tINS | FF | 1 | R34C37[0][A] | parser/n496_s0/COUT
22.170 | 0.000 | tNET | FF | 2 | R34C37[0][B] | parser/n497_s0/CIN
22.206 | 0.035 | tINS | FF | 1 | R34C37[0][B] | parser/n497_s0/COUT
22.206 | 0.000 | tNET | FF | 2 | R34C37[1][A] | parser/n498_s0/CIN
22.241 | 0.035 | tINS | FF | 1 | R34C37[1][A] | parser/n498_s0/COUT
22.241 | 0.000 | tNET | FF | 2 | R34C37[1][B] | parser/n499_s0/CIN
22.276 | 0.035 | tINS | FF | 1 | R34C37[1][B] | parser/n499_s0/COUT
22.276 | 0.000 | tNET | FF | 2 | R34C37[2][A] | parser/n500_s0/CIN
22.311 | 0.035 | tINS | FF | 1 | R34C37[2][A] | parser/n500_s0/COUT
23.465 | 1.154 | tNET | FF | 1 | R29C35[2][B] | parser/n626_s17/I3
24.035 | 0.570 | tINS | FR | 1 | R29C35[2][B] | parser/n626_s17/F
24.208 | 0.172 | tNET | RR | 1 | R29C36[3][B] | parser/n626_s9/I2
24.661 | 0.453 | tINS | RF | 1 | R29C36[3][B] | parser/n626_s9/F
25.058 | 0.397 | tNET | FF | 1 | R27C36[0][A] | parser/n626_s5/I2
25.429 | 0.371 | tINS | FF | 2 | R27C36[0][A] | parser/n626_s5/F
26.122 | 0.693 | tNET | FF | 1 | R30C37[0][B] | parser/n152_s3/I3
26.639 | 0.517 | tINS | FF | 72 | R30C37[0][B] | parser/n152_s3/F
28.273 | 1.634 | tNET | FF | 1 | R25C40[3][A] | parser/have_seq_s3/I0
28.600 | 0.327 | tINS | FR | 30 | R25C40[3][A] | parser/have_seq_s3/F
29.302 | 0.703 | tNET | RR | 1 | R24C36[0][B] | parser/pinch_0_s1/CE

Data Required Path:

AT | DELAY | TYPE | RF | FANOUT | LOC | NODE
31.251 | 31.251 | | | | | active clock edge time
31.251 | 0.000 | | | | | usb_core_phase
31.251 | 0.000 | tCL | RR | 886 | PLL_R[0] | usb_pll/CLKOUTP
33.522 | 2.271 | tNET | RR | 1 | R24C36[0][B] | parser/pinch_0_s1/CLK
33.487 | -0.035 | tSu | | 1 | R24C36[0][B] | parser/pinch_0_s1

Path Statistics:

Clock Skew | 0.000
Setup Relationship | 16.667
Logic Level | 9
Arrival Clock Path Delay | cell: 0.000, 0.000%; route: 2.271, 100.000%
Arrival Data Path Delay | cell: 3.245, 26.066%; route: 6.943, 55.777%; tC2Q: 2.260, 18.156%
Required Clock Path Delay | cell: 0.000, 0.000%; route: 2.271, 100.000%

### Path11

Path Summary:

Slack | 4.185
Data Arrival Time | 29.302
Data Required Time | 33.487
From | host/host_0/packet_packet_0_0_s
To | parser/pinch_8_s1
Launch Clk | usb_core_phase:[R]
Latch Clk | usb_core_phase:[R]

Data Arrival Path:

AT | DELAY | TYPE | RF | FANOUT | LOC | NODE
14.584 | 14.584 | | | | | active clock edge time
14.584 | 0.000 | | | | | usb_core_phase
14.584 | 0.000 | tCL | RR | 886 | PLL_R[0] | usb_pll/CLKOUTP
16.855 | 2.271 | tNET | RR | 8 | BSRAM_R28[8] | host/host_0/packet_packet_0_0_s/CLKB
19.115 | 2.260 | tC2Q | RF | 13 | BSRAM_R28[8] | host/host_0/packet_packet_0_0_s/DO[2]
21.305 | 2.190 | tNET | FF | 2 | R34C35[1][B] | parser/n487_s0/I0
21.854 | 0.549 | tINS | FR | 1 | R34C35[1][B] | parser/n487_s0/COUT
21.854 | 0.000 | tNET | RR | 2 | R34C35[2][A] | parser/n488_s0/CIN
21.889 | 0.035 | tINS | RF | 1 | R34C35[2][A] | parser/n488_s0/COUT
21.889 | 0.000 | tNET | FF | 2 | R34C35[2][B] | parser/n489_s0/CIN
21.924 | 0.035 | tINS | FF | 1 | R34C35[2][B] | parser/n489_s0/COUT
21.924 | 0.000 | tNET | FF | 2 | R34C36[0][A] | parser/n490_s0/CIN
21.959 | 0.035 | tINS | FF | 1 | R34C36[0][A] | parser/n490_s0/COUT
21.959 | 0.000 | tNET | FF | 2 | R34C36[0][B] | parser/n491_s0/CIN
21.994 | 0.035 | tINS | FF | 1 | R34C36[0][B] | parser/n491_s0/COUT
21.994 | 0.000 | tNET | FF | 2 | R34C36[1][A] | parser/n492_s0/CIN
22.030 | 0.035 | tINS | FF | 1 | R34C36[1][A] | parser/n492_s0/COUT
22.030 | 0.000 | tNET | FF | 2 | R34C36[1][B] | parser/n493_s0/CIN
22.065 | 0.035 | tINS | FF | 1 | R34C36[1][B] | parser/n493_s0/COUT
22.065 | 0.000 | tNET | FF | 2 | R34C36[2][A] | parser/n494_s0/CIN
22.100 | 0.035 | tINS | FF | 1 | R34C36[2][A] | parser/n494_s0/COUT
22.100 | 0.000 | tNET | FF | 2 | R34C36[2][B] | parser/n495_s0/CIN
22.135 | 0.035 | tINS | FF | 1 | R34C36[2][B] | parser/n495_s0/COUT
22.135 | 0.000 | tNET | FF | 2 | R34C37[0][A] | parser/n496_s0/CIN
22.170 | 0.035 | tINS | FF | 1 | R34C37[0][A] | parser/n496_s0/COUT
22.170 | 0.000 | tNET | FF | 2 | R34C37[0][B] | parser/n497_s0/CIN
22.206 | 0.035 | tINS | FF | 1 | R34C37[0][B] | parser/n497_s0/COUT
22.206 | 0.000 | tNET | FF | 2 | R34C37[1][A] | parser/n498_s0/CIN
22.241 | 0.035 | tINS | FF | 1 | R34C37[1][A] | parser/n498_s0/COUT
22.241 | 0.000 | tNET | FF | 2 | R34C37[1][B] | parser/n499_s0/CIN
22.276 | 0.035 | tINS | FF | 1 | R34C37[1][B] | parser/n499_s0/COUT
22.276 | 0.000 | tNET | FF | 2 | R34C37[2][A] | parser/n500_s0/CIN
22.311 | 0.035 | tINS | FF | 1 | R34C37[2][A] | parser/n500_s0/COUT
23.465 | 1.154 | tNET | FF | 1 | R29C35[2][B] | parser/n626_s17/I3
24.035 | 0.570 | tINS | FR | 1 | R29C35[2][B] | parser/n626_s17/F
24.208 | 0.172 | tNET | RR | 1 | R29C36[3][B] | parser/n626_s9/I2
24.661 | 0.453 | tINS | RF | 1 | R29C36[3][B] | parser/n626_s9/F
25.058 | 0.397 | tNET | FF | 1 | R27C36[0][A] | parser/n626_s5/I2
25.429 | 0.371 | tINS | FF | 2 | R27C36[0][A] | parser/n626_s5/F
26.122 | 0.693 | tNET | FF | 1 | R30C37[0][B] | parser/n152_s3/I3
26.639 | 0.517 | tINS | FF | 72 | R30C37[0][B] | parser/n152_s3/F
28.273 | 1.634 | tNET | FF | 1 | R25C40[3][A] | parser/have_seq_s3/I0
28.600 | 0.327 | tINS | FR | 30 | R25C40[3][A] | parser/have_seq_s3/F
29.302 | 0.703 | tNET | RR | 1 | R24C36[0][A] | parser/pinch_8_s1/CE

Data Required Path:

AT | DELAY | TYPE | RF | FANOUT | LOC | NODE
31.251 | 31.251 | | | | | active clock edge time
31.251 | 0.000 | | | | | usb_core_phase
31.251 | 0.000 | tCL | RR | 886 | PLL_R[0] | usb_pll/CLKOUTP
33.522 | 2.271 | tNET | RR | 1 | R24C36[0][A] | parser/pinch_8_s1/CLK
33.487 | -0.035 | tSu | | 1 | R24C36[0][A] | parser/pinch_8_s1

Path Statistics:

Clock Skew | 0.000
Setup Relationship | 16.667
Logic Level | 9
Arrival Clock Path Delay | cell: 0.000, 0.000%; route: 2.271, 100.000%
Arrival Data Path Delay | cell: 3.245, 26.066%; route: 6.943, 55.777%; tC2Q: 2.260, 18.156%
Required Clock Path Delay | cell: 0.000, 0.000%; route: 2.271, 100.000%

### Path12

Path Summary:

Slack | 4.185
Data Arrival Time | 29.302
Data Required Time | 33.487
From | host/host_0/packet_packet_0_0_s
To | parser/pinch_9_s1
Launch Clk | usb_core_phase:[R]
Latch Clk | usb_core_phase:[R]

Data Arrival Path:

AT | DELAY | TYPE | RF | FANOUT | LOC | NODE
14.584 | 14.584 | | | | | active clock edge time
14.584 | 0.000 | | | | | usb_core_phase
14.584 | 0.000 | tCL | RR | 886 | PLL_R[0] | usb_pll/CLKOUTP
16.855 | 2.271 | tNET | RR | 8 | BSRAM_R28[8] | host/host_0/packet_packet_0_0_s/CLKB
19.115 | 2.260 | tC2Q | RF | 13 | BSRAM_R28[8] | host/host_0/packet_packet_0_0_s/DO[2]
21.305 | 2.190 | tNET | FF | 2 | R34C35[1][B] | parser/n487_s0/I0
21.854 | 0.549 | tINS | FR | 1 | R34C35[1][B] | parser/n487_s0/COUT
21.854 | 0.000 | tNET | RR | 2 | R34C35[2][A] | parser/n488_s0/CIN
21.889 | 0.035 | tINS | RF | 1 | R34C35[2][A] | parser/n488_s0/COUT
21.889 | 0.000 | tNET | FF | 2 | R34C35[2][B] | parser/n489_s0/CIN
21.924 | 0.035 | tINS | FF | 1 | R34C35[2][B] | parser/n489_s0/COUT
21.924 | 0.000 | tNET | FF | 2 | R34C36[0][A] | parser/n490_s0/CIN
21.959 | 0.035 | tINS | FF | 1 | R34C36[0][A] | parser/n490_s0/COUT
21.959 | 0.000 | tNET | FF | 2 | R34C36[0][B] | parser/n491_s0/CIN
21.994 | 0.035 | tINS | FF | 1 | R34C36[0][B] | parser/n491_s0/COUT
21.994 | 0.000 | tNET | FF | 2 | R34C36[1][A] | parser/n492_s0/CIN
22.030 | 0.035 | tINS | FF | 1 | R34C36[1][A] | parser/n492_s0/COUT
22.030 | 0.000 | tNET | FF | 2 | R34C36[1][B] | parser/n493_s0/CIN
22.065 | 0.035 | tINS | FF | 1 | R34C36[1][B] | parser/n493_s0/COUT
22.065 | 0.000 | tNET | FF | 2 | R34C36[2][A] | parser/n494_s0/CIN
22.100 | 0.035 | tINS | FF | 1 | R34C36[2][A] | parser/n494_s0/COUT
22.100 | 0.000 | tNET | FF | 2 | R34C36[2][B] | parser/n495_s0/CIN
22.135 | 0.035 | tINS | FF | 1 | R34C36[2][B] | parser/n495_s0/COUT
22.135 | 0.000 | tNET | FF | 2 | R34C37[0][A] | parser/n496_s0/CIN
22.170 | 0.035 | tINS | FF | 1 | R34C37[0][A] | parser/n496_s0/COUT
22.170 | 0.000 | tNET | FF | 2 | R34C37[0][B] | parser/n497_s0/CIN
22.206 | 0.035 | tINS | FF | 1 | R34C37[0][B] | parser/n497_s0/COUT
22.206 | 0.000 | tNET | FF | 2 | R34C37[1][A] | parser/n498_s0/CIN
22.241 | 0.035 | tINS | FF | 1 | R34C37[1][A] | parser/n498_s0/COUT
22.241 | 0.000 | tNET | FF | 2 | R34C37[1][B] | parser/n499_s0/CIN
22.276 | 0.035 | tINS | FF | 1 | R34C37[1][B] | parser/n499_s0/COUT
22.276 | 0.000 | tNET | FF | 2 | R34C37[2][A] | parser/n500_s0/CIN
22.311 | 0.035 | tINS | FF | 1 | R34C37[2][A] | parser/n500_s0/COUT
23.465 | 1.154 | tNET | FF | 1 | R29C35[2][B] | parser/n626_s17/I3
24.035 | 0.570 | tINS | FR | 1 | R29C35[2][B] | parser/n626_s17/F
24.208 | 0.172 | tNET | RR | 1 | R29C36[3][B] | parser/n626_s9/I2
24.661 | 0.453 | tINS | RF | 1 | R29C36[3][B] | parser/n626_s9/F
25.058 | 0.397 | tNET | FF | 1 | R27C36[0][A] | parser/n626_s5/I2
25.429 | 0.371 | tINS | FF | 2 | R27C36[0][A] | parser/n626_s5/F
26.122 | 0.693 | tNET | FF | 1 | R30C37[0][B] | parser/n152_s3/I3
26.639 | 0.517 | tINS | FF | 72 | R30C37[0][B] | parser/n152_s3/F
28.273 | 1.634 | tNET | FF | 1 | R25C40[3][A] | parser/have_seq_s3/I0
28.600 | 0.327 | tINS | FR | 30 | R25C40[3][A] | parser/have_seq_s3/F
29.302 | 0.703 | tNET | RR | 1 | R24C37[1][B] | parser/pinch_9_s1/CE

Data Required Path:

AT | DELAY | TYPE | RF | FANOUT | LOC | NODE
31.251 | 31.251 | | | | | active clock edge time
31.251 | 0.000 | | | | | usb_core_phase
31.251 | 0.000 | tCL | RR | 886 | PLL_R[0] | usb_pll/CLKOUTP
33.522 | 2.271 | tNET | RR | 1 | R24C37[1][B] | parser/pinch_9_s1/CLK
33.487 | -0.035 | tSu | | 1 | R24C37[1][B] | parser/pinch_9_s1

Path Statistics:

Clock Skew | 0.000
Setup Relationship | 16.667
Logic Level | 9
Arrival Clock Path Delay | cell: 0.000, 0.000%; route: 2.271, 100.000%
Arrival Data Path Delay | cell: 3.245, 26.066%; route: 6.943, 55.777%; tC2Q: 2.260, 18.156%
Required Clock Path Delay | cell: 0.000, 0.000%; route: 2.271, 100.000%

### Path13

Path Summary:

Slack | 4.185
Data Arrival Time | 29.302
Data Required Time | 33.487
From | host/host_0/packet_packet_0_0_s
To | parser/have_seq_s1
Launch Clk | usb_core_phase:[R]
Latch Clk | usb_core_phase:[R]

Data Arrival Path:

AT | DELAY | TYPE | RF | FANOUT | LOC | NODE
14.584 | 14.584 | | | | | active clock edge time
14.584 | 0.000 | | | | | usb_core_phase
14.584 | 0.000 | tCL | RR | 886 | PLL_R[0] | usb_pll/CLKOUTP
16.855 | 2.271 | tNET | RR | 8 | BSRAM_R28[8] | host/host_0/packet_packet_0_0_s/CLKB
19.115 | 2.260 | tC2Q | RF | 13 | BSRAM_R28[8] | host/host_0/packet_packet_0_0_s/DO[2]
21.305 | 2.190 | tNET | FF | 2 | R34C35[1][B] | parser/n487_s0/I0
21.854 | 0.549 | tINS | FR | 1 | R34C35[1][B] | parser/n487_s0/COUT
21.854 | 0.000 | tNET | RR | 2 | R34C35[2][A] | parser/n488_s0/CIN
21.889 | 0.035 | tINS | RF | 1 | R34C35[2][A] | parser/n488_s0/COUT
21.889 | 0.000 | tNET | FF | 2 | R34C35[2][B] | parser/n489_s0/CIN
21.924 | 0.035 | tINS | FF | 1 | R34C35[2][B] | parser/n489_s0/COUT
21.924 | 0.000 | tNET | FF | 2 | R34C36[0][A] | parser/n490_s0/CIN
21.959 | 0.035 | tINS | FF | 1 | R34C36[0][A] | parser/n490_s0/COUT
21.959 | 0.000 | tNET | FF | 2 | R34C36[0][B] | parser/n491_s0/CIN
21.994 | 0.035 | tINS | FF | 1 | R34C36[0][B] | parser/n491_s0/COUT
21.994 | 0.000 | tNET | FF | 2 | R34C36[1][A] | parser/n492_s0/CIN
22.030 | 0.035 | tINS | FF | 1 | R34C36[1][A] | parser/n492_s0/COUT
22.030 | 0.000 | tNET | FF | 2 | R34C36[1][B] | parser/n493_s0/CIN
22.065 | 0.035 | tINS | FF | 1 | R34C36[1][B] | parser/n493_s0/COUT
22.065 | 0.000 | tNET | FF | 2 | R34C36[2][A] | parser/n494_s0/CIN
22.100 | 0.035 | tINS | FF | 1 | R34C36[2][A] | parser/n494_s0/COUT
22.100 | 0.000 | tNET | FF | 2 | R34C36[2][B] | parser/n495_s0/CIN
22.135 | 0.035 | tINS | FF | 1 | R34C36[2][B] | parser/n495_s0/COUT
22.135 | 0.000 | tNET | FF | 2 | R34C37[0][A] | parser/n496_s0/CIN
22.170 | 0.035 | tINS | FF | 1 | R34C37[0][A] | parser/n496_s0/COUT
22.170 | 0.000 | tNET | FF | 2 | R34C37[0][B] | parser/n497_s0/CIN
22.206 | 0.035 | tINS | FF | 1 | R34C37[0][B] | parser/n497_s0/COUT
22.206 | 0.000 | tNET | FF | 2 | R34C37[1][A] | parser/n498_s0/CIN
22.241 | 0.035 | tINS | FF | 1 | R34C37[1][A] | parser/n498_s0/COUT
22.241 | 0.000 | tNET | FF | 2 | R34C37[1][B] | parser/n499_s0/CIN
22.276 | 0.035 | tINS | FF | 1 | R34C37[1][B] | parser/n499_s0/COUT
22.276 | 0.000 | tNET | FF | 2 | R34C37[2][A] | parser/n500_s0/CIN
22.311 | 0.035 | tINS | FF | 1 | R34C37[2][A] | parser/n500_s0/COUT
23.465 | 1.154 | tNET | FF | 1 | R29C35[2][B] | parser/n626_s17/I3
24.035 | 0.570 | tINS | FR | 1 | R29C35[2][B] | parser/n626_s17/F
24.208 | 0.172 | tNET | RR | 1 | R29C36[3][B] | parser/n626_s9/I2
24.661 | 0.453 | tINS | RF | 1 | R29C36[3][B] | parser/n626_s9/F
25.058 | 0.397 | tNET | FF | 1 | R27C36[0][A] | parser/n626_s5/I2
25.429 | 0.371 | tINS | FF | 2 | R27C36[0][A] | parser/n626_s5/F
26.122 | 0.693 | tNET | FF | 1 | R30C37[0][B] | parser/n152_s3/I3
26.639 | 0.517 | tINS | FF | 72 | R30C37[0][B] | parser/n152_s3/F
28.273 | 1.634 | tNET | FF | 1 | R25C40[3][A] | parser/have_seq_s3/I0
28.600 | 0.327 | tINS | FR | 30 | R25C40[3][A] | parser/have_seq_s3/F
29.302 | 0.703 | tNET | RR | 1 | R27C36[1][A] | parser/have_seq_s1/CE

Data Required Path:

AT | DELAY | TYPE | RF | FANOUT | LOC | NODE
31.251 | 31.251 | | | | | active clock edge time
31.251 | 0.000 | | | | | usb_core_phase
31.251 | 0.000 | tCL | RR | 886 | PLL_R[0] | usb_pll/CLKOUTP
33.522 | 2.271 | tNET | RR | 1 | R27C36[1][A] | parser/have_seq_s1/CLK
33.487 | -0.035 | tSu | | 1 | R27C36[1][A] | parser/have_seq_s1

Path Statistics:

Clock Skew | 0.000
Setup Relationship | 16.667
Logic Level | 9
Arrival Clock Path Delay | cell: 0.000, 0.000%; route: 2.271, 100.000%
Arrival Data Path Delay | cell: 3.245, 26.066%; route: 6.943, 55.777%; tC2Q: 2.260, 18.156%
Required Clock Path Delay | cell: 0.000, 0.000%; route: 2.271, 100.000%

### Path14

Path Summary:

Slack | 4.338
Data Arrival Time | 29.149
Data Required Time | 33.487
From | host/host_0/packet_packet_0_0_s
To | parser/lease_24_s1
Launch Clk | usb_core_phase:[R]
Latch Clk | usb_core_phase:[R]

Data Arrival Path:

AT | DELAY | TYPE | RF | FANOUT | LOC | NODE
14.584 | 14.584 | | | | | active clock edge time
14.584 | 0.000 | | | | | usb_core_phase
14.584 | 0.000 | tCL | RR | 886 | PLL_R[0] | usb_pll/CLKOUTP
16.855 | 2.271 | tNET | RR | 8 | BSRAM_R28[8] | host/host_0/packet_packet_0_0_s/CLKB
19.115 | 2.260 | tC2Q | RF | 13 | BSRAM_R28[8] | host/host_0/packet_packet_0_0_s/DO[2]
21.305 | 2.190 | tNET | FF | 2 | R34C35[1][B] | parser/n487_s0/I0
21.854 | 0.549 | tINS | FR | 1 | R34C35[1][B] | parser/n487_s0/COUT
21.854 | 0.000 | tNET | RR | 2 | R34C35[2][A] | parser/n488_s0/CIN
21.889 | 0.035 | tINS | RF | 1 | R34C35[2][A] | parser/n488_s0/COUT
21.889 | 0.000 | tNET | FF | 2 | R34C35[2][B] | parser/n489_s0/CIN
21.924 | 0.035 | tINS | FF | 1 | R34C35[2][B] | parser/n489_s0/COUT
21.924 | 0.000 | tNET | FF | 2 | R34C36[0][A] | parser/n490_s0/CIN
21.959 | 0.035 | tINS | FF | 1 | R34C36[0][A] | parser/n490_s0/COUT
21.959 | 0.000 | tNET | FF | 2 | R34C36[0][B] | parser/n491_s0/CIN
21.994 | 0.035 | tINS | FF | 1 | R34C36[0][B] | parser/n491_s0/COUT
21.994 | 0.000 | tNET | FF | 2 | R34C36[1][A] | parser/n492_s0/CIN
22.030 | 0.035 | tINS | FF | 1 | R34C36[1][A] | parser/n492_s0/COUT
22.030 | 0.000 | tNET | FF | 2 | R34C36[1][B] | parser/n493_s0/CIN
22.065 | 0.035 | tINS | FF | 1 | R34C36[1][B] | parser/n493_s0/COUT
22.065 | 0.000 | tNET | FF | 2 | R34C36[2][A] | parser/n494_s0/CIN
22.100 | 0.035 | tINS | FF | 1 | R34C36[2][A] | parser/n494_s0/COUT
22.100 | 0.000 | tNET | FF | 2 | R34C36[2][B] | parser/n495_s0/CIN
22.135 | 0.035 | tINS | FF | 1 | R34C36[2][B] | parser/n495_s0/COUT
22.135 | 0.000 | tNET | FF | 2 | R34C37[0][A] | parser/n496_s0/CIN
22.170 | 0.035 | tINS | FF | 1 | R34C37[0][A] | parser/n496_s0/COUT
22.170 | 0.000 | tNET | FF | 2 | R34C37[0][B] | parser/n497_s0/CIN
22.206 | 0.035 | tINS | FF | 1 | R34C37[0][B] | parser/n497_s0/COUT
22.206 | 0.000 | tNET | FF | 2 | R34C37[1][A] | parser/n498_s0/CIN
22.241 | 0.035 | tINS | FF | 1 | R34C37[1][A] | parser/n498_s0/COUT
22.241 | 0.000 | tNET | FF | 2 | R34C37[1][B] | parser/n499_s0/CIN
22.276 | 0.035 | tINS | FF | 1 | R34C37[1][B] | parser/n499_s0/COUT
22.276 | 0.000 | tNET | FF | 2 | R34C37[2][A] | parser/n500_s0/CIN
22.311 | 0.035 | tINS | FF | 1 | R34C37[2][A] | parser/n500_s0/COUT
23.465 | 1.154 | tNET | FF | 1 | R29C35[2][B] | parser/n626_s17/I3
24.035 | 0.570 | tINS | FR | 1 | R29C35[2][B] | parser/n626_s17/F
24.208 | 0.172 | tNET | RR | 1 | R29C36[3][B] | parser/n626_s9/I2
24.661 | 0.453 | tINS | RF | 1 | R29C36[3][B] | parser/n626_s9/F
25.058 | 0.397 | tNET | FF | 1 | R27C36[0][A] | parser/n626_s5/I2
25.429 | 0.371 | tINS | FF | 2 | R27C36[0][A] | parser/n626_s5/F
26.122 | 0.693 | tNET | FF | 1 | R30C37[0][B] | parser/n152_s3/I3
26.639 | 0.517 | tINS | FF | 72 | R30C37[0][B] | parser/n152_s3/F
28.244 | 1.605 | tNET | FF | 1 | R32C37[0][B] | parser/lease_31_s7/I1
28.571 | 0.327 | tINS | FR | 31 | R32C37[0][B] | parser/lease_31_s7/F
29.149 | 0.578 | tNET | RR | 1 | R31C40[1][B] | parser/lease_24_s1/CE

Data Required Path:

AT | DELAY | TYPE | RF | FANOUT | LOC | NODE
31.251 | 31.251 | | | | | active clock edge time
31.251 | 0.000 | | | | | usb_core_phase
31.251 | 0.000 | tCL | RR | 886 | PLL_R[0] | usb_pll/CLKOUTP
33.522 | 2.271 | tNET | RR | 1 | R31C40[1][B] | parser/lease_24_s1/CLK
33.487 | -0.035 | tSu | | 1 | R31C40[1][B] | parser/lease_24_s1

Path Statistics:

Clock Skew | 0.000
Setup Relationship | 16.667
Logic Level | 9
Arrival Clock Path Delay | cell: 0.000, 0.000%; route: 2.271, 100.000%
Arrival Data Path Delay | cell: 3.245, 26.391%; route: 6.790, 55.226%; tC2Q: 2.260, 18.383%
Required Clock Path Delay | cell: 0.000, 0.000%; route: 2.271, 100.000%

### Path15

Path Summary:

Slack | 4.338
Data Arrival Time | 29.149
Data Required Time | 33.487
From | host/host_0/packet_packet_0_0_s
To | parser/lease_25_s1
Launch Clk | usb_core_phase:[R]
Latch Clk | usb_core_phase:[R]

Data Arrival Path:

AT | DELAY | TYPE | RF | FANOUT | LOC | NODE
14.584 | 14.584 | | | | | active clock edge time
14.584 | 0.000 | | | | | usb_core_phase
14.584 | 0.000 | tCL | RR | 886 | PLL_R[0] | usb_pll/CLKOUTP
16.855 | 2.271 | tNET | RR | 8 | BSRAM_R28[8] | host/host_0/packet_packet_0_0_s/CLKB
19.115 | 2.260 | tC2Q | RF | 13 | BSRAM_R28[8] | host/host_0/packet_packet_0_0_s/DO[2]
21.305 | 2.190 | tNET | FF | 2 | R34C35[1][B] | parser/n487_s0/I0
21.854 | 0.549 | tINS | FR | 1 | R34C35[1][B] | parser/n487_s0/COUT
21.854 | 0.000 | tNET | RR | 2 | R34C35[2][A] | parser/n488_s0/CIN
21.889 | 0.035 | tINS | RF | 1 | R34C35[2][A] | parser/n488_s0/COUT
21.889 | 0.000 | tNET | FF | 2 | R34C35[2][B] | parser/n489_s0/CIN
21.924 | 0.035 | tINS | FF | 1 | R34C35[2][B] | parser/n489_s0/COUT
21.924 | 0.000 | tNET | FF | 2 | R34C36[0][A] | parser/n490_s0/CIN
21.959 | 0.035 | tINS | FF | 1 | R34C36[0][A] | parser/n490_s0/COUT
21.959 | 0.000 | tNET | FF | 2 | R34C36[0][B] | parser/n491_s0/CIN
21.994 | 0.035 | tINS | FF | 1 | R34C36[0][B] | parser/n491_s0/COUT
21.994 | 0.000 | tNET | FF | 2 | R34C36[1][A] | parser/n492_s0/CIN
22.030 | 0.035 | tINS | FF | 1 | R34C36[1][A] | parser/n492_s0/COUT
22.030 | 0.000 | tNET | FF | 2 | R34C36[1][B] | parser/n493_s0/CIN
22.065 | 0.035 | tINS | FF | 1 | R34C36[1][B] | parser/n493_s0/COUT
22.065 | 0.000 | tNET | FF | 2 | R34C36[2][A] | parser/n494_s0/CIN
22.100 | 0.035 | tINS | FF | 1 | R34C36[2][A] | parser/n494_s0/COUT
22.100 | 0.000 | tNET | FF | 2 | R34C36[2][B] | parser/n495_s0/CIN
22.135 | 0.035 | tINS | FF | 1 | R34C36[2][B] | parser/n495_s0/COUT
22.135 | 0.000 | tNET | FF | 2 | R34C37[0][A] | parser/n496_s0/CIN
22.170 | 0.035 | tINS | FF | 1 | R34C37[0][A] | parser/n496_s0/COUT
22.170 | 0.000 | tNET | FF | 2 | R34C37[0][B] | parser/n497_s0/CIN
22.206 | 0.035 | tINS | FF | 1 | R34C37[0][B] | parser/n497_s0/COUT
22.206 | 0.000 | tNET | FF | 2 | R34C37[1][A] | parser/n498_s0/CIN
22.241 | 0.035 | tINS | FF | 1 | R34C37[1][A] | parser/n498_s0/COUT
22.241 | 0.000 | tNET | FF | 2 | R34C37[1][B] | parser/n499_s0/CIN
22.276 | 0.035 | tINS | FF | 1 | R34C37[1][B] | parser/n499_s0/COUT
22.276 | 0.000 | tNET | FF | 2 | R34C37[2][A] | parser/n500_s0/CIN
22.311 | 0.035 | tINS | FF | 1 | R34C37[2][A] | parser/n500_s0/COUT
23.465 | 1.154 | tNET | FF | 1 | R29C35[2][B] | parser/n626_s17/I3
24.035 | 0.570 | tINS | FR | 1 | R29C35[2][B] | parser/n626_s17/F
24.208 | 0.172 | tNET | RR | 1 | R29C36[3][B] | parser/n626_s9/I2
24.661 | 0.453 | tINS | RF | 1 | R29C36[3][B] | parser/n626_s9/F
25.058 | 0.397 | tNET | FF | 1 | R27C36[0][A] | parser/n626_s5/I2
25.429 | 0.371 | tINS | FF | 2 | R27C36[0][A] | parser/n626_s5/F
26.122 | 0.693 | tNET | FF | 1 | R30C37[0][B] | parser/n152_s3/I3
26.639 | 0.517 | tINS | FF | 72 | R30C37[0][B] | parser/n152_s3/F
28.244 | 1.605 | tNET | FF | 1 | R32C37[0][B] | parser/lease_31_s7/I1
28.571 | 0.327 | tINS | FR | 31 | R32C37[0][B] | parser/lease_31_s7/F
29.149 | 0.578 | tNET | RR | 1 | R31C40[2][A] | parser/lease_25_s1/CE

Data Required Path:

AT | DELAY | TYPE | RF | FANOUT | LOC | NODE
31.251 | 31.251 | | | | | active clock edge time
31.251 | 0.000 | | | | | usb_core_phase
31.251 | 0.000 | tCL | RR | 886 | PLL_R[0] | usb_pll/CLKOUTP
33.522 | 2.271 | tNET | RR | 1 | R31C40[2][A] | parser/lease_25_s1/CLK
33.487 | -0.035 | tSu | | 1 | R31C40[2][A] | parser/lease_25_s1

Path Statistics:

Clock Skew | 0.000
Setup Relationship | 16.667
Logic Level | 9
Arrival Clock Path Delay | cell: 0.000, 0.000%; route: 2.271, 100.000%
Arrival Data Path Delay | cell: 3.245, 26.391%; route: 6.790, 55.226%; tC2Q: 2.260, 18.383%
Required Clock Path Delay | cell: 0.000, 0.000%; route: 2.271, 100.000%

### Path16

Path Summary:

Slack | 4.338
Data Arrival Time | 29.149
Data Required Time | 33.487
From | host/host_0/packet_packet_0_0_s
To | parser/lease_28_s1
Launch Clk | usb_core_phase:[R]
Latch Clk | usb_core_phase:[R]

Data Arrival Path:

AT | DELAY | TYPE | RF | FANOUT | LOC | NODE
14.584 | 14.584 | | | | | active clock edge time
14.584 | 0.000 | | | | | usb_core_phase
14.584 | 0.000 | tCL | RR | 886 | PLL_R[0] | usb_pll/CLKOUTP
16.855 | 2.271 | tNET | RR | 8 | BSRAM_R28[8] | host/host_0/packet_packet_0_0_s/CLKB
19.115 | 2.260 | tC2Q | RF | 13 | BSRAM_R28[8] | host/host_0/packet_packet_0_0_s/DO[2]
21.305 | 2.190 | tNET | FF | 2 | R34C35[1][B] | parser/n487_s0/I0
21.854 | 0.549 | tINS | FR | 1 | R34C35[1][B] | parser/n487_s0/COUT
21.854 | 0.000 | tNET | RR | 2 | R34C35[2][A] | parser/n488_s0/CIN
21.889 | 0.035 | tINS | RF | 1 | R34C35[2][A] | parser/n488_s0/COUT
21.889 | 0.000 | tNET | FF | 2 | R34C35[2][B] | parser/n489_s0/CIN
21.924 | 0.035 | tINS | FF | 1 | R34C35[2][B] | parser/n489_s0/COUT
21.924 | 0.000 | tNET | FF | 2 | R34C36[0][A] | parser/n490_s0/CIN
21.959 | 0.035 | tINS | FF | 1 | R34C36[0][A] | parser/n490_s0/COUT
21.959 | 0.000 | tNET | FF | 2 | R34C36[0][B] | parser/n491_s0/CIN
21.994 | 0.035 | tINS | FF | 1 | R34C36[0][B] | parser/n491_s0/COUT
21.994 | 0.000 | tNET | FF | 2 | R34C36[1][A] | parser/n492_s0/CIN
22.030 | 0.035 | tINS | FF | 1 | R34C36[1][A] | parser/n492_s0/COUT
22.030 | 0.000 | tNET | FF | 2 | R34C36[1][B] | parser/n493_s0/CIN
22.065 | 0.035 | tINS | FF | 1 | R34C36[1][B] | parser/n493_s0/COUT
22.065 | 0.000 | tNET | FF | 2 | R34C36[2][A] | parser/n494_s0/CIN
22.100 | 0.035 | tINS | FF | 1 | R34C36[2][A] | parser/n494_s0/COUT
22.100 | 0.000 | tNET | FF | 2 | R34C36[2][B] | parser/n495_s0/CIN
22.135 | 0.035 | tINS | FF | 1 | R34C36[2][B] | parser/n495_s0/COUT
22.135 | 0.000 | tNET | FF | 2 | R34C37[0][A] | parser/n496_s0/CIN
22.170 | 0.035 | tINS | FF | 1 | R34C37[0][A] | parser/n496_s0/COUT
22.170 | 0.000 | tNET | FF | 2 | R34C37[0][B] | parser/n497_s0/CIN
22.206 | 0.035 | tINS | FF | 1 | R34C37[0][B] | parser/n497_s0/COUT
22.206 | 0.000 | tNET | FF | 2 | R34C37[1][A] | parser/n498_s0/CIN
22.241 | 0.035 | tINS | FF | 1 | R34C37[1][A] | parser/n498_s0/COUT
22.241 | 0.000 | tNET | FF | 2 | R34C37[1][B] | parser/n499_s0/CIN
22.276 | 0.035 | tINS | FF | 1 | R34C37[1][B] | parser/n499_s0/COUT
22.276 | 0.000 | tNET | FF | 2 | R34C37[2][A] | parser/n500_s0/CIN
22.311 | 0.035 | tINS | FF | 1 | R34C37[2][A] | parser/n500_s0/COUT
23.465 | 1.154 | tNET | FF | 1 | R29C35[2][B] | parser/n626_s17/I3
24.035 | 0.570 | tINS | FR | 1 | R29C35[2][B] | parser/n626_s17/F
24.208 | 0.172 | tNET | RR | 1 | R29C36[3][B] | parser/n626_s9/I2
24.661 | 0.453 | tINS | RF | 1 | R29C36[3][B] | parser/n626_s9/F
25.058 | 0.397 | tNET | FF | 1 | R27C36[0][A] | parser/n626_s5/I2
25.429 | 0.371 | tINS | FF | 2 | R27C36[0][A] | parser/n626_s5/F
26.122 | 0.693 | tNET | FF | 1 | R30C37[0][B] | parser/n152_s3/I3
26.639 | 0.517 | tINS | FF | 72 | R30C37[0][B] | parser/n152_s3/F
28.244 | 1.605 | tNET | FF | 1 | R32C37[0][B] | parser/lease_31_s7/I1
28.571 | 0.327 | tINS | FR | 31 | R32C37[0][B] | parser/lease_31_s7/F
29.149 | 0.578 | tNET | RR | 1 | R31C40[0][B] | parser/lease_28_s1/CE

Data Required Path:

AT | DELAY | TYPE | RF | FANOUT | LOC | NODE
31.251 | 31.251 | | | | | active clock edge time
31.251 | 0.000 | | | | | usb_core_phase
31.251 | 0.000 | tCL | RR | 886 | PLL_R[0] | usb_pll/CLKOUTP
33.522 | 2.271 | tNET | RR | 1 | R31C40[0][B] | parser/lease_28_s1/CLK
33.487 | -0.035 | tSu | | 1 | R31C40[0][B] | parser/lease_28_s1

Path Statistics:

Clock Skew | 0.000
Setup Relationship | 16.667
Logic Level | 9
Arrival Clock Path Delay | cell: 0.000, 0.000%; route: 2.271, 100.000%
Arrival Data Path Delay | cell: 3.245, 26.391%; route: 6.790, 55.226%; tC2Q: 2.260, 18.383%
Required Clock Path Delay | cell: 0.000, 0.000%; route: 2.271, 100.000%

### Path17

Path Summary:

Slack | 4.345
Data Arrival Time | 29.142
Data Required Time | 33.487
From | host/host_0/packet_packet_0_0_s
To | parser/lease_10_s1
Launch Clk | usb_core_phase:[R]
Latch Clk | usb_core_phase:[R]

Data Arrival Path:

AT | DELAY | TYPE | RF | FANOUT | LOC | NODE
14.584 | 14.584 | | | | | active clock edge time
14.584 | 0.000 | | | | | usb_core_phase
14.584 | 0.000 | tCL | RR | 886 | PLL_R[0] | usb_pll/CLKOUTP
16.855 | 2.271 | tNET | RR | 8 | BSRAM_R28[8] | host/host_0/packet_packet_0_0_s/CLKB
19.115 | 2.260 | tC2Q | RF | 13 | BSRAM_R28[8] | host/host_0/packet_packet_0_0_s/DO[2]
21.305 | 2.190 | tNET | FF | 2 | R34C35[1][B] | parser/n487_s0/I0
21.854 | 0.549 | tINS | FR | 1 | R34C35[1][B] | parser/n487_s0/COUT
21.854 | 0.000 | tNET | RR | 2 | R34C35[2][A] | parser/n488_s0/CIN
21.889 | 0.035 | tINS | RF | 1 | R34C35[2][A] | parser/n488_s0/COUT
21.889 | 0.000 | tNET | FF | 2 | R34C35[2][B] | parser/n489_s0/CIN
21.924 | 0.035 | tINS | FF | 1 | R34C35[2][B] | parser/n489_s0/COUT
21.924 | 0.000 | tNET | FF | 2 | R34C36[0][A] | parser/n490_s0/CIN
21.959 | 0.035 | tINS | FF | 1 | R34C36[0][A] | parser/n490_s0/COUT
21.959 | 0.000 | tNET | FF | 2 | R34C36[0][B] | parser/n491_s0/CIN
21.994 | 0.035 | tINS | FF | 1 | R34C36[0][B] | parser/n491_s0/COUT
21.994 | 0.000 | tNET | FF | 2 | R34C36[1][A] | parser/n492_s0/CIN
22.030 | 0.035 | tINS | FF | 1 | R34C36[1][A] | parser/n492_s0/COUT
22.030 | 0.000 | tNET | FF | 2 | R34C36[1][B] | parser/n493_s0/CIN
22.065 | 0.035 | tINS | FF | 1 | R34C36[1][B] | parser/n493_s0/COUT
22.065 | 0.000 | tNET | FF | 2 | R34C36[2][A] | parser/n494_s0/CIN
22.100 | 0.035 | tINS | FF | 1 | R34C36[2][A] | parser/n494_s0/COUT
22.100 | 0.000 | tNET | FF | 2 | R34C36[2][B] | parser/n495_s0/CIN
22.135 | 0.035 | tINS | FF | 1 | R34C36[2][B] | parser/n495_s0/COUT
22.135 | 0.000 | tNET | FF | 2 | R34C37[0][A] | parser/n496_s0/CIN
22.170 | 0.035 | tINS | FF | 1 | R34C37[0][A] | parser/n496_s0/COUT
22.170 | 0.000 | tNET | FF | 2 | R34C37[0][B] | parser/n497_s0/CIN
22.206 | 0.035 | tINS | FF | 1 | R34C37[0][B] | parser/n497_s0/COUT
22.206 | 0.000 | tNET | FF | 2 | R34C37[1][A] | parser/n498_s0/CIN
22.241 | 0.035 | tINS | FF | 1 | R34C37[1][A] | parser/n498_s0/COUT
22.241 | 0.000 | tNET | FF | 2 | R34C37[1][B] | parser/n499_s0/CIN
22.276 | 0.035 | tINS | FF | 1 | R34C37[1][B] | parser/n499_s0/COUT
22.276 | 0.000 | tNET | FF | 2 | R34C37[2][A] | parser/n500_s0/CIN
22.311 | 0.035 | tINS | FF | 1 | R34C37[2][A] | parser/n500_s0/COUT
23.465 | 1.154 | tNET | FF | 1 | R29C35[2][B] | parser/n626_s17/I3
24.035 | 0.570 | tINS | FR | 1 | R29C35[2][B] | parser/n626_s17/F
24.208 | 0.172 | tNET | RR | 1 | R29C36[3][B] | parser/n626_s9/I2
24.661 | 0.453 | tINS | RF | 1 | R29C36[3][B] | parser/n626_s9/F
25.058 | 0.397 | tNET | FF | 1 | R27C36[0][A] | parser/n626_s5/I2
25.429 | 0.371 | tINS | FF | 2 | R27C36[0][A] | parser/n626_s5/F
26.122 | 0.693 | tNET | FF | 1 | R30C37[0][B] | parser/n152_s3/I3
26.639 | 0.517 | tINS | FF | 72 | R30C37[0][B] | parser/n152_s3/F
28.244 | 1.605 | tNET | FF | 1 | R32C37[0][B] | parser/lease_31_s7/I1
28.571 | 0.327 | tINS | FR | 31 | R32C37[0][B] | parser/lease_31_s7/F
29.142 | 0.571 | tNET | RR | 1 | R33C35[0][B] | parser/lease_10_s1/CE

Data Required Path:

AT | DELAY | TYPE | RF | FANOUT | LOC | NODE
31.251 | 31.251 | | | | | active clock edge time
31.251 | 0.000 | | | | | usb_core_phase
31.251 | 0.000 | tCL | RR | 886 | PLL_R[0] | usb_pll/CLKOUTP
33.522 | 2.271 | tNET | RR | 1 | R33C35[0][B] | parser/lease_10_s1/CLK
33.487 | -0.035 | tSu | | 1 | R33C35[0][B] | parser/lease_10_s1

Path Statistics:

Clock Skew | 0.000
Setup Relationship | 16.667
Logic Level | 9
Arrival Clock Path Delay | cell: 0.000, 0.000%; route: 2.271, 100.000%
Arrival Data Path Delay | cell: 3.245, 26.407%; route: 6.782, 55.200%; tC2Q: 2.260, 18.393%
Required Clock Path Delay | cell: 0.000, 0.000%; route: 2.271, 100.000%

### Path18

Path Summary:

Slack | 4.345
Data Arrival Time | 29.142
Data Required Time | 33.487
From | host/host_0/packet_packet_0_0_s
To | parser/lease_11_s1
Launch Clk | usb_core_phase:[R]
Latch Clk | usb_core_phase:[R]

Data Arrival Path:

AT | DELAY | TYPE | RF | FANOUT | LOC | NODE
14.584 | 14.584 | | | | | active clock edge time
14.584 | 0.000 | | | | | usb_core_phase
14.584 | 0.000 | tCL | RR | 886 | PLL_R[0] | usb_pll/CLKOUTP
16.855 | 2.271 | tNET | RR | 8 | BSRAM_R28[8] | host/host_0/packet_packet_0_0_s/CLKB
19.115 | 2.260 | tC2Q | RF | 13 | BSRAM_R28[8] | host/host_0/packet_packet_0_0_s/DO[2]
21.305 | 2.190 | tNET | FF | 2 | R34C35[1][B] | parser/n487_s0/I0
21.854 | 0.549 | tINS | FR | 1 | R34C35[1][B] | parser/n487_s0/COUT
21.854 | 0.000 | tNET | RR | 2 | R34C35[2][A] | parser/n488_s0/CIN
21.889 | 0.035 | tINS | RF | 1 | R34C35[2][A] | parser/n488_s0/COUT
21.889 | 0.000 | tNET | FF | 2 | R34C35[2][B] | parser/n489_s0/CIN
21.924 | 0.035 | tINS | FF | 1 | R34C35[2][B] | parser/n489_s0/COUT
21.924 | 0.000 | tNET | FF | 2 | R34C36[0][A] | parser/n490_s0/CIN
21.959 | 0.035 | tINS | FF | 1 | R34C36[0][A] | parser/n490_s0/COUT
21.959 | 0.000 | tNET | FF | 2 | R34C36[0][B] | parser/n491_s0/CIN
21.994 | 0.035 | tINS | FF | 1 | R34C36[0][B] | parser/n491_s0/COUT
21.994 | 0.000 | tNET | FF | 2 | R34C36[1][A] | parser/n492_s0/CIN
22.030 | 0.035 | tINS | FF | 1 | R34C36[1][A] | parser/n492_s0/COUT
22.030 | 0.000 | tNET | FF | 2 | R34C36[1][B] | parser/n493_s0/CIN
22.065 | 0.035 | tINS | FF | 1 | R34C36[1][B] | parser/n493_s0/COUT
22.065 | 0.000 | tNET | FF | 2 | R34C36[2][A] | parser/n494_s0/CIN
22.100 | 0.035 | tINS | FF | 1 | R34C36[2][A] | parser/n494_s0/COUT
22.100 | 0.000 | tNET | FF | 2 | R34C36[2][B] | parser/n495_s0/CIN
22.135 | 0.035 | tINS | FF | 1 | R34C36[2][B] | parser/n495_s0/COUT
22.135 | 0.000 | tNET | FF | 2 | R34C37[0][A] | parser/n496_s0/CIN
22.170 | 0.035 | tINS | FF | 1 | R34C37[0][A] | parser/n496_s0/COUT
22.170 | 0.000 | tNET | FF | 2 | R34C37[0][B] | parser/n497_s0/CIN
22.206 | 0.035 | tINS | FF | 1 | R34C37[0][B] | parser/n497_s0/COUT
22.206 | 0.000 | tNET | FF | 2 | R34C37[1][A] | parser/n498_s0/CIN
22.241 | 0.035 | tINS | FF | 1 | R34C37[1][A] | parser/n498_s0/COUT
22.241 | 0.000 | tNET | FF | 2 | R34C37[1][B] | parser/n499_s0/CIN
22.276 | 0.035 | tINS | FF | 1 | R34C37[1][B] | parser/n499_s0/COUT
22.276 | 0.000 | tNET | FF | 2 | R34C37[2][A] | parser/n500_s0/CIN
22.311 | 0.035 | tINS | FF | 1 | R34C37[2][A] | parser/n500_s0/COUT
23.465 | 1.154 | tNET | FF | 1 | R29C35[2][B] | parser/n626_s17/I3
24.035 | 0.570 | tINS | FR | 1 | R29C35[2][B] | parser/n626_s17/F
24.208 | 0.172 | tNET | RR | 1 | R29C36[3][B] | parser/n626_s9/I2
24.661 | 0.453 | tINS | RF | 1 | R29C36[3][B] | parser/n626_s9/F
25.058 | 0.397 | tNET | FF | 1 | R27C36[0][A] | parser/n626_s5/I2
25.429 | 0.371 | tINS | FF | 2 | R27C36[0][A] | parser/n626_s5/F
26.122 | 0.693 | tNET | FF | 1 | R30C37[0][B] | parser/n152_s3/I3
26.639 | 0.517 | tINS | FF | 72 | R30C37[0][B] | parser/n152_s3/F
28.244 | 1.605 | tNET | FF | 1 | R32C37[0][B] | parser/lease_31_s7/I1
28.571 | 0.327 | tINS | FR | 31 | R32C37[0][B] | parser/lease_31_s7/F
29.142 | 0.571 | tNET | RR | 1 | R33C35[1][A] | parser/lease_11_s1/CE

Data Required Path:

AT | DELAY | TYPE | RF | FANOUT | LOC | NODE
31.251 | 31.251 | | | | | active clock edge time
31.251 | 0.000 | | | | | usb_core_phase
31.251 | 0.000 | tCL | RR | 886 | PLL_R[0] | usb_pll/CLKOUTP
33.522 | 2.271 | tNET | RR | 1 | R33C35[1][A] | parser/lease_11_s1/CLK
33.487 | -0.035 | tSu | | 1 | R33C35[1][A] | parser/lease_11_s1

Path Statistics:

Clock Skew | 0.000
Setup Relationship | 16.667
Logic Level | 9
Arrival Clock Path Delay | cell: 0.000, 0.000%; route: 2.271, 100.000%
Arrival Data Path Delay | cell: 3.245, 26.407%; route: 6.782, 55.200%; tC2Q: 2.260, 18.393%
Required Clock Path Delay | cell: 0.000, 0.000%; route: 2.271, 100.000%

### Path19

Path Summary:

Slack | 4.345
Data Arrival Time | 29.142
Data Required Time | 33.487
From | host/host_0/packet_packet_0_0_s
To | parser/lease_12_s1
Launch Clk | usb_core_phase:[R]
Latch Clk | usb_core_phase:[R]

Data Arrival Path:

AT | DELAY | TYPE | RF | FANOUT | LOC | NODE
14.584 | 14.584 | | | | | active clock edge time
14.584 | 0.000 | | | | | usb_core_phase
14.584 | 0.000 | tCL | RR | 886 | PLL_R[0] | usb_pll/CLKOUTP
16.855 | 2.271 | tNET | RR | 8 | BSRAM_R28[8] | host/host_0/packet_packet_0_0_s/CLKB
19.115 | 2.260 | tC2Q | RF | 13 | BSRAM_R28[8] | host/host_0/packet_packet_0_0_s/DO[2]
21.305 | 2.190 | tNET | FF | 2 | R34C35[1][B] | parser/n487_s0/I0
21.854 | 0.549 | tINS | FR | 1 | R34C35[1][B] | parser/n487_s0/COUT
21.854 | 0.000 | tNET | RR | 2 | R34C35[2][A] | parser/n488_s0/CIN
21.889 | 0.035 | tINS | RF | 1 | R34C35[2][A] | parser/n488_s0/COUT
21.889 | 0.000 | tNET | FF | 2 | R34C35[2][B] | parser/n489_s0/CIN
21.924 | 0.035 | tINS | FF | 1 | R34C35[2][B] | parser/n489_s0/COUT
21.924 | 0.000 | tNET | FF | 2 | R34C36[0][A] | parser/n490_s0/CIN
21.959 | 0.035 | tINS | FF | 1 | R34C36[0][A] | parser/n490_s0/COUT
21.959 | 0.000 | tNET | FF | 2 | R34C36[0][B] | parser/n491_s0/CIN
21.994 | 0.035 | tINS | FF | 1 | R34C36[0][B] | parser/n491_s0/COUT
21.994 | 0.000 | tNET | FF | 2 | R34C36[1][A] | parser/n492_s0/CIN
22.030 | 0.035 | tINS | FF | 1 | R34C36[1][A] | parser/n492_s0/COUT
22.030 | 0.000 | tNET | FF | 2 | R34C36[1][B] | parser/n493_s0/CIN
22.065 | 0.035 | tINS | FF | 1 | R34C36[1][B] | parser/n493_s0/COUT
22.065 | 0.000 | tNET | FF | 2 | R34C36[2][A] | parser/n494_s0/CIN
22.100 | 0.035 | tINS | FF | 1 | R34C36[2][A] | parser/n494_s0/COUT
22.100 | 0.000 | tNET | FF | 2 | R34C36[2][B] | parser/n495_s0/CIN
22.135 | 0.035 | tINS | FF | 1 | R34C36[2][B] | parser/n495_s0/COUT
22.135 | 0.000 | tNET | FF | 2 | R34C37[0][A] | parser/n496_s0/CIN
22.170 | 0.035 | tINS | FF | 1 | R34C37[0][A] | parser/n496_s0/COUT
22.170 | 0.000 | tNET | FF | 2 | R34C37[0][B] | parser/n497_s0/CIN
22.206 | 0.035 | tINS | FF | 1 | R34C37[0][B] | parser/n497_s0/COUT
22.206 | 0.000 | tNET | FF | 2 | R34C37[1][A] | parser/n498_s0/CIN
22.241 | 0.035 | tINS | FF | 1 | R34C37[1][A] | parser/n498_s0/COUT
22.241 | 0.000 | tNET | FF | 2 | R34C37[1][B] | parser/n499_s0/CIN
22.276 | 0.035 | tINS | FF | 1 | R34C37[1][B] | parser/n499_s0/COUT
22.276 | 0.000 | tNET | FF | 2 | R34C37[2][A] | parser/n500_s0/CIN
22.311 | 0.035 | tINS | FF | 1 | R34C37[2][A] | parser/n500_s0/COUT
23.465 | 1.154 | tNET | FF | 1 | R29C35[2][B] | parser/n626_s17/I3
24.035 | 0.570 | tINS | FR | 1 | R29C35[2][B] | parser/n626_s17/F
24.208 | 0.172 | tNET | RR | 1 | R29C36[3][B] | parser/n626_s9/I2
24.661 | 0.453 | tINS | RF | 1 | R29C36[3][B] | parser/n626_s9/F
25.058 | 0.397 | tNET | FF | 1 | R27C36[0][A] | parser/n626_s5/I2
25.429 | 0.371 | tINS | FF | 2 | R27C36[0][A] | parser/n626_s5/F
26.122 | 0.693 | tNET | FF | 1 | R30C37[0][B] | parser/n152_s3/I3
26.639 | 0.517 | tINS | FF | 72 | R30C37[0][B] | parser/n152_s3/F
28.244 | 1.605 | tNET | FF | 1 | R32C37[0][B] | parser/lease_31_s7/I1
28.571 | 0.327 | tINS | FR | 31 | R32C37[0][B] | parser/lease_31_s7/F
29.142 | 0.571 | tNET | RR | 1 | R33C35[0][A] | parser/lease_12_s1/CE

Data Required Path:

AT | DELAY | TYPE | RF | FANOUT | LOC | NODE
31.251 | 31.251 | | | | | active clock edge time
31.251 | 0.000 | | | | | usb_core_phase
31.251 | 0.000 | tCL | RR | 886 | PLL_R[0] | usb_pll/CLKOUTP
33.522 | 2.271 | tNET | RR | 1 | R33C35[0][A] | parser/lease_12_s1/CLK
33.487 | -0.035 | tSu | | 1 | R33C35[0][A] | parser/lease_12_s1

Path Statistics:

Clock Skew | 0.000
Setup Relationship | 16.667
Logic Level | 9
Arrival Clock Path Delay | cell: 0.000, 0.000%; route: 2.271, 100.000%
Arrival Data Path Delay | cell: 3.245, 26.407%; route: 6.782, 55.200%; tC2Q: 2.260, 18.393%
Required Clock Path Delay | cell: 0.000, 0.000%; route: 2.271, 100.000%

### Path20

Path Summary:

Slack | 4.362
Data Arrival Time | 29.125
Data Required Time | 33.487
From | host/host_0/packet_packet_0_0_s
To | parser/pinch_3_s1
Launch Clk | usb_core_phase:[R]
Latch Clk | usb_core_phase:[R]

Data Arrival Path:

AT | DELAY | TYPE | RF | FANOUT | LOC | NODE
14.584 | 14.584 | | | | | active clock edge time
14.584 | 0.000 | | | | | usb_core_phase
14.584 | 0.000 | tCL | RR | 886 | PLL_R[0] | usb_pll/CLKOUTP
16.855 | 2.271 | tNET | RR | 8 | BSRAM_R28[8] | host/host_0/packet_packet_0_0_s/CLKB
19.115 | 2.260 | tC2Q | RF | 13 | BSRAM_R28[8] | host/host_0/packet_packet_0_0_s/DO[2]
21.305 | 2.190 | tNET | FF | 2 | R34C35[1][B] | parser/n487_s0/I0
21.854 | 0.549 | tINS | FR | 1 | R34C35[1][B] | parser/n487_s0/COUT
21.854 | 0.000 | tNET | RR | 2 | R34C35[2][A] | parser/n488_s0/CIN
21.889 | 0.035 | tINS | RF | 1 | R34C35[2][A] | parser/n488_s0/COUT
21.889 | 0.000 | tNET | FF | 2 | R34C35[2][B] | parser/n489_s0/CIN
21.924 | 0.035 | tINS | FF | 1 | R34C35[2][B] | parser/n489_s0/COUT
21.924 | 0.000 | tNET | FF | 2 | R34C36[0][A] | parser/n490_s0/CIN
21.959 | 0.035 | tINS | FF | 1 | R34C36[0][A] | parser/n490_s0/COUT
21.959 | 0.000 | tNET | FF | 2 | R34C36[0][B] | parser/n491_s0/CIN
21.994 | 0.035 | tINS | FF | 1 | R34C36[0][B] | parser/n491_s0/COUT
21.994 | 0.000 | tNET | FF | 2 | R34C36[1][A] | parser/n492_s0/CIN
22.030 | 0.035 | tINS | FF | 1 | R34C36[1][A] | parser/n492_s0/COUT
22.030 | 0.000 | tNET | FF | 2 | R34C36[1][B] | parser/n493_s0/CIN
22.065 | 0.035 | tINS | FF | 1 | R34C36[1][B] | parser/n493_s0/COUT
22.065 | 0.000 | tNET | FF | 2 | R34C36[2][A] | parser/n494_s0/CIN
22.100 | 0.035 | tINS | FF | 1 | R34C36[2][A] | parser/n494_s0/COUT
22.100 | 0.000 | tNET | FF | 2 | R34C36[2][B] | parser/n495_s0/CIN
22.135 | 0.035 | tINS | FF | 1 | R34C36[2][B] | parser/n495_s0/COUT
22.135 | 0.000 | tNET | FF | 2 | R34C37[0][A] | parser/n496_s0/CIN
22.170 | 0.035 | tINS | FF | 1 | R34C37[0][A] | parser/n496_s0/COUT
22.170 | 0.000 | tNET | FF | 2 | R34C37[0][B] | parser/n497_s0/CIN
22.206 | 0.035 | tINS | FF | 1 | R34C37[0][B] | parser/n497_s0/COUT
22.206 | 0.000 | tNET | FF | 2 | R34C37[1][A] | parser/n498_s0/CIN
22.241 | 0.035 | tINS | FF | 1 | R34C37[1][A] | parser/n498_s0/COUT
22.241 | 0.000 | tNET | FF | 2 | R34C37[1][B] | parser/n499_s0/CIN
22.276 | 0.035 | tINS | FF | 1 | R34C37[1][B] | parser/n499_s0/COUT
22.276 | 0.000 | tNET | FF | 2 | R34C37[2][A] | parser/n500_s0/CIN
22.311 | 0.035 | tINS | FF | 1 | R34C37[2][A] | parser/n500_s0/COUT
23.465 | 1.154 | tNET | FF | 1 | R29C35[2][B] | parser/n626_s17/I3
24.035 | 0.570 | tINS | FR | 1 | R29C35[2][B] | parser/n626_s17/F
24.208 | 0.172 | tNET | RR | 1 | R29C36[3][B] | parser/n626_s9/I2
24.661 | 0.453 | tINS | RF | 1 | R29C36[3][B] | parser/n626_s9/F
25.058 | 0.397 | tNET | FF | 1 | R27C36[0][A] | parser/n626_s5/I2
25.429 | 0.371 | tINS | FF | 2 | R27C36[0][A] | parser/n626_s5/F
26.122 | 0.693 | tNET | FF | 1 | R30C37[0][B] | parser/n152_s3/I3
26.639 | 0.517 | tINS | FF | 72 | R30C37[0][B] | parser/n152_s3/F
28.273 | 1.634 | tNET | FF | 1 | R25C40[3][A] | parser/have_seq_s3/I0
28.600 | 0.327 | tINS | FR | 30 | R25C40[3][A] | parser/have_seq_s3/F
29.125 | 0.525 | tNET | RR | 1 | R24C39[0][A] | parser/pinch_3_s1/CE

Data Required Path:

AT | DELAY | TYPE | RF | FANOUT | LOC | NODE
31.251 | 31.251 | | | | | active clock edge time
31.251 | 0.000 | | | | | usb_core_phase
31.251 | 0.000 | tCL | RR | 886 | PLL_R[0] | usb_pll/CLKOUTP
33.522 | 2.271 | tNET | RR | 1 | R24C39[0][A] | parser/pinch_3_s1/CLK
33.487 | -0.035 | tSu | | 1 | R24C39[0][A] | parser/pinch_3_s1

Path Statistics:

Clock Skew | 0.000
Setup Relationship | 16.667
Logic Level | 9
Arrival Clock Path Delay | cell: 0.000, 0.000%; route: 2.271, 100.000%
Arrival Data Path Delay | cell: 3.245, 26.444%; route: 6.765, 55.137%; tC2Q: 2.260, 18.419%
Required Clock Path Delay | cell: 0.000, 0.000%; route: 2.271, 100.000%

### Path21

Path Summary:

Slack | 4.362
Data Arrival Time | 29.125
Data Required Time | 33.487
From | host/host_0/packet_packet_0_0_s
To | parser/pinch_4_s1
Launch Clk | usb_core_phase:[R]
Latch Clk | usb_core_phase:[R]

Data Arrival Path:

AT | DELAY | TYPE | RF | FANOUT | LOC | NODE
14.584 | 14.584 | | | | | active clock edge time
14.584 | 0.000 | | | | | usb_core_phase
14.584 | 0.000 | tCL | RR | 886 | PLL_R[0] | usb_pll/CLKOUTP
16.855 | 2.271 | tNET | RR | 8 | BSRAM_R28[8] | host/host_0/packet_packet_0_0_s/CLKB
19.115 | 2.260 | tC2Q | RF | 13 | BSRAM_R28[8] | host/host_0/packet_packet_0_0_s/DO[2]
21.305 | 2.190 | tNET | FF | 2 | R34C35[1][B] | parser/n487_s0/I0
21.854 | 0.549 | tINS | FR | 1 | R34C35[1][B] | parser/n487_s0/COUT
21.854 | 0.000 | tNET | RR | 2 | R34C35[2][A] | parser/n488_s0/CIN
21.889 | 0.035 | tINS | RF | 1 | R34C35[2][A] | parser/n488_s0/COUT
21.889 | 0.000 | tNET | FF | 2 | R34C35[2][B] | parser/n489_s0/CIN
21.924 | 0.035 | tINS | FF | 1 | R34C35[2][B] | parser/n489_s0/COUT
21.924 | 0.000 | tNET | FF | 2 | R34C36[0][A] | parser/n490_s0/CIN
21.959 | 0.035 | tINS | FF | 1 | R34C36[0][A] | parser/n490_s0/COUT
21.959 | 0.000 | tNET | FF | 2 | R34C36[0][B] | parser/n491_s0/CIN
21.994 | 0.035 | tINS | FF | 1 | R34C36[0][B] | parser/n491_s0/COUT
21.994 | 0.000 | tNET | FF | 2 | R34C36[1][A] | parser/n492_s0/CIN
22.030 | 0.035 | tINS | FF | 1 | R34C36[1][A] | parser/n492_s0/COUT
22.030 | 0.000 | tNET | FF | 2 | R34C36[1][B] | parser/n493_s0/CIN
22.065 | 0.035 | tINS | FF | 1 | R34C36[1][B] | parser/n493_s0/COUT
22.065 | 0.000 | tNET | FF | 2 | R34C36[2][A] | parser/n494_s0/CIN
22.100 | 0.035 | tINS | FF | 1 | R34C36[2][A] | parser/n494_s0/COUT
22.100 | 0.000 | tNET | FF | 2 | R34C36[2][B] | parser/n495_s0/CIN
22.135 | 0.035 | tINS | FF | 1 | R34C36[2][B] | parser/n495_s0/COUT
22.135 | 0.000 | tNET | FF | 2 | R34C37[0][A] | parser/n496_s0/CIN
22.170 | 0.035 | tINS | FF | 1 | R34C37[0][A] | parser/n496_s0/COUT
22.170 | 0.000 | tNET | FF | 2 | R34C37[0][B] | parser/n497_s0/CIN
22.206 | 0.035 | tINS | FF | 1 | R34C37[0][B] | parser/n497_s0/COUT
22.206 | 0.000 | tNET | FF | 2 | R34C37[1][A] | parser/n498_s0/CIN
22.241 | 0.035 | tINS | FF | 1 | R34C37[1][A] | parser/n498_s0/COUT
22.241 | 0.000 | tNET | FF | 2 | R34C37[1][B] | parser/n499_s0/CIN
22.276 | 0.035 | tINS | FF | 1 | R34C37[1][B] | parser/n499_s0/COUT
22.276 | 0.000 | tNET | FF | 2 | R34C37[2][A] | parser/n500_s0/CIN
22.311 | 0.035 | tINS | FF | 1 | R34C37[2][A] | parser/n500_s0/COUT
23.465 | 1.154 | tNET | FF | 1 | R29C35[2][B] | parser/n626_s17/I3
24.035 | 0.570 | tINS | FR | 1 | R29C35[2][B] | parser/n626_s17/F
24.208 | 0.172 | tNET | RR | 1 | R29C36[3][B] | parser/n626_s9/I2
24.661 | 0.453 | tINS | RF | 1 | R29C36[3][B] | parser/n626_s9/F
25.058 | 0.397 | tNET | FF | 1 | R27C36[0][A] | parser/n626_s5/I2
25.429 | 0.371 | tINS | FF | 2 | R27C36[0][A] | parser/n626_s5/F
26.122 | 0.693 | tNET | FF | 1 | R30C37[0][B] | parser/n152_s3/I3
26.639 | 0.517 | tINS | FF | 72 | R30C37[0][B] | parser/n152_s3/F
28.273 | 1.634 | tNET | FF | 1 | R25C40[3][A] | parser/have_seq_s3/I0
28.600 | 0.327 | tINS | FR | 30 | R25C40[3][A] | parser/have_seq_s3/F
29.125 | 0.525 | tNET | RR | 1 | R24C39[0][B] | parser/pinch_4_s1/CE

Data Required Path:

AT | DELAY | TYPE | RF | FANOUT | LOC | NODE
31.251 | 31.251 | | | | | active clock edge time
31.251 | 0.000 | | | | | usb_core_phase
31.251 | 0.000 | tCL | RR | 886 | PLL_R[0] | usb_pll/CLKOUTP
33.522 | 2.271 | tNET | RR | 1 | R24C39[0][B] | parser/pinch_4_s1/CLK
33.487 | -0.035 | tSu | | 1 | R24C39[0][B] | parser/pinch_4_s1

Path Statistics:

Clock Skew | 0.000
Setup Relationship | 16.667
Logic Level | 9
Arrival Clock Path Delay | cell: 0.000, 0.000%; route: 2.271, 100.000%
Arrival Data Path Delay | cell: 3.245, 26.444%; route: 6.765, 55.137%; tC2Q: 2.260, 18.419%
Required Clock Path Delay | cell: 0.000, 0.000%; route: 2.271, 100.000%

### Path22

Path Summary:

Slack | 4.362
Data Arrival Time | 29.125
Data Required Time | 33.487
From | host/host_0/packet_packet_0_0_s
To | parser/pinch_5_s1
Launch Clk | usb_core_phase:[R]
Latch Clk | usb_core_phase:[R]

Data Arrival Path:

AT | DELAY | TYPE | RF | FANOUT | LOC | NODE
14.584 | 14.584 | | | | | active clock edge time
14.584 | 0.000 | | | | | usb_core_phase
14.584 | 0.000 | tCL | RR | 886 | PLL_R[0] | usb_pll/CLKOUTP
16.855 | 2.271 | tNET | RR | 8 | BSRAM_R28[8] | host/host_0/packet_packet_0_0_s/CLKB
19.115 | 2.260 | tC2Q | RF | 13 | BSRAM_R28[8] | host/host_0/packet_packet_0_0_s/DO[2]
21.305 | 2.190 | tNET | FF | 2 | R34C35[1][B] | parser/n487_s0/I0
21.854 | 0.549 | tINS | FR | 1 | R34C35[1][B] | parser/n487_s0/COUT
21.854 | 0.000 | tNET | RR | 2 | R34C35[2][A] | parser/n488_s0/CIN
21.889 | 0.035 | tINS | RF | 1 | R34C35[2][A] | parser/n488_s0/COUT
21.889 | 0.000 | tNET | FF | 2 | R34C35[2][B] | parser/n489_s0/CIN
21.924 | 0.035 | tINS | FF | 1 | R34C35[2][B] | parser/n489_s0/COUT
21.924 | 0.000 | tNET | FF | 2 | R34C36[0][A] | parser/n490_s0/CIN
21.959 | 0.035 | tINS | FF | 1 | R34C36[0][A] | parser/n490_s0/COUT
21.959 | 0.000 | tNET | FF | 2 | R34C36[0][B] | parser/n491_s0/CIN
21.994 | 0.035 | tINS | FF | 1 | R34C36[0][B] | parser/n491_s0/COUT
21.994 | 0.000 | tNET | FF | 2 | R34C36[1][A] | parser/n492_s0/CIN
22.030 | 0.035 | tINS | FF | 1 | R34C36[1][A] | parser/n492_s0/COUT
22.030 | 0.000 | tNET | FF | 2 | R34C36[1][B] | parser/n493_s0/CIN
22.065 | 0.035 | tINS | FF | 1 | R34C36[1][B] | parser/n493_s0/COUT
22.065 | 0.000 | tNET | FF | 2 | R34C36[2][A] | parser/n494_s0/CIN
22.100 | 0.035 | tINS | FF | 1 | R34C36[2][A] | parser/n494_s0/COUT
22.100 | 0.000 | tNET | FF | 2 | R34C36[2][B] | parser/n495_s0/CIN
22.135 | 0.035 | tINS | FF | 1 | R34C36[2][B] | parser/n495_s0/COUT
22.135 | 0.000 | tNET | FF | 2 | R34C37[0][A] | parser/n496_s0/CIN
22.170 | 0.035 | tINS | FF | 1 | R34C37[0][A] | parser/n496_s0/COUT
22.170 | 0.000 | tNET | FF | 2 | R34C37[0][B] | parser/n497_s0/CIN
22.206 | 0.035 | tINS | FF | 1 | R34C37[0][B] | parser/n497_s0/COUT
22.206 | 0.000 | tNET | FF | 2 | R34C37[1][A] | parser/n498_s0/CIN
22.241 | 0.035 | tINS | FF | 1 | R34C37[1][A] | parser/n498_s0/COUT
22.241 | 0.000 | tNET | FF | 2 | R34C37[1][B] | parser/n499_s0/CIN
22.276 | 0.035 | tINS | FF | 1 | R34C37[1][B] | parser/n499_s0/COUT
22.276 | 0.000 | tNET | FF | 2 | R34C37[2][A] | parser/n500_s0/CIN
22.311 | 0.035 | tINS | FF | 1 | R34C37[2][A] | parser/n500_s0/COUT
23.465 | 1.154 | tNET | FF | 1 | R29C35[2][B] | parser/n626_s17/I3
24.035 | 0.570 | tINS | FR | 1 | R29C35[2][B] | parser/n626_s17/F
24.208 | 0.172 | tNET | RR | 1 | R29C36[3][B] | parser/n626_s9/I2
24.661 | 0.453 | tINS | RF | 1 | R29C36[3][B] | parser/n626_s9/F
25.058 | 0.397 | tNET | FF | 1 | R27C36[0][A] | parser/n626_s5/I2
25.429 | 0.371 | tINS | FF | 2 | R27C36[0][A] | parser/n626_s5/F
26.122 | 0.693 | tNET | FF | 1 | R30C37[0][B] | parser/n152_s3/I3
26.639 | 0.517 | tINS | FF | 72 | R30C37[0][B] | parser/n152_s3/F
28.273 | 1.634 | tNET | FF | 1 | R25C40[3][A] | parser/have_seq_s3/I0
28.600 | 0.327 | tINS | FR | 30 | R25C40[3][A] | parser/have_seq_s3/F
29.125 | 0.525 | tNET | RR | 1 | R24C39[1][A] | parser/pinch_5_s1/CE

Data Required Path:

AT | DELAY | TYPE | RF | FANOUT | LOC | NODE
31.251 | 31.251 | | | | | active clock edge time
31.251 | 0.000 | | | | | usb_core_phase
31.251 | 0.000 | tCL | RR | 886 | PLL_R[0] | usb_pll/CLKOUTP
33.522 | 2.271 | tNET | RR | 1 | R24C39[1][A] | parser/pinch_5_s1/CLK
33.487 | -0.035 | tSu | | 1 | R24C39[1][A] | parser/pinch_5_s1

Path Statistics:

Clock Skew | 0.000
Setup Relationship | 16.667
Logic Level | 9
Arrival Clock Path Delay | cell: 0.000, 0.000%; route: 2.271, 100.000%
Arrival Data Path Delay | cell: 3.245, 26.444%; route: 6.765, 55.137%; tC2Q: 2.260, 18.419%
Required Clock Path Delay | cell: 0.000, 0.000%; route: 2.271, 100.000%

### Path23

Path Summary:

Slack | 4.368
Data Arrival Time | 29.119
Data Required Time | 33.487
From | host/host_0/packet_packet_0_0_s
To | parser/pinch_6_s1
Launch Clk | usb_core_phase:[R]
Latch Clk | usb_core_phase:[R]

Data Arrival Path:

AT | DELAY | TYPE | RF | FANOUT | LOC | NODE
14.584 | 14.584 | | | | | active clock edge time
14.584 | 0.000 | | | | | usb_core_phase
14.584 | 0.000 | tCL | RR | 886 | PLL_R[0] | usb_pll/CLKOUTP
16.855 | 2.271 | tNET | RR | 8 | BSRAM_R28[8] | host/host_0/packet_packet_0_0_s/CLKB
19.115 | 2.260 | tC2Q | RF | 13 | BSRAM_R28[8] | host/host_0/packet_packet_0_0_s/DO[2]
21.305 | 2.190 | tNET | FF | 2 | R34C35[1][B] | parser/n487_s0/I0
21.854 | 0.549 | tINS | FR | 1 | R34C35[1][B] | parser/n487_s0/COUT
21.854 | 0.000 | tNET | RR | 2 | R34C35[2][A] | parser/n488_s0/CIN
21.889 | 0.035 | tINS | RF | 1 | R34C35[2][A] | parser/n488_s0/COUT
21.889 | 0.000 | tNET | FF | 2 | R34C35[2][B] | parser/n489_s0/CIN
21.924 | 0.035 | tINS | FF | 1 | R34C35[2][B] | parser/n489_s0/COUT
21.924 | 0.000 | tNET | FF | 2 | R34C36[0][A] | parser/n490_s0/CIN
21.959 | 0.035 | tINS | FF | 1 | R34C36[0][A] | parser/n490_s0/COUT
21.959 | 0.000 | tNET | FF | 2 | R34C36[0][B] | parser/n491_s0/CIN
21.994 | 0.035 | tINS | FF | 1 | R34C36[0][B] | parser/n491_s0/COUT
21.994 | 0.000 | tNET | FF | 2 | R34C36[1][A] | parser/n492_s0/CIN
22.030 | 0.035 | tINS | FF | 1 | R34C36[1][A] | parser/n492_s0/COUT
22.030 | 0.000 | tNET | FF | 2 | R34C36[1][B] | parser/n493_s0/CIN
22.065 | 0.035 | tINS | FF | 1 | R34C36[1][B] | parser/n493_s0/COUT
22.065 | 0.000 | tNET | FF | 2 | R34C36[2][A] | parser/n494_s0/CIN
22.100 | 0.035 | tINS | FF | 1 | R34C36[2][A] | parser/n494_s0/COUT
22.100 | 0.000 | tNET | FF | 2 | R34C36[2][B] | parser/n495_s0/CIN
22.135 | 0.035 | tINS | FF | 1 | R34C36[2][B] | parser/n495_s0/COUT
22.135 | 0.000 | tNET | FF | 2 | R34C37[0][A] | parser/n496_s0/CIN
22.170 | 0.035 | tINS | FF | 1 | R34C37[0][A] | parser/n496_s0/COUT
22.170 | 0.000 | tNET | FF | 2 | R34C37[0][B] | parser/n497_s0/CIN
22.206 | 0.035 | tINS | FF | 1 | R34C37[0][B] | parser/n497_s0/COUT
22.206 | 0.000 | tNET | FF | 2 | R34C37[1][A] | parser/n498_s0/CIN
22.241 | 0.035 | tINS | FF | 1 | R34C37[1][A] | parser/n498_s0/COUT
22.241 | 0.000 | tNET | FF | 2 | R34C37[1][B] | parser/n499_s0/CIN
22.276 | 0.035 | tINS | FF | 1 | R34C37[1][B] | parser/n499_s0/COUT
22.276 | 0.000 | tNET | FF | 2 | R34C37[2][A] | parser/n500_s0/CIN
22.311 | 0.035 | tINS | FF | 1 | R34C37[2][A] | parser/n500_s0/COUT
23.465 | 1.154 | tNET | FF | 1 | R29C35[2][B] | parser/n626_s17/I3
24.035 | 0.570 | tINS | FR | 1 | R29C35[2][B] | parser/n626_s17/F
24.208 | 0.172 | tNET | RR | 1 | R29C36[3][B] | parser/n626_s9/I2
24.661 | 0.453 | tINS | RF | 1 | R29C36[3][B] | parser/n626_s9/F
25.058 | 0.397 | tNET | FF | 1 | R27C36[0][A] | parser/n626_s5/I2
25.429 | 0.371 | tINS | FF | 2 | R27C36[0][A] | parser/n626_s5/F
26.122 | 0.693 | tNET | FF | 1 | R30C37[0][B] | parser/n152_s3/I3
26.639 | 0.517 | tINS | FF | 72 | R30C37[0][B] | parser/n152_s3/F
28.273 | 1.634 | tNET | FF | 1 | R25C40[3][A] | parser/have_seq_s3/I0
28.600 | 0.327 | tINS | FR | 30 | R25C40[3][A] | parser/have_seq_s3/F
29.119 | 0.519 | tNET | RR | 1 | R27C38[0][A] | parser/pinch_6_s1/CE

Data Required Path:

AT | DELAY | TYPE | RF | FANOUT | LOC | NODE
31.251 | 31.251 | | | | | active clock edge time
31.251 | 0.000 | | | | | usb_core_phase
31.251 | 0.000 | tCL | RR | 886 | PLL_R[0] | usb_pll/CLKOUTP
33.522 | 2.271 | tNET | RR | 1 | R27C38[0][A] | parser/pinch_6_s1/CLK
33.487 | -0.035 | tSu | | 1 | R27C38[0][A] | parser/pinch_6_s1

Path Statistics:

Clock Skew | 0.000
Setup Relationship | 16.667
Logic Level | 9
Arrival Clock Path Delay | cell: 0.000, 0.000%; route: 2.271, 100.000%
Arrival Data Path Delay | cell: 3.245, 26.457%; route: 6.759, 55.115%; tC2Q: 2.260, 18.428%
Required Clock Path Delay | cell: 0.000, 0.000%; route: 2.271, 100.000%

### Path24

Path Summary:

Slack | 4.506
Data Arrival Time | 28.981
Data Required Time | 33.487
From | host/host_0/packet_packet_0_0_s
To | parser/lease_2_s1
Launch Clk | usb_core_phase:[R]
Latch Clk | usb_core_phase:[R]

Data Arrival Path:

AT | DELAY | TYPE | RF | FANOUT | LOC | NODE
14.584 | 14.584 | | | | | active clock edge time
14.584 | 0.000 | | | | | usb_core_phase
14.584 | 0.000 | tCL | RR | 886 | PLL_R[0] | usb_pll/CLKOUTP
16.855 | 2.271 | tNET | RR | 8 | BSRAM_R28[8] | host/host_0/packet_packet_0_0_s/CLKB
19.115 | 2.260 | tC2Q | RF | 13 | BSRAM_R28[8] | host/host_0/packet_packet_0_0_s/DO[2]
21.305 | 2.190 | tNET | FF | 2 | R34C35[1][B] | parser/n487_s0/I0
21.854 | 0.549 | tINS | FR | 1 | R34C35[1][B] | parser/n487_s0/COUT
21.854 | 0.000 | tNET | RR | 2 | R34C35[2][A] | parser/n488_s0/CIN
21.889 | 0.035 | tINS | RF | 1 | R34C35[2][A] | parser/n488_s0/COUT
21.889 | 0.000 | tNET | FF | 2 | R34C35[2][B] | parser/n489_s0/CIN
21.924 | 0.035 | tINS | FF | 1 | R34C35[2][B] | parser/n489_s0/COUT
21.924 | 0.000 | tNET | FF | 2 | R34C36[0][A] | parser/n490_s0/CIN
21.959 | 0.035 | tINS | FF | 1 | R34C36[0][A] | parser/n490_s0/COUT
21.959 | 0.000 | tNET | FF | 2 | R34C36[0][B] | parser/n491_s0/CIN
21.994 | 0.035 | tINS | FF | 1 | R34C36[0][B] | parser/n491_s0/COUT
21.994 | 0.000 | tNET | FF | 2 | R34C36[1][A] | parser/n492_s0/CIN
22.030 | 0.035 | tINS | FF | 1 | R34C36[1][A] | parser/n492_s0/COUT
22.030 | 0.000 | tNET | FF | 2 | R34C36[1][B] | parser/n493_s0/CIN
22.065 | 0.035 | tINS | FF | 1 | R34C36[1][B] | parser/n493_s0/COUT
22.065 | 0.000 | tNET | FF | 2 | R34C36[2][A] | parser/n494_s0/CIN
22.100 | 0.035 | tINS | FF | 1 | R34C36[2][A] | parser/n494_s0/COUT
22.100 | 0.000 | tNET | FF | 2 | R34C36[2][B] | parser/n495_s0/CIN
22.135 | 0.035 | tINS | FF | 1 | R34C36[2][B] | parser/n495_s0/COUT
22.135 | 0.000 | tNET | FF | 2 | R34C37[0][A] | parser/n496_s0/CIN
22.170 | 0.035 | tINS | FF | 1 | R34C37[0][A] | parser/n496_s0/COUT
22.170 | 0.000 | tNET | FF | 2 | R34C37[0][B] | parser/n497_s0/CIN
22.206 | 0.035 | tINS | FF | 1 | R34C37[0][B] | parser/n497_s0/COUT
22.206 | 0.000 | tNET | FF | 2 | R34C37[1][A] | parser/n498_s0/CIN
22.241 | 0.035 | tINS | FF | 1 | R34C37[1][A] | parser/n498_s0/COUT
22.241 | 0.000 | tNET | FF | 2 | R34C37[1][B] | parser/n499_s0/CIN
22.276 | 0.035 | tINS | FF | 1 | R34C37[1][B] | parser/n499_s0/COUT
22.276 | 0.000 | tNET | FF | 2 | R34C37[2][A] | parser/n500_s0/CIN
22.311 | 0.035 | tINS | FF | 1 | R34C37[2][A] | parser/n500_s0/COUT
23.465 | 1.154 | tNET | FF | 1 | R29C35[2][B] | parser/n626_s17/I3
24.035 | 0.570 | tINS | FR | 1 | R29C35[2][B] | parser/n626_s17/F
24.208 | 0.172 | tNET | RR | 1 | R29C36[3][B] | parser/n626_s9/I2
24.661 | 0.453 | tINS | RF | 1 | R29C36[3][B] | parser/n626_s9/F
25.058 | 0.397 | tNET | FF | 1 | R27C36[0][A] | parser/n626_s5/I2
25.429 | 0.371 | tINS | FF | 2 | R27C36[0][A] | parser/n626_s5/F
26.122 | 0.693 | tNET | FF | 1 | R30C37[0][B] | parser/n152_s3/I3
26.639 | 0.517 | tINS | FF | 72 | R30C37[0][B] | parser/n152_s3/F
28.411 | 1.772 | tNET | FF | 1 | R31C37[1][A] | parser/n150_s1/I2
28.981 | 0.570 | tINS | FR | 1 | R31C37[1][A] | parser/n150_s1/F
28.981 | 0.000 | tNET | RR | 1 | R31C37[1][A] | parser/lease_2_s1/D

Data Required Path:

AT | DELAY | TYPE | RF | FANOUT | LOC | NODE
31.251 | 31.251 | | | | | active clock edge time
31.251 | 0.000 | | | | | usb_core_phase
31.251 | 0.000 | tCL | RR | 886 | PLL_R[0] | usb_pll/CLKOUTP
33.522 | 2.271 | tNET | RR | 1 | R31C37[1][A] | parser/lease_2_s1/CLK
33.487 | -0.035 | tSu | | 1 | R31C37[1][A] | parser/lease_2_s1

Path Statistics:

Clock Skew | 0.000
Setup Relationship | 16.667
Logic Level | 9
Arrival Clock Path Delay | cell: 0.000, 0.000%; route: 2.271, 100.000%
Arrival Data Path Delay | cell: 3.488, 28.761%; route: 6.378, 52.601%; tC2Q: 2.260, 18.638%
Required Clock Path Delay | cell: 0.000, 0.000%; route: 2.271, 100.000%

### Path25

Path Summary:

Slack | 4.515
Data Arrival Time | 28.972
Data Required Time | 33.487
From | host/host_0/packet_packet_0_0_s
To | parser/lease_15_s1
Launch Clk | usb_core_phase:[R]
Latch Clk | usb_core_phase:[R]

Data Arrival Path:

AT | DELAY | TYPE | RF | FANOUT | LOC | NODE
14.584 | 14.584 | | | | | active clock edge time
14.584 | 0.000 | | | | | usb_core_phase
14.584 | 0.000 | tCL | RR | 886 | PLL_R[0] | usb_pll/CLKOUTP
16.855 | 2.271 | tNET | RR | 8 | BSRAM_R28[8] | host/host_0/packet_packet_0_0_s/CLKB
19.115 | 2.260 | tC2Q | RF | 13 | BSRAM_R28[8] | host/host_0/packet_packet_0_0_s/DO[2]
21.305 | 2.190 | tNET | FF | 2 | R34C35[1][B] | parser/n487_s0/I0
21.854 | 0.549 | tINS | FR | 1 | R34C35[1][B] | parser/n487_s0/COUT
21.854 | 0.000 | tNET | RR | 2 | R34C35[2][A] | parser/n488_s0/CIN
21.889 | 0.035 | tINS | RF | 1 | R34C35[2][A] | parser/n488_s0/COUT
21.889 | 0.000 | tNET | FF | 2 | R34C35[2][B] | parser/n489_s0/CIN
21.924 | 0.035 | tINS | FF | 1 | R34C35[2][B] | parser/n489_s0/COUT
21.924 | 0.000 | tNET | FF | 2 | R34C36[0][A] | parser/n490_s0/CIN
21.959 | 0.035 | tINS | FF | 1 | R34C36[0][A] | parser/n490_s0/COUT
21.959 | 0.000 | tNET | FF | 2 | R34C36[0][B] | parser/n491_s0/CIN
21.994 | 0.035 | tINS | FF | 1 | R34C36[0][B] | parser/n491_s0/COUT
21.994 | 0.000 | tNET | FF | 2 | R34C36[1][A] | parser/n492_s0/CIN
22.030 | 0.035 | tINS | FF | 1 | R34C36[1][A] | parser/n492_s0/COUT
22.030 | 0.000 | tNET | FF | 2 | R34C36[1][B] | parser/n493_s0/CIN
22.065 | 0.035 | tINS | FF | 1 | R34C36[1][B] | parser/n493_s0/COUT
22.065 | 0.000 | tNET | FF | 2 | R34C36[2][A] | parser/n494_s0/CIN
22.100 | 0.035 | tINS | FF | 1 | R34C36[2][A] | parser/n494_s0/COUT
22.100 | 0.000 | tNET | FF | 2 | R34C36[2][B] | parser/n495_s0/CIN
22.135 | 0.035 | tINS | FF | 1 | R34C36[2][B] | parser/n495_s0/COUT
22.135 | 0.000 | tNET | FF | 2 | R34C37[0][A] | parser/n496_s0/CIN
22.170 | 0.035 | tINS | FF | 1 | R34C37[0][A] | parser/n496_s0/COUT
22.170 | 0.000 | tNET | FF | 2 | R34C37[0][B] | parser/n497_s0/CIN
22.206 | 0.035 | tINS | FF | 1 | R34C37[0][B] | parser/n497_s0/COUT
22.206 | 0.000 | tNET | FF | 2 | R34C37[1][A] | parser/n498_s0/CIN
22.241 | 0.035 | tINS | FF | 1 | R34C37[1][A] | parser/n498_s0/COUT
22.241 | 0.000 | tNET | FF | 2 | R34C37[1][B] | parser/n499_s0/CIN
22.276 | 0.035 | tINS | FF | 1 | R34C37[1][B] | parser/n499_s0/COUT
22.276 | 0.000 | tNET | FF | 2 | R34C37[2][A] | parser/n500_s0/CIN
22.311 | 0.035 | tINS | FF | 1 | R34C37[2][A] | parser/n500_s0/COUT
23.465 | 1.154 | tNET | FF | 1 | R29C35[2][B] | parser/n626_s17/I3
24.035 | 0.570 | tINS | FR | 1 | R29C35[2][B] | parser/n626_s17/F
24.208 | 0.172 | tNET | RR | 1 | R29C36[3][B] | parser/n626_s9/I2
24.661 | 0.453 | tINS | RF | 1 | R29C36[3][B] | parser/n626_s9/F
25.058 | 0.397 | tNET | FF | 1 | R27C36[0][A] | parser/n626_s5/I2
25.429 | 0.371 | tINS | FF | 2 | R27C36[0][A] | parser/n626_s5/F
26.122 | 0.693 | tNET | FF | 1 | R30C37[0][B] | parser/n152_s3/I3
26.639 | 0.517 | tINS | FF | 72 | R30C37[0][B] | parser/n152_s3/F
28.402 | 1.763 | tNET | FF | 1 | R31C36[1][A] | parser/n137_s2/I0
28.972 | 0.570 | tINS | FR | 1 | R31C36[1][A] | parser/n137_s2/F
28.972 | 0.000 | tNET | RR | 1 | R31C36[1][A] | parser/lease_15_s1/D

Data Required Path:

AT | DELAY | TYPE | RF | FANOUT | LOC | NODE
31.251 | 31.251 | | | | | active clock edge time
31.251 | 0.000 | | | | | usb_core_phase
31.251 | 0.000 | tCL | RR | 886 | PLL_R[0] | usb_pll/CLKOUTP
33.522 | 2.271 | tNET | RR | 1 | R31C36[1][A] | parser/lease_15_s1/CLK
33.487 | -0.035 | tSu | | 1 | R31C36[1][A] | parser/lease_15_s1

Path Statistics:

Clock Skew | 0.000
Setup Relationship | 16.667
Logic Level | 9
Arrival Clock Path Delay | cell: 0.000, 0.000%; route: 2.271, 100.000%
Arrival Data Path Delay | cell: 3.488, 28.784%; route: 6.369, 52.564%; tC2Q: 2.260, 18.652%
Required Clock Path Delay | cell: 0.000, 0.000%; route: 2.271, 100.000%

### Hold Analysis Report

#### Report Command:report_timing -hold -max_paths 25 -max_common_paths 1

### Path1

Path Summary:

Slack | 0.319
Data Arrival Time | 16.424
Data Required Time | 16.105
From | host/host_0/enum/sie/translator/queue/w_port__addr_1_s5
To | host/host_0/enum/sie/translator/queue/storage_storage_0_1_s
Launch Clk | usb_core_phase:[R]
Latch Clk | usb_core_phase:[R]

Data Arrival Path:

AT | DELAY | TYPE | RF | FANOUT | LOC | NODE
14.584 | 14.584 | | | | | active clock edge time
14.584 | 0.000 | | | | | usb_core_phase
14.584 | 0.000 | tCL | RR | 886 | PLL_R[0] | usb_pll/CLKOUTP
16.095 | 1.511 | tNET | RR | 1 | R33C22[0][B] | host/host_0/enum/sie/translator/queue/w_port__addr_1_s5/CLK
16.297 | 0.202 | tC2Q | RR | 5 | R33C22[0][B] | host/host_0/enum/sie/translator/queue/w_port__addr_1_s5/Q
16.424 | 0.127 | tNET | RR | 1 | R33C21 | host/host_0/enum/sie/translator/queue/storage_storage_0_1_s/WAD[1]

Data Required Path:

AT | DELAY | TYPE | RF | FANOUT | LOC | NODE
14.584 | 14.584 | | | | | active clock edge time
14.584 | 0.000 | | | | | usb_core_phase
14.584 | 0.000 | tCL | RR | 886 | PLL_R[0] | usb_pll/CLKOUTP
16.095 | 1.511 | tNET | RR | 1 | R33C21 | host/host_0/enum/sie/translator/queue/storage_storage_0_1_s/CLK
16.105 | 0.010 | tHld | | 1 | R33C21 | host/host_0/enum/sie/translator/queue/storage_storage_0_1_s

Path Statistics:

Clock Skew | 0.000
Hold Relationship | 0.000
Logic Level | 1
Arrival Clock Path Delay | cell: 0.000, 0.000%; route: 1.511, 100.000%
Arrival Data Path Delay | cell: 0.000, 0.000%; route: 0.127, 38.581%; tC2Q: 0.202, 61.419%
Required Clock Path Delay | cell: 0.000, 0.000%; route: 1.511, 100.000%

### Path2

Path Summary:

Slack | 0.319
Data Arrival Time | 16.424
Data Required Time | 16.105
From | host/host_0/enum/sie/translator/queue/w_port__addr_0_s4
To | host/host_0/enum/sie/translator/queue/storage_storage_0_2_s
Launch Clk | usb_core_phase:[R]
Latch Clk | usb_core_phase:[R]

Data Arrival Path:

AT | DELAY | TYPE | RF | FANOUT | LOC | NODE
14.584 | 14.584 | | | | | active clock edge time
14.584 | 0.000 | | | | | usb_core_phase
14.584 | 0.000 | tCL | RR | 886 | PLL_R[0] | usb_pll/CLKOUTP
16.095 | 1.511 | tNET | RR | 1 | R33C22[0][A] | host/host_0/enum/sie/translator/queue/w_port__addr_0_s4/CLK
16.296 | 0.201 | tC2Q | RF | 5 | R33C22[0][A] | host/host_0/enum/sie/translator/queue/w_port__addr_0_s4/Q
16.424 | 0.128 | tNET | FF | 1 | R32C22 | host/host_0/enum/sie/translator/queue/storage_storage_0_2_s/WAD[0]

Data Required Path:

AT | DELAY | TYPE | RF | FANOUT | LOC | NODE
14.584 | 14.584 | | | | | active clock edge time
14.584 | 0.000 | | | | | usb_core_phase
14.584 | 0.000 | tCL | RR | 886 | PLL_R[0] | usb_pll/CLKOUTP
16.095 | 1.511 | tNET | RR | 1 | R32C22 | host/host_0/enum/sie/translator/queue/storage_storage_0_2_s/CLK
16.105 | 0.010 | tHld | | 1 | R32C22 | host/host_0/enum/sie/translator/queue/storage_storage_0_2_s

Path Statistics:

Clock Skew | 0.000
Hold Relationship | 0.000
Logic Level | 1
Arrival Clock Path Delay | cell: 0.000, 0.000%; route: 1.511, 100.000%
Arrival Data Path Delay | cell: 0.000, 0.000%; route: 0.128, 38.990%; tC2Q: 0.201, 61.010%
Required Clock Path Delay | cell: 0.000, 0.000%; route: 1.511, 100.000%

### Path3

Path Summary:

Slack | 0.328
Data Arrival Time | 16.433
Data Required Time | 16.105
From | host/host_0/enum/sie/translator/queue/w_port__addr_1_s5
To | host/host_0/enum/sie/translator/queue/storage_storage_0_2_s
Launch Clk | usb_core_phase:[R]
Latch Clk | usb_core_phase:[R]

Data Arrival Path:

AT | DELAY | TYPE | RF | FANOUT | LOC | NODE
14.584 | 14.584 | | | | | active clock edge time
14.584 | 0.000 | | | | | usb_core_phase
14.584 | 0.000 | tCL | RR | 886 | PLL_R[0] | usb_pll/CLKOUTP
16.095 | 1.511 | tNET | RR | 1 | R33C22[0][B] | host/host_0/enum/sie/translator/queue/w_port__addr_1_s5/CLK
16.296 | 0.201 | tC2Q | RF | 5 | R33C22[0][B] | host/host_0/enum/sie/translator/queue/w_port__addr_1_s5/Q
16.433 | 0.137 | tNET | FF | 1 | R32C22 | host/host_0/enum/sie/translator/queue/storage_storage_0_2_s/WAD[1]

Data Required Path:

AT | DELAY | TYPE | RF | FANOUT | LOC | NODE
14.584 | 14.584 | | | | | active clock edge time
14.584 | 0.000 | | | | | usb_core_phase
14.584 | 0.000 | tCL | RR | 886 | PLL_R[0] | usb_pll/CLKOUTP
16.095 | 1.511 | tNET | RR | 1 | R32C22 | host/host_0/enum/sie/translator/queue/storage_storage_0_2_s/CLK
16.105 | 0.010 | tHld | | 1 | R32C22 | host/host_0/enum/sie/translator/queue/storage_storage_0_2_s

Path Statistics:

Clock Skew | 0.000
Hold Relationship | 0.000
Logic Level | 1
Arrival Clock Path Delay | cell: 0.000, 0.000%; route: 1.511, 100.000%
Arrival Data Path Delay | cell: 0.000, 0.000%; route: 0.137, 40.594%; tC2Q: 0.201, 59.406%
Required Clock Path Delay | cell: 0.000, 0.000%; route: 1.511, 100.000%

### Path4

Path Summary:

Slack | 0.424
Data Arrival Time | 3.338
Data Required Time | 2.914
From | power_count_2_s0
To | power_count_2_s0
Launch Clk | clk:[R]
Latch Clk | clk:[R]

Data Arrival Path:

AT | DELAY | TYPE | RF | FANOUT | LOC | NODE
0.000 | 0.000 | | | | | active clock edge time
0.000 | 0.000 | | | | | clk
0.000 | 0.000 | tCL | RR | 1 | IOT27[A] | clk_ibuf/I
1.392 | 1.392 | tINS | RR | 20 | IOT27[A] | clk_ibuf/O
2.903 | 1.511 | tNET | RR | 1 | R17C39[1][A] | power_count_2_s0/CLK
3.105 | 0.202 | tC2Q | RR | 1 | R17C39[1][A] | power_count_2_s0/Q
3.106 | 0.001 | tNET | RR | 2 | R17C39[1][A] | n24_s/I1
3.338 | 0.232 | tINS | RF | 1 | R17C39[1][A] | n24_s/SUM
3.338 | 0.000 | tNET | FF | 1 | R17C39[1][A] | power_count_2_s0/D

Data Required Path:

AT | DELAY | TYPE | RF | FANOUT | LOC | NODE
0.000 | 0.000 | | | | | active clock edge time
0.000 | 0.000 | | | | | clk
0.000 | 0.000 | tCL | RR | 1 | IOT27[A] | clk_ibuf/I
1.392 | 1.392 | tINS | RR | 20 | IOT27[A] | clk_ibuf/O
2.903 | 1.511 | tNET | RR | 1 | R17C39[1][A] | power_count_2_s0/CLK
2.914 | 0.011 | tHld | | 1 | R17C39[1][A] | power_count_2_s0

Path Statistics:

Clock Skew | 0.000
Hold Relationship | 0.000
Logic Level | 2
Arrival Clock Path Delay | cell: 1.392, 47.946%; route: 1.511, 52.054%
Arrival Data Path Delay | cell: 0.232, 53.306%; route: 0.001, 0.281%; tC2Q: 0.202, 46.413%
Required Clock Path Delay | cell: 1.392, 47.946%; route: 1.511, 52.054%

### Path5

Path Summary:

Slack | 0.424
Data Arrival Time | 3.338
Data Required Time | 2.914
From | power_count_6_s0
To | power_count_6_s0
Launch Clk | clk:[R]
Latch Clk | clk:[R]

Data Arrival Path:

AT | DELAY | TYPE | RF | FANOUT | LOC | NODE
0.000 | 0.000 | | | | | active clock edge time
0.000 | 0.000 | | | | | clk
0.000 | 0.000 | tCL | RR | 1 | IOT27[A] | clk_ibuf/I
1.392 | 1.392 | tINS | RR | 20 | IOT27[A] | clk_ibuf/O
2.903 | 1.511 | tNET | RR | 1 | R17C40[0][A] | power_count_6_s0/CLK
3.105 | 0.202 | tC2Q | RR | 1 | R17C40[0][A] | power_count_6_s0/Q
3.106 | 0.001 | tNET | RR | 2 | R17C40[0][A] | n20_s/I1
3.338 | 0.232 | tINS | RF | 1 | R17C40[0][A] | n20_s/SUM
3.338 | 0.000 | tNET | FF | 1 | R17C40[0][A] | power_count_6_s0/D

Data Required Path:

AT | DELAY | TYPE | RF | FANOUT | LOC | NODE
0.000 | 0.000 | | | | | active clock edge time
0.000 | 0.000 | | | | | clk
0.000 | 0.000 | tCL | RR | 1 | IOT27[A] | clk_ibuf/I
1.392 | 1.392 | tINS | RR | 20 | IOT27[A] | clk_ibuf/O
2.903 | 1.511 | tNET | RR | 1 | R17C40[0][A] | power_count_6_s0/CLK
2.914 | 0.011 | tHld | | 1 | R17C40[0][A] | power_count_6_s0

Path Statistics:

Clock Skew | 0.000
Hold Relationship | 0.000
Logic Level | 2
Arrival Clock Path Delay | cell: 1.392, 47.946%; route: 1.511, 52.054%
Arrival Data Path Delay | cell: 0.232, 53.306%; route: 0.001, 0.281%; tC2Q: 0.202, 46.413%
Required Clock Path Delay | cell: 1.392, 47.946%; route: 1.511, 52.054%

### Path6

Path Summary:

Slack | 0.424
Data Arrival Time | 3.338
Data Required Time | 2.914
From | power_count_8_s0
To | power_count_8_s0
Launch Clk | clk:[R]
Latch Clk | clk:[R]

Data Arrival Path:

AT | DELAY | TYPE | RF | FANOUT | LOC | NODE
0.000 | 0.000 | | | | | active clock edge time
0.000 | 0.000 | | | | | clk
0.000 | 0.000 | tCL | RR | 1 | IOT27[A] | clk_ibuf/I
1.392 | 1.392 | tINS | RR | 20 | IOT27[A] | clk_ibuf/O
2.903 | 1.511 | tNET | RR | 1 | R17C40[1][A] | power_count_8_s0/CLK
3.105 | 0.202 | tC2Q | RR | 1 | R17C40[1][A] | power_count_8_s0/Q
3.106 | 0.001 | tNET | RR | 2 | R17C40[1][A] | n18_s/I1
3.338 | 0.232 | tINS | RF | 1 | R17C40[1][A] | n18_s/SUM
3.338 | 0.000 | tNET | FF | 1 | R17C40[1][A] | power_count_8_s0/D

Data Required Path:

AT | DELAY | TYPE | RF | FANOUT | LOC | NODE
0.000 | 0.000 | | | | | active clock edge time
0.000 | 0.000 | | | | | clk
0.000 | 0.000 | tCL | RR | 1 | IOT27[A] | clk_ibuf/I
1.392 | 1.392 | tINS | RR | 20 | IOT27[A] | clk_ibuf/O
2.903 | 1.511 | tNET | RR | 1 | R17C40[1][A] | power_count_8_s0/CLK
2.914 | 0.011 | tHld | | 1 | R17C40[1][A] | power_count_8_s0

Path Statistics:

Clock Skew | 0.000
Hold Relationship | 0.000
Logic Level | 2
Arrival Clock Path Delay | cell: 1.392, 47.946%; route: 1.511, 52.054%
Arrival Data Path Delay | cell: 0.232, 53.306%; route: 0.001, 0.281%; tC2Q: 0.202, 46.413%
Required Clock Path Delay | cell: 1.392, 47.946%; route: 1.511, 52.054%

### Path7

Path Summary:

Slack | 0.424
Data Arrival Time | 3.338
Data Required Time | 2.914
From | power_count_12_s0
To | power_count_12_s0
Launch Clk | clk:[R]
Latch Clk | clk:[R]

Data Arrival Path:

AT | DELAY | TYPE | RF | FANOUT | LOC | NODE
0.000 | 0.000 | | | | | active clock edge time
0.000 | 0.000 | | | | | clk
0.000 | 0.000 | tCL | RR | 1 | IOT27[A] | clk_ibuf/I
1.392 | 1.392 | tINS | RR | 20 | IOT27[A] | clk_ibuf/O
2.903 | 1.511 | tNET | RR | 1 | R17C41[0][A] | power_count_12_s0/CLK
3.105 | 0.202 | tC2Q | RR | 1 | R17C41[0][A] | power_count_12_s0/Q
3.106 | 0.001 | tNET | RR | 2 | R17C41[0][A] | n14_s/I1
3.338 | 0.232 | tINS | RF | 1 | R17C41[0][A] | n14_s/SUM
3.338 | 0.000 | tNET | FF | 1 | R17C41[0][A] | power_count_12_s0/D

Data Required Path:

AT | DELAY | TYPE | RF | FANOUT | LOC | NODE
0.000 | 0.000 | | | | | active clock edge time
0.000 | 0.000 | | | | | clk
0.000 | 0.000 | tCL | RR | 1 | IOT27[A] | clk_ibuf/I
1.392 | 1.392 | tINS | RR | 20 | IOT27[A] | clk_ibuf/O
2.903 | 1.511 | tNET | RR | 1 | R17C41[0][A] | power_count_12_s0/CLK
2.914 | 0.011 | tHld | | 1 | R17C41[0][A] | power_count_12_s0

Path Statistics:

Clock Skew | 0.000
Hold Relationship | 0.000
Logic Level | 2
Arrival Clock Path Delay | cell: 1.392, 47.946%; route: 1.511, 52.054%
Arrival Data Path Delay | cell: 0.232, 53.306%; route: 0.001, 0.281%; tC2Q: 0.202, 46.413%
Required Clock Path Delay | cell: 1.392, 47.946%; route: 1.511, 52.054%

### Path8

Path Summary:

Slack | 0.424
Data Arrival Time | 3.338
Data Required Time | 2.914
From | power_count_14_s0
To | power_count_14_s0
Launch Clk | clk:[R]
Latch Clk | clk:[R]

Data Arrival Path:

AT | DELAY | TYPE | RF | FANOUT | LOC | NODE
0.000 | 0.000 | | | | | active clock edge time
0.000 | 0.000 | | | | | clk
0.000 | 0.000 | tCL | RR | 1 | IOT27[A] | clk_ibuf/I
1.392 | 1.392 | tINS | RR | 20 | IOT27[A] | clk_ibuf/O
2.903 | 1.511 | tNET | RR | 1 | R17C41[1][A] | power_count_14_s0/CLK
3.105 | 0.202 | tC2Q | RR | 1 | R17C41[1][A] | power_count_14_s0/Q
3.106 | 0.001 | tNET | RR | 2 | R17C41[1][A] | n12_s/I1
3.338 | 0.232 | tINS | RF | 1 | R17C41[1][A] | n12_s/SUM
3.338 | 0.000 | tNET | FF | 1 | R17C41[1][A] | power_count_14_s0/D

Data Required Path:

AT | DELAY | TYPE | RF | FANOUT | LOC | NODE
0.000 | 0.000 | | | | | active clock edge time
0.000 | 0.000 | | | | | clk
0.000 | 0.000 | tCL | RR | 1 | IOT27[A] | clk_ibuf/I
1.392 | 1.392 | tINS | RR | 20 | IOT27[A] | clk_ibuf/O
2.903 | 1.511 | tNET | RR | 1 | R17C41[1][A] | power_count_14_s0/CLK
2.914 | 0.011 | tHld | | 1 | R17C41[1][A] | power_count_14_s0

Path Statistics:

Clock Skew | 0.000
Hold Relationship | 0.000
Logic Level | 2
Arrival Clock Path Delay | cell: 1.392, 47.946%; route: 1.511, 52.054%
Arrival Data Path Delay | cell: 0.232, 53.306%; route: 0.001, 0.281%; tC2Q: 0.202, 46.413%
Required Clock Path Delay | cell: 1.392, 47.946%; route: 1.511, 52.054%

### Path9

Path Summary:

Slack | 0.424
Data Arrival Time | 3.338
Data Required Time | 2.914
From | power_count_18_s0
To | power_count_18_s0
Launch Clk | clk:[R]
Latch Clk | clk:[R]

Data Arrival Path:

AT | DELAY | TYPE | RF | FANOUT | LOC | NODE
0.000 | 0.000 | | | | | active clock edge time
0.000 | 0.000 | | | | | clk
0.000 | 0.000 | tCL | RR | 1 | IOT27[A] | clk_ibuf/I
1.392 | 1.392 | tINS | RR | 20 | IOT27[A] | clk_ibuf/O
2.903 | 1.511 | tNET | RR | 1 | R17C42[0][A] | power_count_18_s0/CLK
3.105 | 0.202 | tC2Q | RR | 1 | R17C42[0][A] | power_count_18_s0/Q
3.106 | 0.001 | tNET | RR | 2 | R17C42[0][A] | n8_s/I1
3.338 | 0.232 | tINS | RF | 1 | R17C42[0][A] | n8_s/SUM
3.338 | 0.000 | tNET | FF | 1 | R17C42[0][A] | power_count_18_s0/D

Data Required Path:

AT | DELAY | TYPE | RF | FANOUT | LOC | NODE
0.000 | 0.000 | | | | | active clock edge time
0.000 | 0.000 | | | | | clk
0.000 | 0.000 | tCL | RR | 1 | IOT27[A] | clk_ibuf/I
1.392 | 1.392 | tINS | RR | 20 | IOT27[A] | clk_ibuf/O
2.903 | 1.511 | tNET | RR | 1 | R17C42[0][A] | power_count_18_s0/CLK
2.914 | 0.011 | tHld | | 1 | R17C42[0][A] | power_count_18_s0

Path Statistics:

Clock Skew | 0.000
Hold Relationship | 0.000
Logic Level | 2
Arrival Clock Path Delay | cell: 1.392, 47.946%; route: 1.511, 52.054%
Arrival Data Path Delay | cell: 0.232, 53.306%; route: 0.001, 0.281%; tC2Q: 0.202, 46.413%
Required Clock Path Delay | cell: 1.392, 47.946%; route: 1.511, 52.054%

### Path10

Path Summary:

Slack | 0.424
Data Arrival Time | 16.530
Data Required Time | 16.106
From | heartbeat_24_s0
To | heartbeat_24_s0
Launch Clk | usb_core_phase:[R]
Latch Clk | usb_core_phase:[R]

Data Arrival Path:

AT | DELAY | TYPE | RF | FANOUT | LOC | NODE
14.584 | 14.584 | | | | | active clock edge time
14.584 | 0.000 | | | | | usb_core_phase
14.584 | 0.000 | tCL | RR | 886 | PLL_R[0] | usb_pll/CLKOUTP
16.095 | 1.511 | tNET | RR | 1 | R16C42[0][A] | heartbeat_24_s0/CLK
16.297 | 0.202 | tC2Q | RR | 1 | R16C42[0][A] | heartbeat_24_s0/Q
16.298 | 0.001 | tNET | RR | 2 | R16C42[0][A] | n197_s/I1
16.530 | 0.232 | tINS | RF | 1 | R16C42[0][A] | n197_s/SUM
16.530 | 0.000 | tNET | FF | 1 | R16C42[0][A] | heartbeat_24_s0/D

Data Required Path:

AT | DELAY | TYPE | RF | FANOUT | LOC | NODE
14.584 | 14.584 | | | | | active clock edge time
14.584 | 0.000 | | | | | usb_core_phase
14.584 | 0.000 | tCL | RR | 886 | PLL_R[0] | usb_pll/CLKOUTP
16.095 | 1.511 | tNET | RR | 1 | R16C42[0][A] | heartbeat_24_s0/CLK
16.106 | 0.011 | tHld | | 1 | R16C42[0][A] | heartbeat_24_s0

Path Statistics:

Clock Skew | 0.000
Hold Relationship | 0.000
Logic Level | 2
Arrival Clock Path Delay | cell: 0.000, 0.000%; route: 1.511, 100.000%
Arrival Data Path Delay | cell: 0.232, 53.306%; route: 0.001, 0.281%; tC2Q: 0.202, 46.413%
Required Clock Path Delay | cell: 0.000, 0.000%; route: 1.511, 100.000%

### Path11

Path Summary:

Slack | 0.425
Data Arrival Time | 3.340
Data Required Time | 2.914
From | power_count_0_s2
To | power_count_0_s2
Launch Clk | clk:[R]
Latch Clk | clk:[R]

Data Arrival Path:

AT | DELAY | TYPE | RF | FANOUT | LOC | NODE
0.000 | 0.000 | | | | | active clock edge time
0.000 | 0.000 | | | | | clk
0.000 | 0.000 | tCL | RR | 1 | IOT27[A] | clk_ibuf/I
1.392 | 1.392 | tINS | RR | 20 | IOT27[A] | clk_ibuf/O
2.903 | 1.511 | tNET | RR | 1 | R18C40[0][A] | power_count_0_s2/CLK
3.105 | 0.202 | tC2Q | RR | 2 | R18C40[0][A] | power_count_0_s2/Q
3.108 | 0.002 | tNET | RR | 1 | R18C40[0][A] | n26_s3/I0
3.340 | 0.232 | tINS | RF | 1 | R18C40[0][A] | n26_s3/F
3.340 | 0.000 | tNET | FF | 1 | R18C40[0][A] | power_count_0_s2/D

Data Required Path:

AT | DELAY | TYPE | RF | FANOUT | LOC | NODE
0.000 | 0.000 | | | | | active clock edge time
0.000 | 0.000 | | | | | clk
0.000 | 0.000 | tCL | RR | 1 | IOT27[A] | clk_ibuf/I
1.392 | 1.392 | tINS | RR | 20 | IOT27[A] | clk_ibuf/O
2.903 | 1.511 | tNET | RR | 1 | R18C40[0][A] | power_count_0_s2/CLK
2.914 | 0.011 | tHld | | 1 | R18C40[0][A] | power_count_0_s2

Path Statistics:

Clock Skew | 0.000
Hold Relationship | 0.000
Logic Level | 2
Arrival Clock Path Delay | cell: 1.392, 47.946%; route: 1.511, 52.054%
Arrival Data Path Delay | cell: 0.232, 53.157%; route: 0.002, 0.560%; tC2Q: 0.202, 46.283%
Required Clock Path Delay | cell: 1.392, 47.946%; route: 1.511, 52.054%

### Path12

Path Summary:

Slack | 0.425
Data Arrival Time | 16.531
Data Required Time | 16.106
From | diagnostic/tx_count_0_s3
To | diagnostic/tx_count_0_s3
Launch Clk | usb_core_phase:[R]
Latch Clk | usb_core_phase:[R]

Data Arrival Path:

AT | DELAY | TYPE | RF | FANOUT | LOC | NODE
14.584 | 14.584 | | | | | active clock edge time
14.584 | 0.000 | | | | | usb_core_phase
14.584 | 0.000 | tCL | RR | 886 | PLL_R[0] | usb_pll/CLKOUTP
16.095 | 1.511 | tNET | RR | 1 | R20C36[1][A] | diagnostic/tx_count_0_s3/CLK
16.297 | 0.202 | tC2Q | RR | 5 | R20C36[1][A] | diagnostic/tx_count_0_s3/Q
16.299 | 0.002 | tNET | RR | 1 | R20C36[1][A] | diagnostic/n123_s5/I3
16.531 | 0.232 | tINS | RF | 1 | R20C36[1][A] | diagnostic/n123_s5/F
16.531 | 0.000 | tNET | FF | 1 | R20C36[1][A] | diagnostic/tx_count_0_s3/D

Data Required Path:

AT | DELAY | TYPE | RF | FANOUT | LOC | NODE
14.584 | 14.584 | | | | | active clock edge time
14.584 | 0.000 | | | | | usb_core_phase
14.584 | 0.000 | tCL | RR | 886 | PLL_R[0] | usb_pll/CLKOUTP
16.095 | 1.511 | tNET | RR | 1 | R20C36[1][A] | diagnostic/tx_count_0_s3/CLK
16.106 | 0.011 | tHld | | 1 | R20C36[1][A] | diagnostic/tx_count_0_s3

Path Statistics:

Clock Skew | 0.000
Hold Relationship | 0.000
Logic Level | 2
Arrival Clock Path Delay | cell: 0.000, 0.000%; route: 1.511, 100.000%
Arrival Data Path Delay | cell: 0.232, 53.157%; route: 0.002, 0.560%; tC2Q: 0.202, 46.283%
Required Clock Path Delay | cell: 0.000, 0.000%; route: 1.511, 100.000%

### Path13

Path Summary:

Slack | 0.425
Data Arrival Time | 16.531
Data Required Time | 16.106
From | diagnostic/tx_left_0_s2
To | diagnostic/tx_left_0_s2
Launch Clk | usb_core_phase:[R]
Latch Clk | usb_core_phase:[R]

Data Arrival Path:

AT | DELAY | TYPE | RF | FANOUT | LOC | NODE
14.584 | 14.584 | | | | | active clock edge time
14.584 | 0.000 | | | | | usb_core_phase
14.584 | 0.000 | tCL | RR | 886 | PLL_R[0] | usb_pll/CLKOUTP
16.095 | 1.511 | tNET | RR | 1 | R20C33[0][A] | diagnostic/tx_left_0_s2/CLK
16.297 | 0.202 | tC2Q | RR | 5 | R20C33[0][A] | diagnostic/tx_left_0_s2/Q
16.299 | 0.002 | tNET | RR | 1 | R20C33[0][A] | diagnostic/n107_s4/I3
16.531 | 0.232 | tINS | RF | 1 | R20C33[0][A] | diagnostic/n107_s4/F
16.531 | 0.000 | tNET | FF | 1 | R20C33[0][A] | diagnostic/tx_left_0_s2/D

Data Required Path:

AT | DELAY | TYPE | RF | FANOUT | LOC | NODE
14.584 | 14.584 | | | | | active clock edge time
14.584 | 0.000 | | | | | usb_core_phase
14.584 | 0.000 | tCL | RR | 886 | PLL_R[0] | usb_pll/CLKOUTP
16.095 | 1.511 | tNET | RR | 1 | R20C33[0][A] | diagnostic/tx_left_0_s2/CLK
16.106 | 0.011 | tHld | | 1 | R20C33[0][A] | diagnostic/tx_left_0_s2

Path Statistics:

Clock Skew | 0.000
Hold Relationship | 0.000
Logic Level | 2
Arrival Clock Path Delay | cell: 0.000, 0.000%; route: 1.511, 100.000%
Arrival Data Path Delay | cell: 0.232, 53.157%; route: 0.002, 0.560%; tC2Q: 0.202, 46.283%
Required Clock Path Delay | cell: 0.000, 0.000%; route: 1.511, 100.000%

### Path14

Path Summary:

Slack | 0.425
Data Arrival Time | 16.531
Data Required Time | 16.106
From | diagnostic/tx_count_3_s1
To | diagnostic/tx_count_3_s1
Launch Clk | usb_core_phase:[R]
Latch Clk | usb_core_phase:[R]

Data Arrival Path:

AT | DELAY | TYPE | RF | FANOUT | LOC | NODE
14.584 | 14.584 | | | | | active clock edge time
14.584 | 0.000 | | | | | usb_core_phase
14.584 | 0.000 | tCL | RR | 886 | PLL_R[0] | usb_pll/CLKOUTP
16.095 | 1.511 | tNET | RR | 1 | R20C36[0][A] | diagnostic/tx_count_3_s1/CLK
16.297 | 0.202 | tC2Q | RR | 2 | R20C36[0][A] | diagnostic/tx_count_3_s1/Q
16.299 | 0.002 | tNET | RR | 1 | R20C36[0][A] | diagnostic/n120_s1/I1
16.531 | 0.232 | tINS | RF | 1 | R20C36[0][A] | diagnostic/n120_s1/F
16.531 | 0.000 | tNET | FF | 1 | R20C36[0][A] | diagnostic/tx_count_3_s1/D

Data Required Path:

AT | DELAY | TYPE | RF | FANOUT | LOC | NODE
14.584 | 14.584 | | | | | active clock edge time
14.584 | 0.000 | | | | | usb_core_phase
14.584 | 0.000 | tCL | RR | 886 | PLL_R[0] | usb_pll/CLKOUTP
16.095 | 1.511 | tNET | RR | 1 | R20C36[0][A] | diagnostic/tx_count_3_s1/CLK
16.106 | 0.011 | tHld | | 1 | R20C36[0][A] | diagnostic/tx_count_3_s1

Path Statistics:

Clock Skew | 0.000
Hold Relationship | 0.000
Logic Level | 2
Arrival Clock Path Delay | cell: 0.000, 0.000%; route: 1.511, 100.000%
Arrival Data Path Delay | cell: 0.232, 53.157%; route: 0.002, 0.560%; tC2Q: 0.202, 46.283%
Required Clock Path Delay | cell: 0.000, 0.000%; route: 1.511, 100.000%

### Path15

Path Summary:

Slack | 0.425
Data Arrival Time | 16.531
Data Required Time | 16.106
From | diagnostic/tx_count_7_s1
To | diagnostic/tx_count_7_s1
Launch Clk | usb_core_phase:[R]
Latch Clk | usb_core_phase:[R]

Data Arrival Path:

AT | DELAY | TYPE | RF | FANOUT | LOC | NODE
14.584 | 14.584 | | | | | active clock edge time
14.584 | 0.000 | | | | | usb_core_phase
14.584 | 0.000 | tCL | RR | 886 | PLL_R[0] | usb_pll/CLKOUTP
16.095 | 1.511 | tNET | RR | 1 | R21C34[1][A] | diagnostic/tx_count_7_s1/CLK
16.297 | 0.202 | tC2Q | RR | 4 | R21C34[1][A] | diagnostic/tx_count_7_s1/Q
16.299 | 0.002 | tNET | RR | 1 | R21C34[1][A] | diagnostic/n116_s2/I1
16.531 | 0.232 | tINS | RF | 1 | R21C34[1][A] | diagnostic/n116_s2/F
16.531 | 0.000 | tNET | FF | 1 | R21C34[1][A] | diagnostic/tx_count_7_s1/D

Data Required Path:

AT | DELAY | TYPE | RF | FANOUT | LOC | NODE
14.584 | 14.584 | | | | | active clock edge time
14.584 | 0.000 | | | | | usb_core_phase
14.584 | 0.000 | tCL | RR | 886 | PLL_R[0] | usb_pll/CLKOUTP
16.095 | 1.511 | tNET | RR | 1 | R21C34[1][A] | diagnostic/tx_count_7_s1/CLK
16.106 | 0.011 | tHld | | 1 | R21C34[1][A] | diagnostic/tx_count_7_s1

Path Statistics:

Clock Skew | 0.000
Hold Relationship | 0.000
Logic Level | 2
Arrival Clock Path Delay | cell: 0.000, 0.000%; route: 1.511, 100.000%
Arrival Data Path Delay | cell: 0.232, 53.157%; route: 0.002, 0.560%; tC2Q: 0.202, 46.283%
Required Clock Path Delay | cell: 0.000, 0.000%; route: 1.511, 100.000%

### Path16

Path Summary:

Slack | 0.425
Data Arrival Time | 16.531
Data Required Time | 16.106
From | diagnostic/tx_count_9_s1
To | diagnostic/tx_count_9_s1
Launch Clk | usb_core_phase:[R]
Latch Clk | usb_core_phase:[R]

Data Arrival Path:

AT | DELAY | TYPE | RF | FANOUT | LOC | NODE
14.584 | 14.584 | | | | | active clock edge time
14.584 | 0.000 | | | | | usb_core_phase
14.584 | 0.000 | tCL | RR | 886 | PLL_R[0] | usb_pll/CLKOUTP
16.095 | 1.511 | tNET | RR | 1 | R20C35[1][A] | diagnostic/tx_count_9_s1/CLK
16.297 | 0.202 | tC2Q | RR | 2 | R20C35[1][A] | diagnostic/tx_count_9_s1/Q
16.299 | 0.002 | tNET | RR | 1 | R20C35[1][A] | diagnostic/n114_s1/I1
16.531 | 0.232 | tINS | RF | 1 | R20C35[1][A] | diagnostic/n114_s1/F
16.531 | 0.000 | tNET | FF | 1 | R20C35[1][A] | diagnostic/tx_count_9_s1/D

Data Required Path:

AT | DELAY | TYPE | RF | FANOUT | LOC | NODE
14.584 | 14.584 | | | | | active clock edge time
14.584 | 0.000 | | | | | usb_core_phase
14.584 | 0.000 | tCL | RR | 886 | PLL_R[0] | usb_pll/CLKOUTP
16.095 | 1.511 | tNET | RR | 1 | R20C35[1][A] | diagnostic/tx_count_9_s1/CLK
16.106 | 0.011 | tHld | | 1 | R20C35[1][A] | diagnostic/tx_count_9_s1

Path Statistics:

Clock Skew | 0.000
Hold Relationship | 0.000
Logic Level | 2
Arrival Clock Path Delay | cell: 0.000, 0.000%; route: 1.511, 100.000%
Arrival Data Path Delay | cell: 0.232, 53.157%; route: 0.002, 0.560%; tC2Q: 0.202, 46.283%
Required Clock Path Delay | cell: 0.000, 0.000%; route: 1.511, 100.000%

### Path17

Path Summary:

Slack | 0.425
Data Arrival Time | 16.531
Data Required Time | 16.106
From | diagnostic/tx_count_11_s1
To | diagnostic/tx_count_11_s1
Launch Clk | usb_core_phase:[R]
Latch Clk | usb_core_phase:[R]

Data Arrival Path:

AT | DELAY | TYPE | RF | FANOUT | LOC | NODE
14.584 | 14.584 | | | | | active clock edge time
14.584 | 0.000 | | | | | usb_core_phase
14.584 | 0.000 | tCL | RR | 886 | PLL_R[0] | usb_pll/CLKOUTP
16.095 | 1.511 | tNET | RR | 1 | R20C35[0][A] | diagnostic/tx_count_11_s1/CLK
16.297 | 0.202 | tC2Q | RR | 3 | R20C35[0][A] | diagnostic/tx_count_11_s1/Q
16.299 | 0.002 | tNET | RR | 1 | R20C35[0][A] | diagnostic/n112_s2/I3
16.531 | 0.232 | tINS | RF | 1 | R20C35[0][A] | diagnostic/n112_s2/F
16.531 | 0.000 | tNET | FF | 1 | R20C35[0][A] | diagnostic/tx_count_11_s1/D

Data Required Path:

AT | DELAY | TYPE | RF | FANOUT | LOC | NODE
14.584 | 14.584 | | | | | active clock edge time
14.584 | 0.000 | | | | | usb_core_phase
14.584 | 0.000 | tCL | RR | 886 | PLL_R[0] | usb_pll/CLKOUTP
16.095 | 1.511 | tNET | RR | 1 | R20C35[0][A] | diagnostic/tx_count_11_s1/CLK
16.106 | 0.011 | tHld | | 1 | R20C35[0][A] | diagnostic/tx_count_11_s1

Path Statistics:

Clock Skew | 0.000
Hold Relationship | 0.000
Logic Level | 2
Arrival Clock Path Delay | cell: 0.000, 0.000%; route: 1.511, 100.000%
Arrival Data Path Delay | cell: 0.232, 53.157%; route: 0.002, 0.560%; tC2Q: 0.202, 46.283%
Required Clock Path Delay | cell: 0.000, 0.000%; route: 1.511, 100.000%

### Path18

Path Summary:

Slack | 0.425
Data Arrival Time | 16.531
Data Required Time | 16.106
From | diagnostic/tx_count_14_s1
To | diagnostic/tx_count_14_s1
Launch Clk | usb_core_phase:[R]
Latch Clk | usb_core_phase:[R]

Data Arrival Path:

AT | DELAY | TYPE | RF | FANOUT | LOC | NODE
14.584 | 14.584 | | | | | active clock edge time
14.584 | 0.000 | | | | | usb_core_phase
14.584 | 0.000 | tCL | RR | 886 | PLL_R[0] | usb_pll/CLKOUTP
16.095 | 1.511 | tNET | RR | 1 | R21C34[0][A] | diagnostic/tx_count_14_s1/CLK
16.297 | 0.202 | tC2Q | RR | 3 | R21C34[0][A] | diagnostic/tx_count_14_s1/Q
16.299 | 0.002 | tNET | RR | 1 | R21C34[0][A] | diagnostic/n109_s2/I3
16.531 | 0.232 | tINS | RF | 1 | R21C34[0][A] | diagnostic/n109_s2/F
16.531 | 0.000 | tNET | FF | 1 | R21C34[0][A] | diagnostic/tx_count_14_s1/D

Data Required Path:

AT | DELAY | TYPE | RF | FANOUT | LOC | NODE
14.584 | 14.584 | | | | | active clock edge time
14.584 | 0.000 | | | | | usb_core_phase
14.584 | 0.000 | tCL | RR | 886 | PLL_R[0] | usb_pll/CLKOUTP
16.095 | 1.511 | tNET | RR | 1 | R21C34[0][A] | diagnostic/tx_count_14_s1/CLK
16.106 | 0.011 | tHld | | 1 | R21C34[0][A] | diagnostic/tx_count_14_s1

Path Statistics:

Clock Skew | 0.000
Hold Relationship | 0.000
Logic Level | 2
Arrival Clock Path Delay | cell: 0.000, 0.000%; route: 1.511, 100.000%
Arrival Data Path Delay | cell: 0.232, 53.157%; route: 0.002, 0.560%; tC2Q: 0.202, 46.283%
Required Clock Path Delay | cell: 0.000, 0.000%; route: 1.511, 100.000%

### Path19

Path Summary:

Slack | 0.425
Data Arrival Time | 16.531
Data Required Time | 16.106
From | diagnostic/tx_left_2_s1
To | diagnostic/tx_left_2_s1
Launch Clk | usb_core_phase:[R]
Latch Clk | usb_core_phase:[R]

Data Arrival Path:

AT | DELAY | TYPE | RF | FANOUT | LOC | NODE
14.584 | 14.584 | | | | | active clock edge time
14.584 | 0.000 | | | | | usb_core_phase
14.584 | 0.000 | tCL | RR | 886 | PLL_R[0] | usb_pll/CLKOUTP
16.095 | 1.511 | tNET | RR | 1 | R20C34[1][A] | diagnostic/tx_left_2_s1/CLK
16.297 | 0.202 | tC2Q | RR | 3 | R20C34[1][A] | diagnostic/tx_left_2_s1/Q
16.299 | 0.002 | tNET | RR | 1 | R20C34[1][A] | diagnostic/n105_s2/I3
16.531 | 0.232 | tINS | RF | 1 | R20C34[1][A] | diagnostic/n105_s2/F
16.531 | 0.000 | tNET | FF | 1 | R20C34[1][A] | diagnostic/tx_left_2_s1/D

Data Required Path:

AT | DELAY | TYPE | RF | FANOUT | LOC | NODE
14.584 | 14.584 | | | | | active clock edge time
14.584 | 0.000 | | | | | usb_core_phase
14.584 | 0.000 | tCL | RR | 886 | PLL_R[0] | usb_pll/CLKOUTP
16.095 | 1.511 | tNET | RR | 1 | R20C34[1][A] | diagnostic/tx_left_2_s1/CLK
16.106 | 0.011 | tHld | | 1 | R20C34[1][A] | diagnostic/tx_left_2_s1

Path Statistics:

Clock Skew | 0.000
Hold Relationship | 0.000
Logic Level | 2
Arrival Clock Path Delay | cell: 0.000, 0.000%; route: 1.511, 100.000%
Arrival Data Path Delay | cell: 0.232, 53.157%; route: 0.002, 0.560%; tC2Q: 0.202, 46.283%
Required Clock Path Delay | cell: 0.000, 0.000%; route: 1.511, 100.000%

### Path20

Path Summary:

Slack | 0.425
Data Arrival Time | 16.531
Data Required Time | 16.106
From | diagnostic/tx_left_3_s1
To | diagnostic/tx_left_3_s1
Launch Clk | usb_core_phase:[R]
Latch Clk | usb_core_phase:[R]

Data Arrival Path:

AT | DELAY | TYPE | RF | FANOUT | LOC | NODE
14.584 | 14.584 | | | | | active clock edge time
14.584 | 0.000 | | | | | usb_core_phase
14.584 | 0.000 | tCL | RR | 886 | PLL_R[0] | usb_pll/CLKOUTP
16.095 | 1.511 | tNET | RR | 1 | R20C34[0][A] | diagnostic/tx_left_3_s1/CLK
16.297 | 0.202 | tC2Q | RR | 3 | R20C34[0][A] | diagnostic/tx_left_3_s1/Q
16.299 | 0.002 | tNET | RR | 1 | R20C34[0][A] | diagnostic/n104_s1/I3
16.531 | 0.232 | tINS | RF | 1 | R20C34[0][A] | diagnostic/n104_s1/F
16.531 | 0.000 | tNET | FF | 1 | R20C34[0][A] | diagnostic/tx_left_3_s1/D

Data Required Path:

AT | DELAY | TYPE | RF | FANOUT | LOC | NODE
14.584 | 14.584 | | | | | active clock edge time
14.584 | 0.000 | | | | | usb_core_phase
14.584 | 0.000 | tCL | RR | 886 | PLL_R[0] | usb_pll/CLKOUTP
16.095 | 1.511 | tNET | RR | 1 | R20C34[0][A] | diagnostic/tx_left_3_s1/CLK
16.106 | 0.011 | tHld | | 1 | R20C34[0][A] | diagnostic/tx_left_3_s1

Path Statistics:

Clock Skew | 0.000
Hold Relationship | 0.000
Logic Level | 2
Arrival Clock Path Delay | cell: 0.000, 0.000%; route: 1.511, 100.000%
Arrival Data Path Delay | cell: 0.232, 53.157%; route: 0.002, 0.560%; tC2Q: 0.202, 46.283%
Required Clock Path Delay | cell: 0.000, 0.000%; route: 1.511, 100.000%

### Path21

Path Summary:

Slack | 0.425
Data Arrival Time | 16.531
Data Required Time | 16.106
From | parser/lease_31_s6
To | parser/lease_31_s6
Launch Clk | usb_core_phase:[R]
Latch Clk | usb_core_phase:[R]

Data Arrival Path:

AT | DELAY | TYPE | RF | FANOUT | LOC | NODE
14.584 | 14.584 | | | | | active clock edge time
14.584 | 0.000 | | | | | usb_core_phase
14.584 | 0.000 | tCL | RR | 886 | PLL_R[0] | usb_pll/CLKOUTP
16.095 | 1.511 | tNET | RR | 1 | R32C37[0][A] | parser/lease_31_s6/CLK
16.297 | 0.202 | tC2Q | RR | 3 | R32C37[0][A] | parser/lease_31_s6/Q
16.299 | 0.002 | tNET | RR | 1 | R32C37[0][A] | parser/n121_s3/I3
16.531 | 0.232 | tINS | RF | 1 | R32C37[0][A] | parser/n121_s3/F
16.531 | 0.000 | tNET | FF | 1 | R32C37[0][A] | parser/lease_31_s6/D

Data Required Path:

AT | DELAY | TYPE | RF | FANOUT | LOC | NODE
14.584 | 14.584 | | | | | active clock edge time
14.584 | 0.000 | | | | | usb_core_phase
14.584 | 0.000 | tCL | RR | 886 | PLL_R[0] | usb_pll/CLKOUTP
16.095 | 1.511 | tNET | RR | 1 | R32C37[0][A] | parser/lease_31_s6/CLK
16.106 | 0.011 | tHld | | 1 | R32C37[0][A] | parser/lease_31_s6

Path Statistics:

Clock Skew | 0.000
Hold Relationship | 0.000
Logic Level | 2
Arrival Clock Path Delay | cell: 0.000, 0.000%; route: 1.511, 100.000%
Arrival Data Path Delay | cell: 0.232, 53.157%; route: 0.002, 0.560%; tC2Q: 0.202, 46.283%
Required Clock Path Delay | cell: 0.000, 0.000%; route: 1.511, 100.000%

### Path22

Path Summary:

Slack | 0.425
Data Arrival Time | 16.531
Data Required Time | 16.106
From | parser/gap_0_s1
To | parser/gap_0_s1
Launch Clk | usb_core_phase:[R]
Latch Clk | usb_core_phase:[R]

Data Arrival Path:

AT | DELAY | TYPE | RF | FANOUT | LOC | NODE
14.584 | 14.584 | | | | | active clock edge time
14.584 | 0.000 | | | | | usb_core_phase
14.584 | 0.000 | tCL | RR | 886 | PLL_R[0] | usb_pll/CLKOUTP
16.095 | 1.511 | tNET | RR | 1 | R36C38[1][A] | parser/gap_0_s1/CLK
16.297 | 0.202 | tC2Q | RR | 5 | R36C38[1][A] | parser/gap_0_s1/Q
16.299 | 0.002 | tNET | RR | 1 | R36C38[1][A] | parser/n266_s5/I3
16.531 | 0.232 | tINS | RF | 1 | R36C38[1][A] | parser/n266_s5/F
16.531 | 0.000 | tNET | FF | 1 | R36C38[1][A] | parser/gap_0_s1/D

Data Required Path:

AT | DELAY | TYPE | RF | FANOUT | LOC | NODE
14.584 | 14.584 | | | | | active clock edge time
14.584 | 0.000 | | | | | usb_core_phase
14.584 | 0.000 | tCL | RR | 886 | PLL_R[0] | usb_pll/CLKOUTP
16.095 | 1.511 | tNET | RR | 1 | R36C38[1][A] | parser/gap_0_s1/CLK
16.106 | 0.011 | tHld | | 1 | R36C38[1][A] | parser/gap_0_s1

Path Statistics:

Clock Skew | 0.000
Hold Relationship | 0.000
Logic Level | 2
Arrival Clock Path Delay | cell: 0.000, 0.000%; route: 1.511, 100.000%
Arrival Data Path Delay | cell: 0.232, 53.157%; route: 0.002, 0.560%; tC2Q: 0.202, 46.283%
Required Clock Path Delay | cell: 0.000, 0.000%; route: 1.511, 100.000%

### Path23

Path Summary:

Slack | 0.425
Data Arrival Time | 16.531
Data Required Time | 16.106
From | parser/lease_0_s1
To | parser/lease_0_s1
Launch Clk | usb_core_phase:[R]
Latch Clk | usb_core_phase:[R]

Data Arrival Path:

AT | DELAY | TYPE | RF | FANOUT | LOC | NODE
14.584 | 14.584 | | | | | active clock edge time
14.584 | 0.000 | | | | | usb_core_phase
14.584 | 0.000 | tCL | RR | 886 | PLL_R[0] | usb_pll/CLKOUTP
16.095 | 1.511 | tNET | RR | 1 | R32C38[0][A] | parser/lease_0_s1/CLK
16.297 | 0.202 | tC2Q | RR | 6 | R32C38[0][A] | parser/lease_0_s1/Q
16.299 | 0.002 | tNET | RR | 1 | R32C38[0][A] | parser/n152_s2/I0
16.531 | 0.232 | tINS | RF | 1 | R32C38[0][A] | parser/n152_s2/F
16.531 | 0.000 | tNET | FF | 1 | R32C38[0][A] | parser/lease_0_s1/D

Data Required Path:

AT | DELAY | TYPE | RF | FANOUT | LOC | NODE
14.584 | 14.584 | | | | | active clock edge time
14.584 | 0.000 | | | | | usb_core_phase
14.584 | 0.000 | tCL | RR | 886 | PLL_R[0] | usb_pll/CLKOUTP
16.095 | 1.511 | tNET | RR | 1 | R32C38[0][A] | parser/lease_0_s1/CLK
16.106 | 0.011 | tHld | | 1 | R32C38[0][A] | parser/lease_0_s1

Path Statistics:

Clock Skew | 0.000
Hold Relationship | 0.000
Logic Level | 2
Arrival Clock Path Delay | cell: 0.000, 0.000%; route: 1.511, 100.000%
Arrival Data Path Delay | cell: 0.232, 53.157%; route: 0.002, 0.560%; tC2Q: 0.202, 46.283%
Required Clock Path Delay | cell: 0.000, 0.000%; route: 1.511, 100.000%

### Path24

Path Summary:

Slack | 0.425
Data Arrival Time | 16.531
Data Required Time | 16.106
From | parser/lease_7_s1
To | parser/lease_7_s1
Launch Clk | usb_core_phase:[R]
Latch Clk | usb_core_phase:[R]

Data Arrival Path:

AT | DELAY | TYPE | RF | FANOUT | LOC | NODE
14.584 | 14.584 | | | | | active clock edge time
14.584 | 0.000 | | | | | usb_core_phase
14.584 | 0.000 | tCL | RR | 886 | PLL_R[0] | usb_pll/CLKOUTP
16.095 | 1.511 | tNET | RR | 1 | R33C39[0][A] | parser/lease_7_s1/CLK
16.297 | 0.202 | tC2Q | RR | 3 | R33C39[0][A] | parser/lease_7_s1/Q
16.299 | 0.002 | tNET | RR | 1 | R33C39[0][A] | parser/n145_s2/I3
16.531 | 0.232 | tINS | RF | 1 | R33C39[0][A] | parser/n145_s2/F
16.531 | 0.000 | tNET | FF | 1 | R33C39[0][A] | parser/lease_7_s1/D

Data Required Path:

AT | DELAY | TYPE | RF | FANOUT | LOC | NODE
14.584 | 14.584 | | | | | active clock edge time
14.584 | 0.000 | | | | | usb_core_phase
14.584 | 0.000 | tCL | RR | 886 | PLL_R[0] | usb_pll/CLKOUTP
16.095 | 1.511 | tNET | RR | 1 | R33C39[0][A] | parser/lease_7_s1/CLK
16.106 | 0.011 | tHld | | 1 | R33C39[0][A] | parser/lease_7_s1

Path Statistics:

Clock Skew | 0.000
Hold Relationship | 0.000
Logic Level | 2
Arrival Clock Path Delay | cell: 0.000, 0.000%; route: 1.511, 100.000%
Arrival Data Path Delay | cell: 0.232, 53.157%; route: 0.002, 0.560%; tC2Q: 0.202, 46.283%
Required Clock Path Delay | cell: 0.000, 0.000%; route: 1.511, 100.000%

### Path25

Path Summary:

Slack | 0.425
Data Arrival Time | 16.531
Data Required Time | 16.106
From | parser/lease_9_s1
To | parser/lease_9_s1
Launch Clk | usb_core_phase:[R]
Latch Clk | usb_core_phase:[R]

Data Arrival Path:

AT | DELAY | TYPE | RF | FANOUT | LOC | NODE
14.584 | 14.584 | | | | | active clock edge time
14.584 | 0.000 | | | | | usb_core_phase
14.584 | 0.000 | tCL | RR | 886 | PLL_R[0] | usb_pll/CLKOUTP
16.095 | 1.511 | tNET | RR | 1 | R33C38[1][A] | parser/lease_9_s1/CLK
16.297 | 0.202 | tC2Q | RR | 2 | R33C38[1][A] | parser/lease_9_s1/Q
16.299 | 0.002 | tNET | RR | 1 | R33C38[1][A] | parser/n143_s1/I3
16.531 | 0.232 | tINS | RF | 1 | R33C38[1][A] | parser/n143_s1/F
16.531 | 0.000 | tNET | FF | 1 | R33C38[1][A] | parser/lease_9_s1/D

Data Required Path:

AT | DELAY | TYPE | RF | FANOUT | LOC | NODE
14.584 | 14.584 | | | | | active clock edge time
14.584 | 0.000 | | | | | usb_core_phase
14.584 | 0.000 | tCL | RR | 886 | PLL_R[0] | usb_pll/CLKOUTP
16.095 | 1.511 | tNET | RR | 1 | R33C38[1][A] | parser/lease_9_s1/CLK
16.106 | 0.011 | tHld | | 1 | R33C38[1][A] | parser/lease_9_s1

Path Statistics:

Clock Skew | 0.000
Hold Relationship | 0.000
Logic Level | 2
Arrival Clock Path Delay | cell: 0.000, 0.000%; route: 1.511, 100.000%
Arrival Data Path Delay | cell: 0.232, 53.157%; route: 0.002, 0.560%; tC2Q: 0.202, 46.283%
Required Clock Path Delay | cell: 0.000, 0.000%; route: 1.511, 100.000%

### Recovery Analysis Report

#### Report Command:report_timing -recovery -max_paths 25 -max_common_paths 1

#### No recovery paths to report!

### Removal Analysis Report

#### Report Command:report_timing -removal -max_paths 25 -max_common_paths 1

#### No removal paths to report!

## Minimum Pulse Width Report:

#### Report Command:report_min_pulse_width -nworst 10 -detail

### MPW1

MPW Summary:

Slack: | 6.570
Actual Width: | 7.570
Required Width: | 1.000
Type: | Low Pulse Width
Clock: | usb_core_phase
Objects: | usb_reset_0_s0

Late clock Path:

AT | DELAY | TYPE | RF | NODE
6.250 | 0.000 | | | active clock edge time
6.250 | 0.000 | | | usb_core_phase
6.250 | 0.000 | tCL | FF | usb_pll/CLKOUTP
8.525 | 2.274 | tNET | FF | usb_reset_0_s0/CLK

Early clock Path:

AT | DELAY | TYPE | RF | NODE
14.584 | 0.000 | | | active clock edge time
14.584 | 0.000 | | | usb_core_phase
14.584 | 0.000 | tCL | RR | usb_pll/CLKOUTP
16.095 | 1.511 | tNET | RR | usb_reset_0_s0/CLK

### MPW2

MPW Summary:

Slack: | 6.570
Actual Width: | 7.570
Required Width: | 1.000
Type: | Low Pulse Width
Clock: | usb_core_phase
Objects: | heartbeat_24_s0

Late clock Path:

AT | DELAY | TYPE | RF | NODE
6.250 | 0.000 | | | active clock edge time
6.250 | 0.000 | | | usb_core_phase
6.250 | 0.000 | tCL | FF | usb_pll/CLKOUTP
8.525 | 2.274 | tNET | FF | heartbeat_24_s0/CLK

Early clock Path:

AT | DELAY | TYPE | RF | NODE
14.584 | 0.000 | | | active clock edge time
14.584 | 0.000 | | | usb_core_phase
14.584 | 0.000 | tCL | RR | usb_pll/CLKOUTP
16.095 | 1.511 | tNET | RR | heartbeat_24_s0/CLK

### MPW3

MPW Summary:

Slack: | 6.570
Actual Width: | 7.570
Required Width: | 1.000
Type: | Low Pulse Width
Clock: | usb_core_phase
Objects: | heartbeat_20_s0

Late clock Path:

AT | DELAY | TYPE | RF | NODE
6.250 | 0.000 | | | active clock edge time
6.250 | 0.000 | | | usb_core_phase
6.250 | 0.000 | tCL | FF | usb_pll/CLKOUTP
8.525 | 2.274 | tNET | FF | heartbeat_20_s0/CLK

Early clock Path:

AT | DELAY | TYPE | RF | NODE
14.584 | 0.000 | | | active clock edge time
14.584 | 0.000 | | | usb_core_phase
14.584 | 0.000 | tCL | RR | usb_pll/CLKOUTP
16.095 | 1.511 | tNET | RR | heartbeat_20_s0/CLK

### MPW4

MPW Summary:

Slack: | 6.570
Actual Width: | 7.570
Required Width: | 1.000
Type: | Low Pulse Width
Clock: | usb_core_phase
Objects: | heartbeat_18_s0

Late clock Path:

AT | DELAY | TYPE | RF | NODE
6.250 | 0.000 | | | active clock edge time
6.250 | 0.000 | | | usb_core_phase
6.250 | 0.000 | tCL | FF | usb_pll/CLKOUTP
8.525 | 2.274 | tNET | FF | heartbeat_18_s0/CLK

Early clock Path:

AT | DELAY | TYPE | RF | NODE
14.584 | 0.000 | | | active clock edge time
14.584 | 0.000 | | | usb_core_phase
14.584 | 0.000 | tCL | RR | usb_pll/CLKOUTP
16.095 | 1.511 | tNET | RR | heartbeat_18_s0/CLK

### MPW5

MPW Summary:

Slack: | 6.570
Actual Width: | 7.570
Required Width: | 1.000
Type: | Low Pulse Width
Clock: | usb_core_phase
Objects: | heartbeat_17_s0

Late clock Path:

AT | DELAY | TYPE | RF | NODE
6.250 | 0.000 | | | active clock edge time
6.250 | 0.000 | | | usb_core_phase
6.250 | 0.000 | tCL | FF | usb_pll/CLKOUTP
8.525 | 2.274 | tNET | FF | heartbeat_17_s0/CLK

Early clock Path:

AT | DELAY | TYPE | RF | NODE
14.584 | 0.000 | | | active clock edge time
14.584 | 0.000 | | | usb_core_phase
14.584 | 0.000 | tCL | RR | usb_pll/CLKOUTP
16.095 | 1.511 | tNET | RR | heartbeat_17_s0/CLK

### MPW6

MPW Summary:

Slack: | 6.570
Actual Width: | 7.570
Required Width: | 1.000
Type: | Low Pulse Width
Clock: | usb_core_phase
Objects: | check_2_s0

Late clock Path:

AT | DELAY | TYPE | RF | NODE
6.250 | 0.000 | | | active clock edge time
6.250 | 0.000 | | | usb_core_phase
6.250 | 0.000 | tCL | FF | usb_pll/CLKOUTP
8.525 | 2.274 | tNET | FF | check_2_s0/CLK

Early clock Path:

AT | DELAY | TYPE | RF | NODE
14.584 | 0.000 | | | active clock edge time
14.584 | 0.000 | | | usb_core_phase
14.584 | 0.000 | tCL | RR | usb_pll/CLKOUTP
16.095 | 1.511 | tNET | RR | check_2_s0/CLK

### MPW7

MPW Summary:

Slack: | 6.570
Actual Width: | 7.570
Required Width: | 1.000
Type: | Low Pulse Width
Clock: | usb_core_phase
Objects: | host/host_0/watchdog_26_s0

Late clock Path:

AT | DELAY | TYPE | RF | NODE
6.250 | 0.000 | | | active clock edge time
6.250 | 0.000 | | | usb_core_phase
6.250 | 0.000 | tCL | FF | usb_pll/CLKOUTP
8.525 | 2.274 | tNET | FF | host/host_0/watchdog_26_s0/CLK

Early clock Path:

AT | DELAY | TYPE | RF | NODE
14.584 | 0.000 | | | active clock edge time
14.584 | 0.000 | | | usb_core_phase
14.584 | 0.000 | tCL | RR | usb_pll/CLKOUTP
16.095 | 1.511 | tNET | RR | host/host_0/watchdog_26_s0/CLK

### MPW8

MPW Summary:

Slack: | 6.570
Actual Width: | 7.570
Required Width: | 1.000
Type: | Low Pulse Width
Clock: | usb_core_phase
Objects: | host/host_0/enum/parser/desc_type_4_s1

Late clock Path:

AT | DELAY | TYPE | RF | NODE
6.250 | 0.000 | | | active clock edge time
6.250 | 0.000 | | | usb_core_phase
6.250 | 0.000 | tCL | FF | usb_pll/CLKOUTP
8.525 | 2.274 | tNET | FF | host/host_0/enum/parser/desc_type_4_s1/CLK

Early clock Path:

AT | DELAY | TYPE | RF | NODE
14.584 | 0.000 | | | active clock edge time
14.584 | 0.000 | | | usb_core_phase
14.584 | 0.000 | tCL | RR | usb_pll/CLKOUTP
16.095 | 1.511 | tNET | RR | host/host_0/enum/parser/desc_type_4_s1/CLK

### MPW9

MPW Summary:

Slack: | 6.570
Actual Width: | 7.570
Required Width: | 1.000
Type: | Low Pulse Width
Clock: | usb_core_phase
Objects: | host/host_0/enum/sie/sof_controller/microframe_number_2_s1

Late clock Path:

AT | DELAY | TYPE | RF | NODE
6.250 | 0.000 | | | active clock edge time
6.250 | 0.000 | | | usb_core_phase
6.250 | 0.000 | tCL | FF | usb_pll/CLKOUTP
8.525 | 2.274 | tNET | FF | host/host_0/enum/sie/sof_controller/microframe_number_2_s1/CLK

Early clock Path:

AT | DELAY | TYPE | RF | NODE
14.584 | 0.000 | | | active clock edge time
14.584 | 0.000 | | | usb_core_phase
14.584 | 0.000 | tCL | RR | usb_pll/CLKOUTP
16.095 | 1.511 | tNET | RR | host/host_0/enum/sie/sof_controller/microframe_number_2_s1/CLK

### MPW10

MPW Summary:

Slack: | 6.570
Actual Width: | 7.570
Required Width: | 1.000
Type: | Low Pulse Width
Clock: | usb_core_phase
Objects: | host/host_0/enum/sie/sof_controller/sof_timer_15_s0

Late clock Path:

AT | DELAY | TYPE | RF | NODE
6.250 | 0.000 | | | active clock edge time
6.250 | 0.000 | | | usb_core_phase
6.250 | 0.000 | tCL | FF | usb_pll/CLKOUTP
8.525 | 2.274 | tNET | FF | host/host_0/enum/sie/sof_controller/sof_timer_15_s0/CLK

Early clock Path:

AT | DELAY | TYPE | RF | NODE
14.584 | 0.000 | | | active clock edge time
14.584 | 0.000 | | | usb_core_phase
14.584 | 0.000 | tCL | RR | usb_pll/CLKOUTP
16.095 | 1.511 | tNET | RR | host/host_0/enum/sie/sof_controller/sof_timer_15_s0/CLK

## High Fanout Nets Report:

#### Report Command:report_high_fanout_nets -max_nets 10

FANOUT | NET NAME | WORST SLACK | MAX DELAY
886 | usb_core_clk | 1.211 | 2.274
620 | usb_reset[1] | 6.246 | 1.604
357 | host/host_0/n122_6 | 5.742 | 2.273
101 | parser/n1150_4 | 9.882 | 1.599
72 | parser/n152_8 | 4.185 | 1.970
72 | n448_5 | 5.742 | 2.263
63 | n398_8 | 6.159 | 1.758
59 | host/host_0/enum/sie/n97_8 | 5.742 | 1.725
56 | report_63_12 | 12.129 | 1.423
55 | update_Z | 12.796 | 1.708

## Route Congestions Report:

#### Report Command:report_route_congestion -max_grids 10

GRID LOC | ROUTE CONGESTIONS
R2C2 | 100.00%
R2C3 | 100.00%
R2C5 | 100.00%
R2C6 | 100.00%
R2C22 | 100.00%
R2C54 | 100.00%
R4C10 | 100.00%
R6C30 | 100.00%
R12C6 | 100.00%
R22C8 | 100.00%

## Timing Exceptions Report:

### Setup Analysis Report

#### Report Command:report_exceptions -setup -max_paths 5 -max_common_paths 1

#### Timing Path Constraint[1]: set_multicycle_path 2 -setup -from [get_clocks {usb_core_phase}] -to [get_ports {ulpi_stp ulpi_data[*]}]

### Path1

Path Summary:

Slack | 1.211
Data Arrival Time | 26.588
Data Required Time | 27.799
From | host/host_0/enum/sie/translator/queue/r_rdy_s1
To | ulpi_data_0_iobuf
Launch Clk | usb_core_phase:[R]
Latch Clk | ulpi_clk:[R]

Data Arrival Path:

AT | DELAY | TYPE | RF | FANOUT | LOC | NODE
14.584 | 14.584 | | | | | active clock edge time
14.584 | 0.000 | | | | | usb_core_phase
14.584 | 0.000 | tCL | RR | 886 | PLL_R[0] | usb_pll/CLKOUTP
16.855 | 2.271 | tNET | RR | 1 | R33C23[0][A] | host/host_0/enum/sie/translator/queue/r_rdy_s1/CLK
17.087 | 0.232 | tC2Q | RF | 6 | R33C23[0][A] | host/host_0/enum/sie/translator/queue/r_rdy_s1/Q
18.157 | 1.070 | tNET | FF | 1 | R31C19[1][B] | host/host_0/enum/sie/translator/phy/ulpi_data_o_6_s4/I2
18.528 | 0.371 | tINS | FF | 4 | R31C19[1][B] | host/host_0/enum/sie/translator/phy/ulpi_data_o_6_s4/F
19.101 | 0.573 | tNET | FF | 1 | R32C20[3][A] | host/host_0/enum/sie/translator/phy/ulpi_data_o_3_s2/I1
19.671 | 0.570 | tINS | FR | 4 | R32C20[3][A] | host/host_0/enum/sie/translator/phy/ulpi_data_o_3_s2/F
19.677 | 0.005 | tNET | RR | 1 | R32C20[1][B] | host/host_0/enum/sie/translator/phy/ulpi_data_o_0_s1/I0
20.130 | 0.453 | tINS | RF | 1 | R32C20[1][B] | host/host_0/enum/sie/translator/phy/ulpi_data_o_0_s1/F
20.786 | 0.656 | tNET | FF | 1 | R29C19[0][A] | host/host_0/enum/sie/translator/phy/ulpi_data_o_0_s0/I0
21.303 | 0.517 | tINS | FF | 1 | R29C19[0][A] | host/host_0/enum/sie/translator/phy/ulpi_data_o_0_s0/F
22.904 | 1.602 | tNET | FF | 1 | IOT14[A] | ulpi_data_0_iobuf/I
26.588 | 3.684 | tINS | FF | 1 | IOT14[A] | ulpi_data_0_iobuf/IO

Data Required Path:

AT | DELAY | TYPE | RF | FANOUT | LOC | NODE
33.334 | 33.334 | | | | | active clock edge time
33.334 | 0.000 | | | | | ulpi_clk
33.299 | -0.035 | tUnc | | | | ulpi_data_0_iobuf
27.799 | -5.500 | tOut | | | IOT14[A] | ulpi_data_0_iobuf

Path Statistics:

Clock Skew | -2.271
Setup Relationship | 18.750
Logic Level | 6
Arrival Clock Path Delay | cell: 0.000, 0.000%; route: 2.271, 100.000%
Arrival Data Path Delay | cell: 5.595, 57.484%; route: 3.906, 40.133%; tC2Q: 0.232, 2.384%
Required Clock Path Delay | cell: 0.000, 0.000%; route: 0.000, 0.000%

### Path2

Path Summary:

Slack | 1.284
Data Arrival Time | 26.515
Data Required Time | 27.799
From | host/host_0/enum/sie/translator/queue/r_rdy_s1
To | ulpi_data_1_iobuf
Launch Clk | usb_core_phase:[R]
Latch Clk | ulpi_clk:[R]

Data Arrival Path:

AT | DELAY | TYPE | RF | FANOUT | LOC | NODE
14.584 | 14.584 | | | | | active clock edge time
14.584 | 0.000 | | | | | usb_core_phase
14.584 | 0.000 | tCL | RR | 886 | PLL_R[0] | usb_pll/CLKOUTP
16.855 | 2.271 | tNET | RR | 1 | R33C23[0][A] | host/host_0/enum/sie/translator/queue/r_rdy_s1/CLK
17.087 | 0.232 | tC2Q | RF | 6 | R33C23[0][A] | host/host_0/enum/sie/translator/queue/r_rdy_s1/Q
18.157 | 1.070 | tNET | FF | 1 | R31C19[1][B] | host/host_0/enum/sie/translator/phy/ulpi_data_o_6_s4/I2
18.528 | 0.371 | tINS | FF | 4 | R31C19[1][B] | host/host_0/enum/sie/translator/phy/ulpi_data_o_6_s4/F
19.101 | 0.573 | tNET | FF | 1 | R32C20[3][A] | host/host_0/enum/sie/translator/phy/ulpi_data_o_3_s2/I1
19.671 | 0.570 | tINS | FR | 4 | R32C20[3][A] | host/host_0/enum/sie/translator/phy/ulpi_data_o_3_s2/F
19.677 | 0.005 | tNET | RR | 1 | R32C20[3][B] | host/host_0/enum/sie/translator/phy/ulpi_data_o_1_s1/I0
20.130 | 0.453 | tINS | RF | 1 | R32C20[3][B] | host/host_0/enum/sie/translator/phy/ulpi_data_o_1_s1/F
20.769 | 0.640 | tNET | FF | 1 | R30C19[3][B] | host/host_0/enum/sie/translator/phy/ulpi_data_o_1_s0/I0
21.140 | 0.371 | tINS | FF | 1 | R30C19[3][B] | host/host_0/enum/sie/translator/phy/ulpi_data_o_1_s0/F
22.831 | 1.691 | tNET | FF | 1 | IOT14[B] | ulpi_data_1_iobuf/I
26.515 | 3.684 | tINS | FF | 1 | IOT14[B] | ulpi_data_1_iobuf/IO

Data Required Path:

AT | DELAY | TYPE | RF | FANOUT | LOC | NODE
33.334 | 33.334 | | | | | active clock edge time
33.334 | 0.000 | | | | | ulpi_clk
33.299 | -0.035 | tUnc | | | | ulpi_data_1_iobuf
27.799 | -5.500 | tOut | | | IOT14[B] | ulpi_data_1_iobuf

Path Statistics:

Clock Skew | -2.271
Setup Relationship | 18.750
Logic Level | 6
Arrival Clock Path Delay | cell: 0.000, 0.000%; route: 2.271, 100.000%
Arrival Data Path Delay | cell: 5.449, 56.406%; route: 3.979, 41.193%; tC2Q: 0.232, 2.402%
Required Clock Path Delay | cell: 0.000, 0.000%; route: 0.000, 0.000%

### Path3

Path Summary:

Slack | 1.520
Data Arrival Time | 26.279
Data Required Time | 27.799
From | host/host_0/enum/sie/translator/queue/r_rdy_s1
To | ulpi_data_2_iobuf
Launch Clk | usb_core_phase:[R]
Latch Clk | ulpi_clk:[R]

Data Arrival Path:

AT | DELAY | TYPE | RF | FANOUT | LOC | NODE
14.584 | 14.584 | | | | | active clock edge time
14.584 | 0.000 | | | | | usb_core_phase
14.584 | 0.000 | tCL | RR | 886 | PLL_R[0] | usb_pll/CLKOUTP
16.855 | 2.271 | tNET | RR | 1 | R33C23[0][A] | host/host_0/enum/sie/translator/queue/r_rdy_s1/CLK
17.087 | 0.232 | tC2Q | RF | 6 | R33C23[0][A] | host/host_0/enum/sie/translator/queue/r_rdy_s1/Q
18.157 | 1.070 | tNET | FF | 1 | R31C19[1][B] | host/host_0/enum/sie/translator/phy/ulpi_data_o_6_s4/I2
18.528 | 0.371 | tINS | FF | 4 | R31C19[1][B] | host/host_0/enum/sie/translator/phy/ulpi_data_o_6_s4/F
19.101 | 0.573 | tNET | FF | 1 | R32C20[3][A] | host/host_0/enum/sie/translator/phy/ulpi_data_o_3_s2/I1
19.671 | 0.570 | tINS | FR | 4 | R32C20[3][A] | host/host_0/enum/sie/translator/phy/ulpi_data_o_3_s2/F
19.677 | 0.005 | tNET | RR | 1 | R32C20[1][A] | host/host_0/enum/sie/translator/phy/ulpi_data_o_2_s1/I0
20.130 | 0.453 | tINS | RF | 1 | R32C20[1][A] | host/host_0/enum/sie/translator/phy/ulpi_data_o_2_s1/F
20.543 | 0.413 | tNET | FF | 1 | R30C19[0][A] | host/host_0/enum/sie/translator/phy/ulpi_data_o_2_s0/I0
21.098 | 0.555 | tINS | FF | 1 | R30C19[0][A] | host/host_0/enum/sie/translator/phy/ulpi_data_o_2_s0/F
22.595 | 1.497 | tNET | FF | 1 | IOT18[B] | ulpi_data_2_iobuf/I
26.279 | 3.684 | tINS | FF | 1 | IOT18[B] | ulpi_data_2_iobuf/IO

Data Required Path:

AT | DELAY | TYPE | RF | FANOUT | LOC | NODE
33.334 | 33.334 | | | | | active clock edge time
33.334 | 0.000 | | | | | ulpi_clk
33.299 | -0.035 | tUnc | | | | ulpi_data_2_iobuf
27.799 | -5.500 | tOut | | | IOT18[B] | ulpi_data_2_iobuf

Path Statistics:

Clock Skew | -2.271
Setup Relationship | 18.750
Logic Level | 6
Arrival Clock Path Delay | cell: 0.000, 0.000%; route: 2.271, 100.000%
Arrival Data Path Delay | cell: 5.633, 59.775%; route: 3.559, 37.763%; tC2Q: 0.232, 2.462%
Required Clock Path Delay | cell: 0.000, 0.000%; route: 0.000, 0.000%

### Path4

Path Summary:

Slack | 1.704
Data Arrival Time | 26.095
Data Required Time | 27.799
From | host/host_0/enum/sie/translator/queue/r_rdy_s1
To | ulpi_data_3_iobuf
Launch Clk | usb_core_phase:[R]
Latch Clk | ulpi_clk:[R]

Data Arrival Path:

AT | DELAY | TYPE | RF | FANOUT | LOC | NODE
14.584 | 14.584 | | | | | active clock edge time
14.584 | 0.000 | | | | | usb_core_phase
14.584 | 0.000 | tCL | RR | 886 | PLL_R[0] | usb_pll/CLKOUTP
16.855 | 2.271 | tNET | RR | 1 | R33C23[0][A] | host/host_0/enum/sie/translator/queue/r_rdy_s1/CLK
17.087 | 0.232 | tC2Q | RF | 6 | R33C23[0][A] | host/host_0/enum/sie/translator/queue/r_rdy_s1/Q
18.157 | 1.070 | tNET | FF | 1 | R31C19[1][B] | host/host_0/enum/sie/translator/phy/ulpi_data_o_6_s4/I2
18.528 | 0.371 | tINS | FF | 4 | R31C19[1][B] | host/host_0/enum/sie/translator/phy/ulpi_data_o_6_s4/F
19.101 | 0.573 | tNET | FF | 1 | R32C20[3][A] | host/host_0/enum/sie/translator/phy/ulpi_data_o_3_s2/I1
19.671 | 0.570 | tINS | FR | 4 | R32C20[3][A] | host/host_0/enum/sie/translator/phy/ulpi_data_o_3_s2/F
19.677 | 0.005 | tNET | RR | 1 | R32C20[2][A] | host/host_0/enum/sie/translator/phy/ulpi_data_o_3_s1/I0
20.130 | 0.453 | tINS | RF | 1 | R32C20[2][A] | host/host_0/enum/sie/translator/phy/ulpi_data_o_3_s1/F
20.543 | 0.413 | tNET | FF | 1 | R30C19[0][B] | host/host_0/enum/sie/translator/phy/ulpi_data_o_3_s0/I0
20.914 | 0.371 | tINS | FF | 1 | R30C19[0][B] | host/host_0/enum/sie/translator/phy/ulpi_data_o_3_s0/F
22.411 | 1.497 | tNET | FF | 1 | IOT18[A] | ulpi_data_3_iobuf/I
26.095 | 3.684 | tINS | FF | 1 | IOT18[A] | ulpi_data_3_iobuf/IO

Data Required Path:

AT | DELAY | TYPE | RF | FANOUT | LOC | NODE
33.334 | 33.334 | | | | | active clock edge time
33.334 | 0.000 | | | | | ulpi_clk
33.299 | -0.035 | tUnc | | | | ulpi_data_3_iobuf
27.799 | -5.500 | tOut | | | IOT18[A] | ulpi_data_3_iobuf

Path Statistics:

Clock Skew | -2.271
Setup Relationship | 18.750
Logic Level | 6
Arrival Clock Path Delay | cell: 0.000, 0.000%; route: 2.271, 100.000%
Arrival Data Path Delay | cell: 5.449, 58.974%; route: 3.559, 38.515%; tC2Q: 0.232, 2.511%
Required Clock Path Delay | cell: 0.000, 0.000%; route: 0.000, 0.000%

### Path5

Path Summary:

Slack | 1.932
Data Arrival Time | 25.867
Data Required Time | 27.799
From | host/host_0/enum/sie/translator/queue/r_rdy_s1
To | ulpi_data_6_iobuf
Launch Clk | usb_core_phase:[R]
Latch Clk | ulpi_clk:[R]

Data Arrival Path:

AT | DELAY | TYPE | RF | FANOUT | LOC | NODE
14.584 | 14.584 | | | | | active clock edge time
14.584 | 0.000 | | | | | usb_core_phase
14.584 | 0.000 | tCL | RR | 886 | PLL_R[0] | usb_pll/CLKOUTP
16.855 | 2.271 | tNET | RR | 1 | R33C23[0][A] | host/host_0/enum/sie/translator/queue/r_rdy_s1/CLK
17.087 | 0.232 | tC2Q | RF | 6 | R33C23[0][A] | host/host_0/enum/sie/translator/queue/r_rdy_s1/Q
18.157 | 1.070 | tNET | FF | 1 | R31C19[1][B] | host/host_0/enum/sie/translator/phy/ulpi_data_o_6_s4/I2
18.528 | 0.371 | tINS | FF | 4 | R31C19[1][B] | host/host_0/enum/sie/translator/phy/ulpi_data_o_6_s4/F
18.952 | 0.423 | tNET | FF | 1 | R29C20[2][B] | host/host_0/enum/sie/translator/phy/ulpi_data_o_6_s2/I2
19.522 | 0.570 | tINS | FR | 1 | R29C20[2][B] | host/host_0/enum/sie/translator/phy/ulpi_data_o_6_s2/F
19.523 | 0.001 | tNET | RR | 1 | R29C20[2][A] | host/host_0/enum/sie/translator/phy/ulpi_data_o_6_s0/I1
20.040 | 0.517 | tINS | RF | 1 | R29C20[2][A] | host/host_0/enum/sie/translator/phy/ulpi_data_o_6_s0/F
22.183 | 2.143 | tNET | FF | 1 | IOR11[B] | ulpi_data_6_iobuf/I
25.867 | 3.684 | tINS | FF | 1 | IOR11[B] | ulpi_data_6_iobuf/IO

Data Required Path:

AT | DELAY | TYPE | RF | FANOUT | LOC | NODE
33.334 | 33.334 | | | | | active clock edge time
33.334 | 0.000 | | | | | ulpi_clk
33.299 | -0.035 | tUnc | | | | ulpi_data_6_iobuf
27.799 | -5.500 | tOut | | | IOR11[B] | ulpi_data_6_iobuf

Path Statistics:

Clock Skew | -2.271
Setup Relationship | 18.750
Logic Level | 5
Arrival Clock Path Delay | cell: 0.000, 0.000%; route: 2.271, 100.000%
Arrival Data Path Delay | cell: 5.142, 57.056%; route: 3.638, 40.370%; tC2Q: 0.232, 2.574%
Required Clock Path Delay | cell: 0.000, 0.000%; route: 0.000, 0.000%

### Hold Analysis Report

#### Report Command:report_exceptions -hold -max_paths 5 -max_common_paths 1

#### Timing Path Constraint[1]: set_multicycle_path 1 -hold -from [get_clocks {usb_core_phase}] -to [get_ports {ulpi_stp ulpi_data[*]}]

### Path1

Path Summary:

Slack | 18.118
Data Arrival Time | 35.320
Data Required Time | 17.202
From | usb_reset_1_s0
To | ulpi_data_3_iobuf
Launch Clk | usb_core_phase:[R]
Latch Clk | ulpi_clk:[R]

Data Arrival Path:

AT | DELAY | TYPE | RF | FANOUT | LOC | NODE
31.251 | 31.251 | | | | | active clock edge time
31.251 | 0.000 | | | | | usb_core_phase
31.251 | 0.000 | tCL | RR | 886 | PLL_R[0] | usb_pll/CLKOUTP
32.762 | 1.511 | tNET | RR | 1 | R20C39[1][A] | usb_reset_1_s0/CLK
32.964 | 0.202 | tC2Q | RR | 620 | R20C39[1][A] | usb_reset_1_s0/Q
33.969 | 1.005 | tNET | RR | 1 | R16C17[3][A] | ulpi_data_0_s3/I0
34.204 | 0.235 | tINS | RR | 8 | R16C17[3][A] | ulpi_data_0_s3/F
34.782 | 0.578 | tNET | RR | 1 | IOT18[A] | ulpi_data_3_iobuf/OEN
35.320 | 0.539 | tINS | RR | 1 | IOT18[A] | ulpi_data_3_iobuf/IO

Data Required Path:

AT | DELAY | TYPE | RF | FANOUT | LOC | NODE
16.667 | 16.667 | | | | | active clock edge time
16.667 | 0.000 | | | | | ulpi_clk
16.702 | 0.035 | tUnc | | | | ulpi_data_3_iobuf
17.202 | 0.500 | tOut | | | IOT18[A] | ulpi_data_3_iobuf

Path Statistics:

Clock Skew | -1.511
Hold Relationship | -14.584
Logic Level | 3
Arrival Clock Path Delay | cell: 0.000, 0.000%; route: 1.511, 100.000%
Arrival Data Path Delay | cell: 0.774, 30.236%; route: 1.583, 61.868%; tC2Q: 0.202, 7.896%
Required Clock Path Delay | cell: 0.000, 0.000%; route: 0.000, 0.000%

### Path2

Path Summary:

Slack | 18.118
Data Arrival Time | 35.320
Data Required Time | 17.202
From | usb_reset_1_s0
To | ulpi_data_2_iobuf
Launch Clk | usb_core_phase:[R]
Latch Clk | ulpi_clk:[R]

Data Arrival Path:

AT | DELAY | TYPE | RF | FANOUT | LOC | NODE
31.251 | 31.251 | | | | | active clock edge time
31.251 | 0.000 | | | | | usb_core_phase
31.251 | 0.000 | tCL | RR | 886 | PLL_R[0] | usb_pll/CLKOUTP
32.762 | 1.511 | tNET | RR | 1 | R20C39[1][A] | usb_reset_1_s0/CLK
32.964 | 0.202 | tC2Q | RR | 620 | R20C39[1][A] | usb_reset_1_s0/Q
33.969 | 1.005 | tNET | RR | 1 | R16C17[3][A] | ulpi_data_0_s3/I0
34.204 | 0.235 | tINS | RR | 8 | R16C17[3][A] | ulpi_data_0_s3/F
34.782 | 0.578 | tNET | RR | 1 | IOT18[B] | ulpi_data_2_iobuf/OEN
35.320 | 0.539 | tINS | RR | 1 | IOT18[B] | ulpi_data_2_iobuf/IO

Data Required Path:

AT | DELAY | TYPE | RF | FANOUT | LOC | NODE
16.667 | 16.667 | | | | | active clock edge time
16.667 | 0.000 | | | | | ulpi_clk
16.702 | 0.035 | tUnc | | | | ulpi_data_2_iobuf
17.202 | 0.500 | tOut | | | IOT18[B] | ulpi_data_2_iobuf

Path Statistics:

Clock Skew | -1.511
Hold Relationship | -14.584
Logic Level | 3
Arrival Clock Path Delay | cell: 0.000, 0.000%; route: 1.511, 100.000%
Arrival Data Path Delay | cell: 0.774, 30.236%; route: 1.583, 61.868%; tC2Q: 0.202, 7.896%
Required Clock Path Delay | cell: 0.000, 0.000%; route: 0.000, 0.000%

### Path3

Path Summary:

Slack | 18.365
Data Arrival Time | 35.567
Data Required Time | 17.202
From | usb_reset_1_s0
To | ulpi_data_0_iobuf
Launch Clk | usb_core_phase:[R]
Latch Clk | ulpi_clk:[R]

Data Arrival Path:

AT | DELAY | TYPE | RF | FANOUT | LOC | NODE
31.251 | 31.251 | | | | | active clock edge time
31.251 | 0.000 | | | | | usb_core_phase
31.251 | 0.000 | tCL | RR | 886 | PLL_R[0] | usb_pll/CLKOUTP
32.762 | 1.511 | tNET | RR | 1 | R20C39[1][A] | usb_reset_1_s0/CLK
32.964 | 0.202 | tC2Q | RR | 620 | R20C39[1][A] | usb_reset_1_s0/Q
33.969 | 1.005 | tNET | RR | 1 | R16C17[3][A] | ulpi_data_0_s3/I0
34.204 | 0.235 | tINS | RR | 8 | R16C17[3][A] | ulpi_data_0_s3/F
35.029 | 0.825 | tNET | RR | 1 | IOT14[A] | ulpi_data_0_iobuf/OEN
35.567 | 0.539 | tINS | RR | 1 | IOT14[A] | ulpi_data_0_iobuf/IO

Data Required Path:

AT | DELAY | TYPE | RF | FANOUT | LOC | NODE
16.667 | 16.667 | | | | | active clock edge time
16.667 | 0.000 | | | | | ulpi_clk
16.702 | 0.035 | tUnc | | | | ulpi_data_0_iobuf
17.202 | 0.500 | tOut | | | IOT14[A] | ulpi_data_0_iobuf

Path Statistics:

Clock Skew | -1.511
Hold Relationship | -14.584
Logic Level | 3
Arrival Clock Path Delay | cell: 0.000, 0.000%; route: 1.511, 100.000%
Arrival Data Path Delay | cell: 0.774, 27.574%; route: 1.830, 65.225%; tC2Q: 0.202, 7.201%
Required Clock Path Delay | cell: 0.000, 0.000%; route: 0.000, 0.000%

### Path4

Path Summary:

Slack | 18.491
Data Arrival Time | 35.693
Data Required Time | 17.202
From | usb_reset_1_s0
To | ulpi_data_1_iobuf
Launch Clk | usb_core_phase:[R]
Latch Clk | ulpi_clk:[R]

Data Arrival Path:

AT | DELAY | TYPE | RF | FANOUT | LOC | NODE
31.251 | 31.251 | | | | | active clock edge time
31.251 | 0.000 | | | | | usb_core_phase
31.251 | 0.000 | tCL | RR | 886 | PLL_R[0] | usb_pll/CLKOUTP
32.762 | 1.511 | tNET | RR | 1 | R20C39[1][A] | usb_reset_1_s0/CLK
32.964 | 0.202 | tC2Q | RR | 620 | R20C39[1][A] | usb_reset_1_s0/Q
33.969 | 1.005 | tNET | RR | 1 | R16C17[3][A] | ulpi_data_0_s3/I0
34.204 | 0.235 | tINS | RR | 8 | R16C17[3][A] | ulpi_data_0_s3/F
35.155 | 0.951 | tNET | RR | 1 | IOT14[B] | ulpi_data_1_iobuf/OEN
35.693 | 0.539 | tINS | RR | 1 | IOT14[B] | ulpi_data_1_iobuf/IO

Data Required Path:

AT | DELAY | TYPE | RF | FANOUT | LOC | NODE
16.667 | 16.667 | | | | | active clock edge time
16.667 | 0.000 | | | | | ulpi_clk
16.702 | 0.035 | tUnc | | | | ulpi_data_1_iobuf
17.202 | 0.500 | tOut | | | IOT14[B] | ulpi_data_1_iobuf

Path Statistics:

Clock Skew | -1.511
Hold Relationship | -14.584
Logic Level | 3
Arrival Clock Path Delay | cell: 0.000, 0.000%; route: 1.511, 100.000%
Arrival Data Path Delay | cell: 0.774, 26.389%; route: 1.956, 66.720%; tC2Q: 0.202, 6.891%
Required Clock Path Delay | cell: 0.000, 0.000%; route: 0.000, 0.000%

### Path5

Path Summary:

Slack | 18.539
Data Arrival Time | 35.741
Data Required Time | 17.202
From | usb_reset_1_s0
To | ulpi_data_5_iobuf
Launch Clk | usb_core_phase:[R]
Latch Clk | ulpi_clk:[R]

Data Arrival Path:

AT | DELAY | TYPE | RF | FANOUT | LOC | NODE
31.251 | 31.251 | | | | | active clock edge time
31.251 | 0.000 | | | | | usb_core_phase
31.251 | 0.000 | tCL | RR | 886 | PLL_R[0] | usb_pll/CLKOUTP
32.762 | 1.511 | tNET | RR | 1 | R20C39[1][A] | usb_reset_1_s0/CLK
32.964 | 0.202 | tC2Q | RR | 620 | R20C39[1][A] | usb_reset_1_s0/Q
33.969 | 1.005 | tNET | RR | 1 | R16C17[3][A] | ulpi_data_0_s3/I0
34.204 | 0.235 | tINS | RR | 8 | R16C17[3][A] | ulpi_data_0_s3/F
35.203 | 0.999 | tNET | RR | 1 | IOR20[A] | ulpi_data_5_iobuf/OEN
35.741 | 0.539 | tINS | RR | 1 | IOR20[A] | ulpi_data_5_iobuf/IO

Data Required Path:

AT | DELAY | TYPE | RF | FANOUT | LOC | NODE
16.667 | 16.667 | | | | | active clock edge time
16.667 | 0.000 | | | | | ulpi_clk
16.702 | 0.035 | tUnc | | | | ulpi_data_5_iobuf
17.202 | 0.500 | tOut | | | IOR20[A] | ulpi_data_5_iobuf

Path Statistics:

Clock Skew | -1.511
Hold Relationship | -14.584
Logic Level | 3
Arrival Clock Path Delay | cell: 0.000, 0.000%; route: 1.511, 100.000%
Arrival Data Path Delay | cell: 0.774, 25.963%; route: 2.004, 67.257%; tC2Q: 0.202, 6.780%
Required Clock Path Delay | cell: 0.000, 0.000%; route: 0.000, 0.000%

### Recovery Analysis Report

#### Report Command:report_exceptions -recovery -max_paths 5 -max_common_paths 1

#### Timing Path Constraint[1]: set_multicycle_path 2 -setup -from [get_clocks {usb_core_phase}] -to [get_ports {ulpi_stp ulpi_data[*]}]

#### No timing paths to report!

### Removal Analysis Report

#### Report Command:report_exceptions -removal -max_paths 5 -max_common_paths 1

#### Timing Path Constraint[1]: set_multicycle_path 1 -hold -from [get_clocks {usb_core_phase}] -to [get_ports {ulpi_stp ulpi_data[*]}]

#### No timing paths to report!

## Timing Constraints Report:

SDC Command Type | State | Detail Command
TC_CLOCK | Actived | create_clock -name ulpi_clk -period 16.667 -waveform {0 8.333} [get_ports {ulpi_clk}]
TC_CLOCK | Actived | create_clock -name clk -period 37.037 -waveform {0 18.518} [get_ports {clk}]
TC_GENERATED_CLOCK | Actived | create_generated_clock -name usb_core_phase -source [get_ports {ulpi_clk}] -divide_by 1 -phase 315 [get_pins {usb_pll/CLKOUTP}]
TC_INPUT_DELAY | Actived | set_input_delay -clock ulpi_clk -max 4.0 [get_ports {ulpi_dir ulpi_nxt ulpi_data[*]}]
TC_INPUT_DELAY | Actived | set_input_delay -clock ulpi_clk -min 1.0 [get_ports {ulpi_dir ulpi_nxt ulpi_data[*]}]
TC_OUTPUT_DELAY | Actived | set_output_delay -clock ulpi_clk -max 5.5 [get_ports {ulpi_stp ulpi_data[*]}]
TC_OUTPUT_DELAY | Actived | set_output_delay -clock ulpi_clk -min -0.5 [get_ports {ulpi_stp ulpi_data[*]}]
TC_FALSE_PATH | Actived | set_false_path -from [get_clocks {clk}] -to [get_clocks {ulpi_clk}]
TC_FALSE_PATH | Actived | set_false_path -from [get_clocks {clk}] -to [get_clocks {usb_core_phase}]
TC_MULTICYCLE | Actived | set_multicycle_path 2 -setup -from [get_clocks {usb_core_phase}] -to [get_ports {ulpi_stp ulpi_data[*]}]
TC_MULTICYCLE | Actived | set_multicycle_path 1 -hold -from [get_clocks {usb_core_phase}] -to [get_ports {ulpi_stp ulpi_data[*]}]
