myfines/d-dfdf/instrument_io/instrument_extension_top.v

`timescale 1ns/1ps
module instrument_extension_top(input wire clk,input wire [3:0] btn_n,input wire JOY_SW_N,
 inout wire ADC_SCL,ADC_SDA,OPTICAL_SCL,OPTICAL_SDA,OLED_SCL,OLED_SDA,input wire ESP_RX,K230_RX,
 output wire PCM_BCK,PCM_LRCK,PCM_DATA,PA_EN,HP_BCK,HP_WS,HP_DIN,LED_ALIVE,LED_ADC,UART_TX,ESP_TX);
 instrument_io #(.SAFE_STARTUP(1),.ENABLE_OPTICAL(1),.OPTICAL_ACTIVE_LOW(0),.ENABLE_UI(1),.ENABLE_GESTURE(1)) core(
 .clk(clk),.btn_n(btn_n),.JOY_SW_N(JOY_SW_N),.ADC_SCL(ADC_SCL),.ADC_SDA(ADC_SDA),
 .OPTICAL_SCL(OPTICAL_SCL),.OPTICAL_SDA(OPTICAL_SDA),.OLED_SCL(OLED_SCL),.OLED_SDA(OLED_SDA),
 .K230_RX(K230_RX),.ESP_RX(ESP_RX),.ESP_TX(ESP_TX),.PCM_BCK(PCM_BCK),.PCM_LRCK(PCM_LRCK),.PCM_DATA(PCM_DATA),
 .PA_EN(PA_EN),.HP_BCK(HP_BCK),.HP_WS(HP_WS),.HP_DIN(HP_DIN),.LED_ALIVE(LED_ALIVE),.LED_ADC(LED_ADC),.UART_TX(UART_TX));
endmodule
