myfines/d-dfdf/scripts/libwdi-config.h

#define WDK_DIR "E:/gaoyun/tools/libwdi-redist"
#define WDF_VER 1009
#define COINSTALLER_DIR "wdf"
#define X64_DIR "amd64"
#define OPT_M64 1
#define ENABLE_LOGGING 1
#define INCLUDE_DEBUG_LOGGING 1
#define _GNU_SOURCE 1
