myfines/d-dfdf/(commit log)

2026-09-26 Document FPGA bring-up history and current USB detection status
2026-09-26 Record SRAM retry and isolate Windows JTAG driver incompatibility
2026-09-26 Record current FTDI bindings and read-only USB probe
2026-09-26 Install WinUSB on JTAG A through audited CLI and record reset failure
    [libwdi-config.h]
2026-09-26 Record successful direct-USB SRAM configuration and restore UART B
2026-09-26 Confirm LED2 blink observed by user and close bring-up record
2026-09-26 Plan contest-compliant synthesizer and staged peripheral purchases
2026-09-28 Fix audio_probe SDC line endings and load probe to SRAM
    [audio_probe.v, tb_audio_probe.sv]
2026-09-28 Add four-key tone design, fix probe I/O type, record SRAM loss and flash survey
    [audio_keys.v, audio_probe.v, tb_audio_keys.sv, tb_audio_probe.sv]
2026-09-29 Record power-off context for S0 and S4 diagnosis
2026-09-29 Correct RCFG button mapping and record SRAM audio recovery
2026-09-29 Record interrupted external flash programming attempt
2026-09-29 Record second stalled Flash attempt and recovery state
2026-09-30 Prepare reversible FTDI A driver trial
2026-09-30 Record official Gowin JTAG scan via FTDI driver
2026-10-11 Document ADS1015 joystick and PCM5102A wiring plan
2026-10-11 Identify matching PCM5102A module power documentation
2026-10-11 Clarify Dock OTG and DAC power wiring options
2026-10-11 Clarify chip versus module 3.3V supply requirements
2026-10-11 Use seller-confirmed 3.3V input for PCM5102A module
2026-10-12 Add isolated PCM tone and onboard audio diagnostic with UART status
2026-10-12 Preserve raw diagnostic UART bytes
2026-10-12 Record external PCM silence and plan isolated USB power comparison
2026-10-12 Record same diagnostic SRAM reload with PCM USB power
2026-10-12 Record PCM USB power audio success and reload instrument SRAM
2026-10-12 Record user acceptance of instrument SRAM test with USB powered PCM
2026-10-12 Record unchanged S3 sampled input and request control key comparison
2026-10-12 Correct stale UART diagnosis and verify low active S3 input
2026-10-12 Document official enable switch warning and supported Flash procedures
2026-10-12 Honor corrected polyphonic Flash target and record interrupted attempts
2026-10-12 Audit current instrument against official competition requirements
2026-10-12 Implement and validate four stage ADSR envelopes for polyphonic voices
2026-10-12 Complete current hardware instrument with runtime controls and 32 voice diagnostics
2026-10-12 Investigate rapid heating offline, stop idle DSP activity and hold hardware deployment
2026-10-12 Record same-board heat references and distinguish factory DDR case
2026-10-12 Record similar Primer heating and load-dependent instability reports with limits
2026-10-12 Specify independent I2C optical keyboard wiring from supplied module manual
2026-10-12 Clarify 5V sensor supply options and ST Link voltage reference distinction
2026-10-12 Document pictured ST Link 5V pin labels and required common ground
2026-10-12 Map labeled ST Link 5V pins and explicit common ground for optical module
2026-10-12 Document labeled ST Link supply wiring and distinguish I2C logic voltage
2026-10-12 Publish consolidated wiring for all instrument modules and dual ground ST Link supply
2026-10-12 Clarify isolated optical calibration and independent supply sequencing limits
2026-10-13 Record staged SRAM diagnostic after sensor supply change
2026-10-13 Record successful arming and optical I2C response
2026-10-13 Clarify board key behavior after optical module returns online
2026-10-15 Verify isolated X8 C6 and complete default eight-key pitch checks
2026-10-15 Record joystick pitch bend and harmonic variation from DAC audio
2026-10-17 docs: record optical-key UART test handoff and known limitations
2026-10-18 Add Android instrument preview and external audio monitor prototype
2026-10-18 Audit current instrument against official 2026 requirements
2026-10-18 Correct board and TDM assessment using supplied competition FAQ
2026-10-20 Map Dock PMOD1 OLED and ESP wiring with verified pin banks
2026-10-20 docs(k230): record CanMV USB identification and console probe
2026-10-20 docs(k230): verify camera snapshot and activate virtual display launcher
2026-10-21 docs(k230): verify Dock USB PHY and recommend powered UART link
2026-10-21 docs(k230): assess Dock OTG power and recommend separate-power UART link
2026-10-21 docs(k230): define single-source power and sequence-independent interfaces
2026-10-21 docs(k230): distinguish official USB device demo from Dock host precedent
2026-10-21 Organize project homepage and current release download index
2026-10-21 docs(k230): verify shared USB power-data host precedent and limits
2026-10-21 docs: record confirmed single-source K230 OTG wiring
2026-10-21 Simulate transport-independent K230 gesture frames and UART receiver
2026-10-21 Add offline K230 USB HS CDC host prototype and timing evidence
2026-10-21 Close USB host ULPI timing and validate E024 SRAM health on board
2026-10-22 feat(k230): prepare TX-only UART gesture sender candidate
2026-10-22 feat: integrate UART gesture expression and Android E025 companion
2026-10-22 docs: map K230 physical silkscreen and distinguish UART headers
2026-10-22 fix: correct M14 to PMOD1 inner row and add pin location diagram
2026-10-22 fix(k230): deploy UART sender with required RX input mux
2026-10-22 docs: trace pinch validity mismatch across tracker and UART gates
2026-10-22 fix(k230): send UART gestures synchronously with tracker frames
2026-10-22 fix: align FPGA gesture gate with single-frame K230 tracking
2026-10-23 docs: diagnose E023 boot and retain stalled SRAM restore evidence
